judapies/Autoclave/Autoclave Horizontal/Sin Precamara/2016/Autoclave 34L UPTC #004587579/Documentos/Pruebas Autoclave Microlab/IMG_5692.JPG

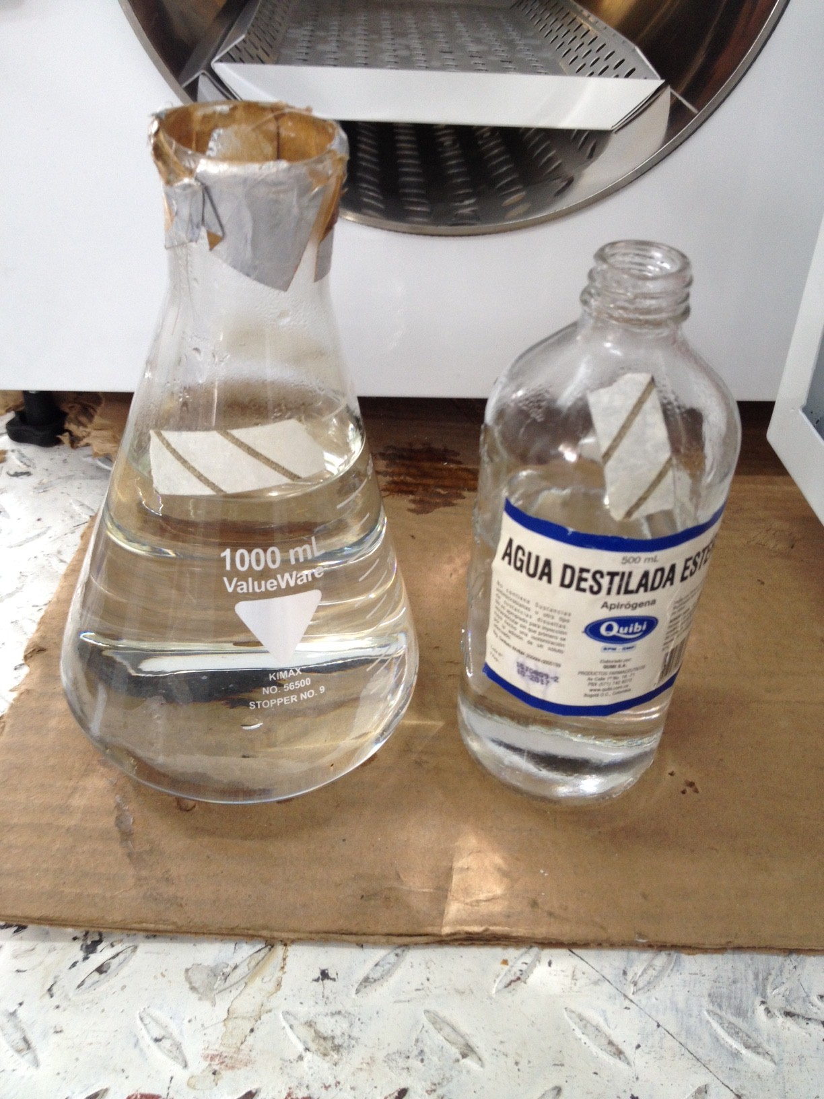
Autoclave Horizontal/Sin Precamara/2016/Autoclave 34L UPTC #004587579/Documentos/Pruebas Autoclave Microlab/IMG_5692.JPG
