judapies/Autoclave/Autoclave Horizontal/Sin Precamara/2020/Autoclave 23L Colsanitas #004588160 OP202001/Visita 23-04-2021/Notas.txt

Se cargaron 40 paquetes y aun quedaron espacios libre, la mariposa esta bastante desgastada
