judapies/Autoclave/Autoclave Horizontal/Sin Precamara/2021/Autoclave 23L Colsanitas #004588494 OP202152/Visita 14-05-2021/Notas.txt

Hicieron un ciclo con aproximadamente 60 paquetes,
Bandeja de arriba pegaba con el tanque se doblan hacia adentro primera fila para que no pegue. Se ajusta parada de emergencia suelta
