judapies/Autoclave/Autoclaves Vertical/Sin Precamara/2020/Autoclave 40L Artilab Impresora #004588218 OP2020135/Reporte de Mantenimiento #004588218_1.pdf

JP BIOINGENIERIA S.A.S

REPORTE DE MANTENIMIENTO

FJP – 68
Versión: 01

Pág. 1 de 5

PROCESO: MEDICIÓN DE SATISFACCIÓN DEL CLIENTE

Cliente: Laboratorios RYAN
Dirección: Celta Trade Park Kilómetro 7.5 Vía Medellín, Funza (Bodega 97A y 97B ) Ciudad: Funza, Cundinamarca
Nombre de Equipo: Autoclave 40 litros
Serial de Equipo: 004588218
Marca de Equipo: JP Inglobal
Modelo: 2020
Mantenimiento Preventivo: | ; Mantenimiento Correctivo: | X | (Si el mantenimiento es correctivo describa a
continuación la solicitud del mantenimiento)
Descripción: El equipo presento una fuga de presión por la parte de la puerta en las horas de la mañana del día 1/10/20 y se desajusto el empaque. Además se observa en el histórico de datos de los ciclos anteriores que el equipo presenta anormalidades en los valores de presión registrados durante los ciclos de esterilización.

### 1. Labores realizadas

Se realiza la inspección del equipo encontrando el empaque de la puerta desajustado, por lo cual se procede a ajustar realizando el sellado de este a la ranura de la puerta con silicona de alta temperatura, con el fin de no volver a presentar fuga alguna en el sello del empaque con el tanque del equipo.

Se realizaron varios ciclos al equipo encontrando una anormalidad en los datos de presión registrados, ya que el equipo al alcanzar el nivel óptimo de temperatura, su nivel de presión sigue aumentando durante el tiempo de esterilización, por tal razón se realizó un ajuste en los parámetros de control, además de hacer una observación sobre el sistema de desfogue del equipo ya que cuenta con un tanque en acero que no es el más indicado para el desfogue del equipo y que puede estar afectando su funcionamiento.

### 2. Pruebas Realizadas

- 5 Ciclos de líquidos B
- Verificación de niveles de agua.
- Verificación cierre de puerta
- Verificación de fugas

### 3. Datos Obtenidos

Posteriormente se retira el empaque y se aplica un cordón de silicona de alta temperatura en la ranura de la puerta, con el fin de que el empaque no salga de su posición y realice un sello hermético con el tanque del equipo. En las figuras 1 y 2 se puede ver como se pegó el empaque a la puerta.

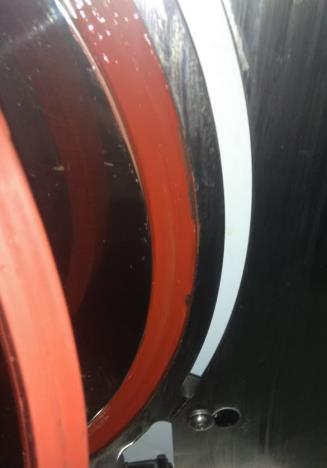
[picture p68: figure]
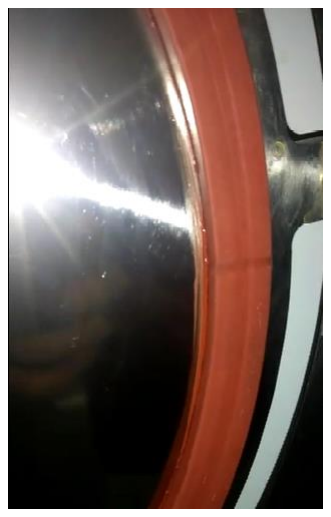
[picture p69: figure]

Figura 1. Cordón de silicona. | Figura 2. Empaque pegado.

JP BIOINGENIERIA S.A.S

REPORTE DE MANTENIMIENTO
Pág. 2 de 5

PROCESO: MEDICIÓN DE SATISFACCIÓN DEL CLIENTE

Posteriormente, se enciende el equipo, se carga con cajas de Petri envueltas en aluminio y a su vez recubiertas por una bolsa plástica corriente y una bolsa transparente utilizada para esterilización, se dispone a ejecutar el ciclo de líquidos
B. Se llena hasta el nivel de agua adecuado y se empieza el ciclo.

Se espera a que llegue a la temperatura de esterilización y se observa que antes de llegar a la temperatura deseada la presión del equipo sube sin mantener la relación con la temperatura por tal razón se decide activar la parada de emergencia para revisar la anormalidad presentada.

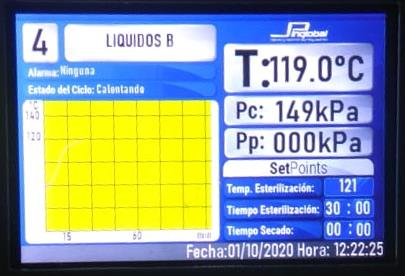
[picture p70: figure]

Figura 3. Ciclo líquidos B cancelado.

En la figura 3 se puede observar que el equipo ya está generando más presión al estar en 149 kPa o 21,6 PSI sin siquiera haber alcanzado su set point de temperatura.

Siguiente de esto se realiza un ajuste en los parámetros de control, buscando sacar la mayor cantidad de aire antes de empezar a generar presión dentro del tanque del equipo.

Se dispone a iniciar otro ciclo con la misma carga pero con los cambios anteriormente mencionados.

Después de su tiempo de calentamiento y al llegar al nivel adecuado de temperatura para empezar la esterilización se encuentra nuevamente que los valores de presión son anormales, a lo cual la persona de mantenimiento dice que sucede en la mayoría de los ciclos con carga de cajas de Petri, pero que en los ciclos donde el equipo se carga con otros materiales o en vacío el equipo funciona de manera correcta. En las figura 4,5 y 6 se puede observar la comparación de los ciclos realizados con una carga de cajas de Petri, sin carga y con una carga de 5 litros de líquidos.

JP BIOINGENIERIA S.A.S

REPORTE DE MANTENIMIENTO
Pág. 3 de 5

PROCESO: MEDICIÓN DE SATISFACCIÓN DEL CLIENTE

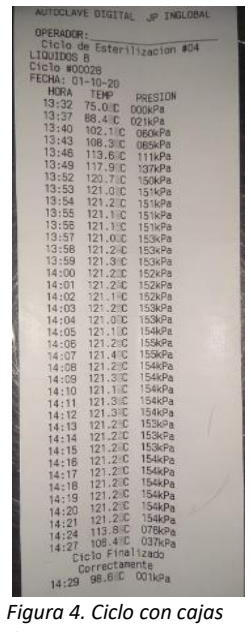
[picture p71: figure]
Figura 4. Ciclo con cajas
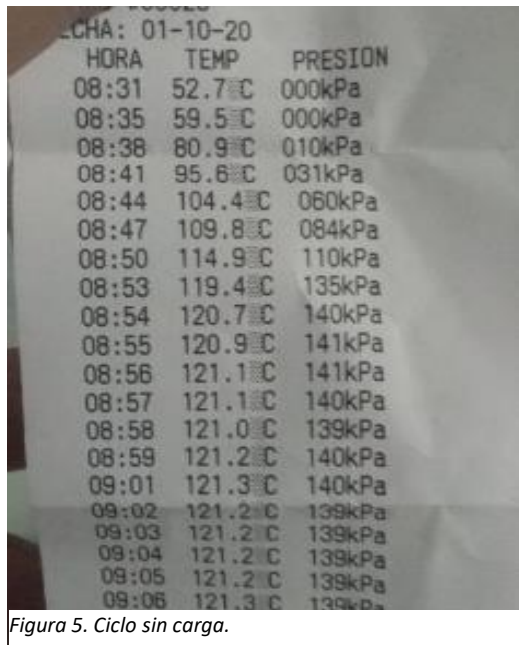
[picture p72: figure]
Figura 5. Ciclo sin carga.
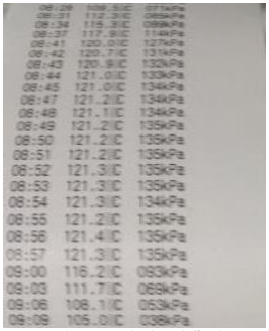
[picture p73: figure]

Figura 6. Ciclo con carga de 5 litros de líquidos.

Tabla 1. Comparativa de cargas en ciclos.

| Temperatura máxima (°C) | Presión máxima (kPa/PSI) | Fecha (DD/MM/AA) | ciclo
Ciclo con cajas de Petri (Figura 4 ) | 121.4 | 155/22.48 | 01/10/20 | Líquidos B
Ciclo con carga de 5 litros de líquidos (Figura 6 ) | 121.4 | 135/19.58 | 19/08/20 | Líquidos A
Ciclo sin carga (Figura 5) | 121.3 | 141/20.45 | 01/10/20 | Líquidos B

De la tabla se puede concluir que al introducir la cajas de Petri es cuando se presenta alteraciones en la presión, ya que también se revisaron los históricos de los datos arrojados por el equipo, en donde se encuentran valores de presión mayores y sin relación con la temperatura, en cambio con ciclos con una carga diferente o en vacío, el equipo funciona de manera correcta.

Seguido de realizar los ciclos con carga y sin carga, se observa que el desfogue del equipo es realizado en un tanque de acero ubicado a un lado de la autoclave, el tanque se encuentra con los líquidos desechados en los ciclos. Este tanque puede llegar a afectar el funcionamiento del equipo, ya que al no dejar que la válvula de desfogue realice una purga del aire que se encuentra dentro de la cámara al comienzo del ciclo, puede generar presiones superiores o presentar anomalías por el aire que queda dentro de la cámara.

de Petri.

JP BIOINGENIERIA S.A.S

REPORTE DE MANTENIMIENTO
Pág. 4 de 5

PROCESO: MEDICIÓN DE SATISFACCIÓN DEL CLIENTE

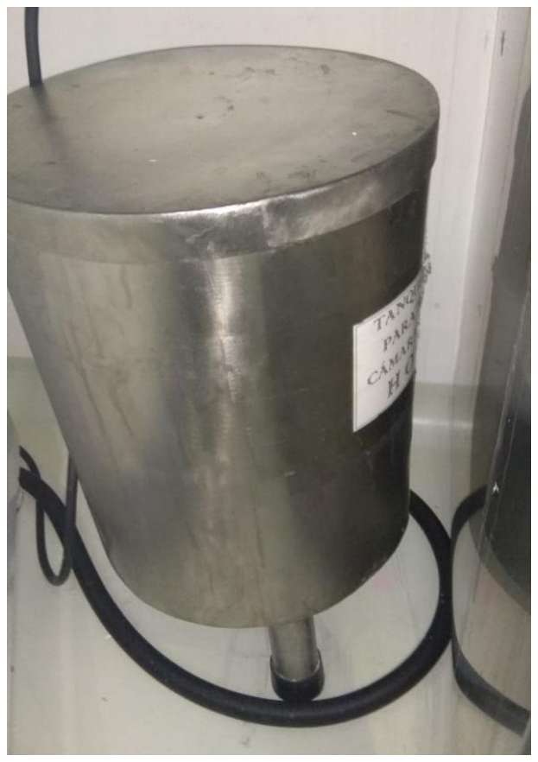
[picture p74: figure]
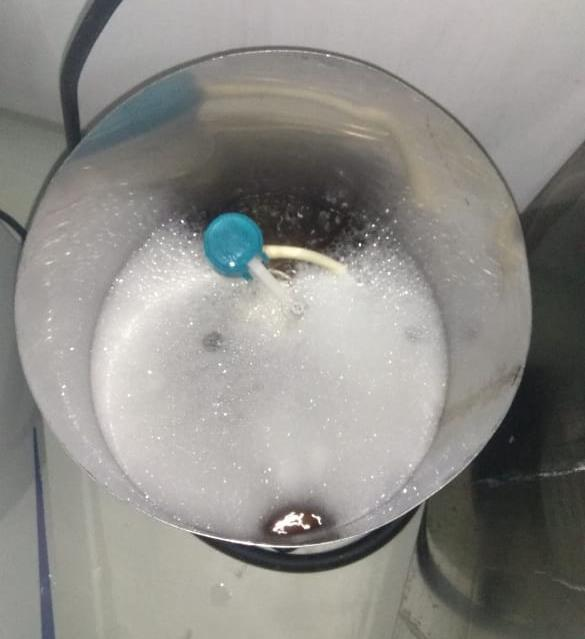
[picture p75: figure]

Al detectar esta falla se desconecta la manguera de desfogue del tanque de la figura 7 para revisar su comportamiento sin esta contrapresión generada por el agua que ocupaba el tanque.

### 4. Conclusiones

Las pruebas realizadas al equipo demuestran que presenta una anomalía en el momento de esterilizar las cajas de Petri, esto se puede generar porque los líquidos introducidos, a mayores temperaturas pueden generar algún tipo de sobrepresión que afecta la relación Presión-Temperatura del vapor de agua.

El equipo al realizar un ciclo en vacío o con una carga diferente funciona correctamente.

La fuga de presión se generó porque el empaque no estaba en uniformidad con el borde del tanque, y al soportar una alta presión este se descoloco, ocasionando una fuga por la parte de la puerta.

Los parámetros de control se encuentran con normalidad y dentro los rangos de funcionamiento sugeridos por fábrica.

Se ajustó el valor del termostato de 150°C a 200°C ya que estaba presentando una activación sin siquiera haber llegado a esa temperatura.

### 5. Observaciones

Se recomienda desconectar la manguera del tanque de desfogue y tener un tubo de desfogue con la capacidad de soportar temperaturas altas, y preferiblemente ubicado a un nivel más bajo que el equipo.

Se recomienda que antes de iniciar cualquier ciclo de esterilización se verifique lo siguiente:

Figura 7. Tanque de desfogue. | Figura 8. Líquidos residuales de desfogue.

JP BIOINGENIERIA S.A.S

REPORTE DE MANTENIMIENTO
Pág. 5 de 5

PROCESO: MEDICIÓN DE SATISFACCIÓN DEL CLIENTE

- Que el empaque de la puerta se encuentre ubicado correctamente en la ranura de la puerta antes de realizar el cierre de la misma.
- Que el empaque de la puerta se encuentre totalmente limpio y sin ningún tipo de obstrucción que pueda afectar el selle de la puerta.
- Nunca utilizar la autoclave para esterilizar productos corrosivos (ácidos, bases o fenoles), compuestos volátiles o soluciones (etanol, metanol o cloroformo) ni substancias radioactivas.
- Antes de iniciar un ciclo de esterilización, asegurarse de cerrar la puerta, ésta debe quedar debidamente bloqueada.
- Verifique que la autoclave tenga el nivel de agua adecuado antes de iniciar.
