judapies/Autoclave/Autoclave Horizontal/Sin Precamara/2017/Autoclave 23L Instruelectronic #004587635/Datos/Ciclo_Personalizado_134_01.bmp

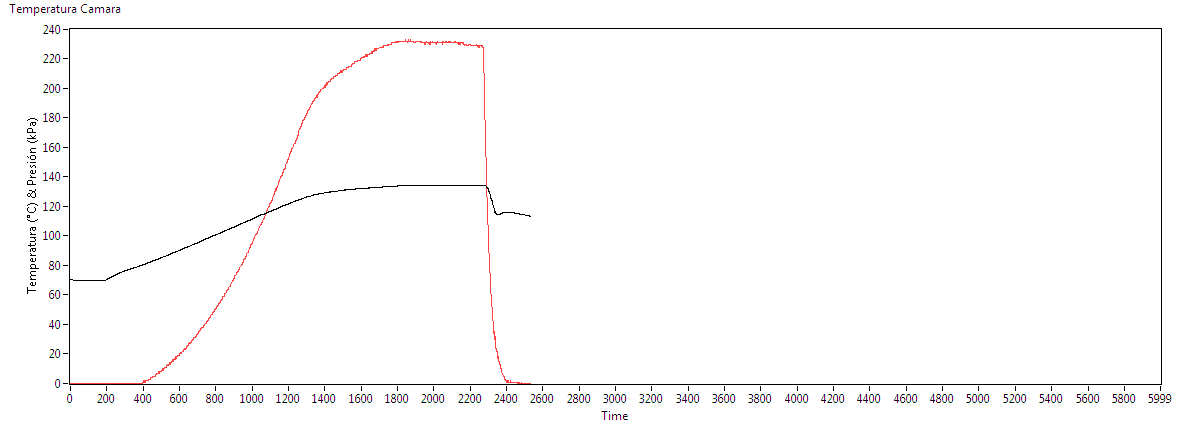
Autoclave Horizontal/Sin Precamara/2017/Autoclave 23L Instruelectronic #004587635/Datos/Ciclo_Personalizado_134_01.bmp
