judapies/Autoclave/Autoclaves Vertical/Sin Precamara/2018/Autoclave 55L Labservis #004587747/InformeRibon/ConexionadoBombas.png

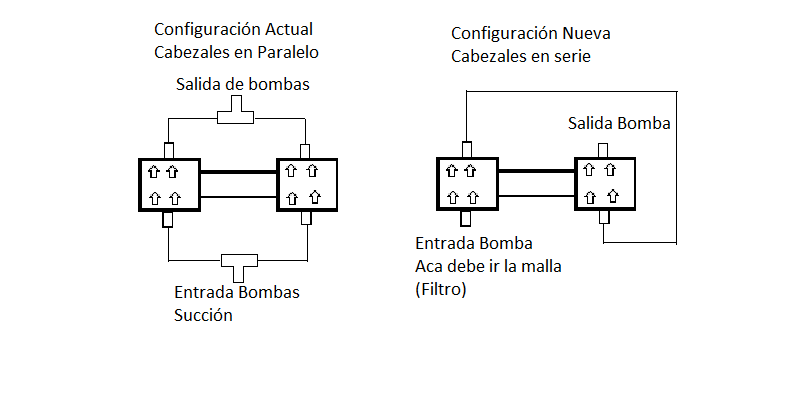
Autoclaves Vertical/Sin Precamara/2018/Autoclave 55L Labservis #004587747/InformeRibon/ConexionadoBombas.png
