judapies/Autoclave/Autoclaves Vertical/Sin Precamara/2018/Autoclave 55L Labservis #004587747/InformeRibon/WhatsApp Image 2018-07-28 at 10.06.49.jpeg

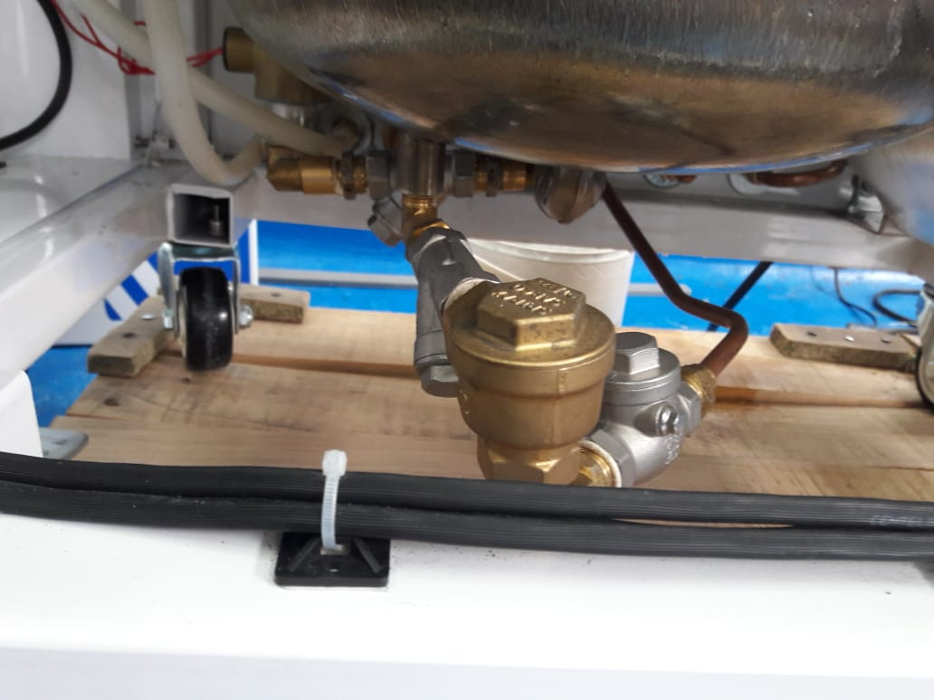
Autoclaves Vertical/Sin Precamara/2018/Autoclave 55L Labservis #004587747/InformeRibon/WhatsApp Image 2018-07-28 at 10.06.49.jpeg
