judapies/Autoclave/Listado de Componentes Octubre.xlsx

 | Autoclaves
 | Descripción | Referencia | Cantidad
 | Breaker CHINT dos polos. | 1A o 2A | 1
 |  | 16A. | 1
 | Rele 220VAC 11 pines con base. | Relpol | 1
 | Microswitch pequeño - Pivote largo roscado (para panel). | M3C | 1
 | Pulsador plastico emergencia saliente, cabeza Ø40mm. | S2ER-E3RB | 1
 | Interruptor de balancín 1 polo 27.9x13.5mm ON-OFF | 27135 / RL1-611 | 1
 | Rele de estado solido | HF 4-32VDC---25A-240VAC. | 1
 | Base para rele de estado solido | Para montaje en riel | 1
 | Clavija industrial de seguridad 1/4 de giro 20A NEMA | L14-20P | 1
 | Toma industrial de seguridad 1/4 de giro 20A NEMA | L14-20R | 1
 | Termostato | 50-300°C | 1
Ingenieros | Faiver H. Trujillo G | Juan David Piñeros E | 2014- Abr-15
