judapies/Autoclave/Autoclaves Vertical/Sin Precamara/2018/Autoclave 23L-V3.1  Handler #004587846/FJP- 35  REQUISICION DE MATERIALES AUTOCLAVE 23L.xlsx

JP BIOINGENIERIA S.A.S |  |  | REQUISICION DE MATERIALES |  |  |  |  |  |  |  | FJP - 35
 |  |  |  |  |  |  |  |  |  |  | Version 01
Efectivo a partir de: 20 Dic 2017 |  |  |  |  |  | Documento de origen: DJP- 24 |  |  |  |  | Pág. 1 de 1
FECHA
PRODUCTO: | Autoclave Vertical de 23L Sencilla |  |  |  |  |  |  | Orden de Pedido No. |  |  | 2018-220
 |  |  |  |  |  |  |  | Visita Técnica:
DESCRIPCION |  |  |  |  |  | Referencia |  |  | CANTIDAD REQUERIDA
Tarjeta de Control AutoclaveCard |  |  |  |  |  | DIELEC-AUT002 |  |  | 1
Tarjeta de Comunicación USB |  |  |  |  |  | USB-I2C |  |  | 1
Resistencias (1/4W) |  |  |  |  |  | 10K |  |  | 9
Resistencias (1/4W) |  |  |  |  |  | 1K | 1K | 1K | 8 | 10 | 10 | 10
Resistencias (1/4W) |  |  |  |  |  | 200K |  |  | 3
Resistencias (1/4W) |  |  |  |  |  | 100Ω |  |  | 2
Resistencias (1/4W) |  |  |  |  |  | 240Ω |  |  | 2
Resistencias (1/4W) |  |  |  |  |  | 330Ω |  |  | 4
Resistencia (1/4W) |  |  |  |  |  | 6,2K |  |  | 1
Resistencia de presicion (1/4W) |  |  |  |  |  | 40,2K |  |  | 1
Resistencia de presicion (1/4W) |  |  |  |  |  | 1K |  |  | 1
Reóstato | Reóstato | Reóstato | Reóstato | Reóstato | Reóstato | 10K (pequeño) | 10K (pequeño) | 10K (pequeño) | 2 | 2 | 2 | 2
Condensadores | Condensadores | Condensadores | Condensadores | Condensadores | Condensadores | 0.1 uF Monolitico | 0.1 uF Monolitico | 0.1 uF Monolitico | 2 | 28 | 28 | 28
Condensadores | Condensadores | Condensadores | Condensadores | Condensadores | Condensadores | 22 pF Ceramico | 22 pF Ceramico | 22 pF Ceramico | 4 | 4 | 4 | 4
Condensadores |  |  |  |  |  | 0.1 uF SMD | 0.1 uF Monolitico | 0.1 uF Monolitico | 7
Condensadores | Condensadores | Condensadores | Condensadores | Condensadores | Condensadores | 10 µF @ 16V | 10 µF @ 16V | 10 µF @ 16V | 2 | 2 | 2 | 2
Cristal | Cristal | Cristal | Cristal | Cristal | Cristal | 20MHz | 4MHz | 4MHz | 2 | 2 | 2 | 2
Pantalla GLCD | Pantalla LCD. Azul | Pantalla LCD. Azul | Pantalla LCD. Azul | Pantalla LCD. Azul | Pantalla LCD. Azul | 128x64 | 2X16 | 2X16 | 1 | 2 | 2 | 2
Conector GP (Con uñas) | Conector GP (Con uñas) | Conector GP (Con uñas) | Conector GP (Con uñas) | Conector GP (Con uñas) | Conector GP (Con uñas) | 4P | 2P | 2P | 2 | 4 | 4 | 4
Conector GP (Con uñas) | Conector GP (Con uñas) | Conector GP (Con uñas) | Conector GP (Con uñas) | Conector GP (Con uñas) | Conector GP (Con uñas) | 8P | 5P | 5P | 1 | 6 | 6 | 6
Conector GP (Con uñas) | Conector GP (Con uñas) | Conector GP (Con uñas) | Conector GP (Con uñas) | Conector GP (Con uñas) | Conector GP (Con uñas) | 16P | 16P | 16P | 2 | 4 | 4 | 4
Regleta profesional | Regleta profesional | Regleta profesional | Regleta profesional | Regleta profesional | Regleta profesional | 1X40 | 1X40 | 1X40 | 2 | 2 | 2 | 2
Disipador |  |  |  |  |  | Mediano |  |  | 1
Transistor | Transistor | Transistor | Transistor | Transistor | Transistor | 2N3904 | 2N3904 | 2N3904 | 1 | 2 | 2 | 2
Fuente | Puente Rectificador | Puente Rectificador | Puente Rectificador | Puente Rectificador | Puente Rectificador | IRM-20-12 | Redondo 1.5A | Redondo 1.5A | 1 | 2 | 2 | 2
Bornera | Bornera | Bornera | Bornera | Bornera | Bornera | 2 pines Verde | 2 pines Verde | 2 pines Verde | 7 | 2 | 2 | 2
Bornera | Bornera | Bornera | Bornera | Bornera | Bornera | 3 pines Verde | 2 pines Verde | 2 pines Verde | 4 | 2 | 2 | 2
Botones | Botones | Botones | Botones | Botones | Botones | Tipo huevo blanco | Tipo huevo blanco | Tipo huevo blanco | 4 | 6 | 6 | 6
Led | Led para piloto 5mm | Led para piloto 5mm | Led para piloto 5mm | Led para piloto 5mm | Led para piloto 5mm | Rojo | Chorro | Chorro | 1 | 2 | 2 | 2
Switch | Interruptor redondo | Interruptor redondo | Interruptor redondo | Interruptor redondo | Interruptor redondo | On/off | con piloto | con piloto | 1 | 2 | 2 | 2
Optocoplador | Conector cable de poder | Conector cable de poder | Conector cable de poder | Conector cable de poder | Conector cable de poder | Moc3041 | Para Chasis y terminales | Para Chasis y terminales | 2 | 2 | 2 | 2
Triac | Cable de poder grueso | Cable de poder grueso | Cable de poder grueso | Cable de poder grueso | Cable de poder grueso | BT137 | Con Polo a tierra | Con Polo a tierra | 2 | 2 | 2 | 2
Mosfet | Portafusible largo | Portafusible largo | Portafusible largo | Portafusible largo | Portafusible largo | IRRFZ44 | Para Chasis | Para Chasis | 2 | 2 | 2 | 2
Regulador | fusible | fusible | fusible | fusible | fusible | LM 317 | 250 mA | 250 mA | 1 | 2 | 2 | 2
Frenos | Conector DB25 para chasis | Conector DB25 para chasis | Conector DB25 para chasis | Conector DB25 para chasis | Conector DB25 para chasis | Con tornillo para riel omega | Hembra | Hembra | 2 | 2 | 2 | 2
Portafusible | Conector DB25 para impreso | Conector DB25 para impreso | Conector DB25 para impreso | Conector DB25 para impreso | Conector DB25 para impreso | Para riel omega | Macho | Macho | 1 | 2 | 2 | 2
Breaker bipolar | Extensión DB25 | Extensión DB25 | Extensión DB25 | Extensión DB25 | Extensión DB25 | 4A CHINT | Macho-Hembra | Macho-Hembra | 1 | 2 | 2 | 2
Breaker bipolar | Puntas de Multímetro | Puntas de Multímetro | Puntas de Multímetro | Puntas de Multímetro | Puntas de Multímetro | 16A CHINT | Negras | Negras | 1 | 2 | 2 | 2
Termostato | Bananas para puntas | Bananas para puntas | Bananas para puntas | Bananas para puntas | Bananas para puntas | 50-320° | Negras | Negras | 1 | 4 | 4 | 4
Interruptor | Banana Negra | Banana Negra | Banana Negra | Banana Negra | Banana Negra | M3C | Hembra | Hembra | 1 | 2 | 2 | 2
Boton | Conector USB TipoB | Conector USB TipoB | Conector USB TipoB | Conector USB TipoB | Conector USB TipoB | Tipo parada de emergencia | Pines atrás | Pines atrás | 1 | 2 | 2 | 2
Microcontrolador | Microcontrolador | Microcontrolador | Microcontrolador | Microcontrolador | Microcontrolador | PIC 18F4685 | PIC 18F4550 | PIC 18F4550 | 1 | 2 | 2 | 2
Terminal |  |  |  |  |  | Tipo ojo(Amarilla) |  |  | 3
Terminal |  |  |  |  |  | Tipo fastor (Azul) |  |  | 4
Terminal |  |  |  |  |  | Tipo bala(roja) |  |  | 8
Terminal |  |  |  |  |  | Tipo hembra (roja) |  |  | 8
Poste plastico | Poste plastico | Poste plastico | Poste plastico | Poste plastico | Poste plastico | Para sujecion de tarjeta | Para sujecion de tarjeta | Para sujecion de tarjeta | 4 | 8 | 8 | 8
Cable |  |  |  |  |  | 3x14 encauchetado |  |  | 3,5m
Cable |  |  |  |  |  | Con recubrimiento en fibra de vidrio #12 |  |  | 3m
Cable |  |  |  |  |  | Con recubrimiento en fibra de vidrio #18 |  |  | 1,5m
Cable |  |  |  |  |  | Blindado 20x20 |  |  | 0,6m
Cable |  |  |  |  |  | Blindado 8x22 |  |  | 0,7m
clavija industrial de seguridad |  |  |  |  |  | L6-20P |  |  | 1
Toma de Incrustar Industrial |  |  |  |  |  | L6-20R |  |  | 1
Cable de instrumentacion |  |  |  |  |  | 3x20AWG |  |  | 0,5m
Terminal |  |  |  |  |  | Tipo U azúl |  |  | 2
Codo Macho-Hembra |  |  |  |  |  | 3/8" NPT |  |  | 2
Union Macho-Macho |  |  |  |  |  | 1/2" NPT a 3/8" NPT |  |  | 2
Union Macho-Macho |  |  |  |  |  | 3/8" NPT a 1/4" NPT |  |  | 1
Racord macho abocardado |  |  |  |  |  | 3/8" NPT a 1/4" con tuercas |  |  | 3
Racord macho abocardado |  |  |  |  |  | 1/4" NPT a 1/4" con tuercas |  |  | 3
Racord macho abocardado |  |  |  |  |  | 1/8" NPT a 1/4" con tuercas |  |  | 1
Racord Hembra a abocardado |  |  |  |  |  | 1/4" NPT a 1/4" con tuercas |  |  | 2
Racord macho a compresion con anillo y tuerca |  |  |  |  |  | 3/8"NPT a 5/16" con anillo y tuerca |  |  | 1
T hembra |  |  |  |  |  | 1/4" NPT |  |  | 2
Buchin |  |  |  |  |  | 1/4"NPT Macho a 1/8" NPT Hembra |  |  | 2
Buchin |  |  |  |  |  | 3/8"NPT Macho a 1/8"NPT Hembra |  |  | 1
Buchin |  |  |  |  |  | 3/8" NPT Macho a 1/4" NPT Hembra |  |  | 2
Acople estriado para manguera |  |  |  |  |  | 1/8"NPT Macho a 1/8" para manguera |  |  | 1
Union Hembra |  |  |  |  |  | 3/8" NPT |  |  | 1
Codo Hembra |  |  |  |  |  | 3/8"NPT en Inox |  |  | 1
Filtro en Y |  |  |  |  |  | 1/2" NPT Inox |  |  | 1
Electrovalvula 220VAC NC para vapor |  |  |  |  |  | 3/8" NPT |  |  | 1
Manometro conexión trasera 1/4" |  |  |  |  |  | Sin glicerina |  |  | 1
Acople estriado para manguera INOX |  |  |  |  |  | 1/2" X 1/4" abocardado |  |  | 1
Mini Valvula de bola |  |  |  |  |  | 3/8"NPT |  |  | 1
Valvula de seguridad para vapor |  |  |  |  |  | Tipo llavero SET: 40 PSI |  |  | 1
Ventilador Axial |  |  |  |  |  | 33507 |  |  | 2
Pasacable | PortaLED | PortaLED | PortaLED | PortaLED | PortaLED | Pg 11 | Para LED de 5mm | Para LED de 5mm | 3 | 10 | 10 | 10
SOLICITADO POR: |  |  |  |  | ENTREGADO POR: |  |  |  | RECIBIDO POR:
