judapies/Autoclave/Autoclave Horizontal/Con Precamara/2018/Autoclave 85L con vacio  #004587822/Materiales/Materiales AUTH85L.xlsx

Sheet: Hoja1
Componentes Autoclave 85LH INVIMA | Columna1
Descripción Elemento | Cantidad | Sitio de Compra
Teflon Liquido LOCTITE 567 | 2
Tuberia de Cobre Flexible, Diametro: 1/2" | 1 Rollo (15m)
Union Macho-Macho de 1/2" NPT | 8
T Hembra de 1/4" NPT | 2
Union Macho-Macho de 1/4" NPT | 1
Racor de 1/4" NPT Macho a 1/4" Abocardado con tuercas | 4
Racor de 1/4" NPT Hembra a 1/4" Abocardado con tuercas | 4
Buchin de 1/4" NPT Macho a 1/8" NPT Hembra | 2
Acople estriado de 1/8" a macho 1/8" NPT | 2
Racor de 1/2" NPT Macho a Racor de compresion de 1/2" con anillos y tuercas | 12
T Hembra de 1/2" NPT | 1
T Hembra de 3/8" NPT | 1
Union Macho-Macho de 3/8"NPT | 2
Union Macho-Macho de 1/2"NPT a 3/8"NPT | 6
Union Macho-Macho de 1/2"NPT a 1/4"NPT | 2
Acople estriado de 1/4" a macho 3/8" NPT | 2
Acople estriado de 1/4" a macho 1/2" NPT | 2
Codo Macho-Hembra de 1/8" NPT | 8
T de Acople Estriado de 1/4 | 3
Acople estriado de 1/4" a macho 1/8" NPT | 8
Racor de 3/8"NPT Hembra a Racor de compresion de 1/2" con anillos y tuercas | 5
Dobla tubo de para tuberia de 1/2" | 1

Sheet: Hoja2
Pendientes Autoclave Vertical 55L
Descripción Elemento | Cantidad | Sitio de Compra
Filtros de 1/2" en Inox para vapor | 3
Valvula de Bola Inox de 3/8" | 1
Teflon Liquido LOCTITE 567 | 1
Tuberia de Cobre Flexible, Diametro: 1/4" | 1 Rollo (15m)
Tuberia de Cobre Flexible, Diametro: 3/8" | 1 Rollo (15m)
