judapies/Autoclave/Autoclave Horizontal/Con Precamara/2019/Autoclave 250L Doble Puerta UCC#004588085/Materiales/Materiales AUT250L.xlsx

Sheet: Hoja1
Componentes Hidraulicos y/o Neumaticos Autoclave 250L | Columna1
Descripción Elemento | Cantidad
Bushing de 1/2" Macho NPT a 3/8" Hembra NPT en Inox | 6
Bushing de 1/2" Macho NPT a 1/4" Hembra NPT en Inox | 10
Bushing de 1" Macho NPT a 1/2" Hembra NPT en Inox | 2
Bushing de 3/4" Macho NPT a 1/2" Hembra NPT en Inox | 3
Universal de 1/2" NPT en inox | 7
Codo Calle de 1/2" NPT en inox | 15
Codo Hembra de 1/2" NPT en inox | 2
T Hembra de 1/2" en inox | 6
T Hembra de 1/4" en inox | 1
Cruz Hembra de 1/2" NPT en inox | 3
Union macho de 1/2" NPT con hexagono en inox | 32
Union macho de 1/4" NPT con hexagono en inox | 1
Union hembra de 3/4" NPT en inox | 2
Union hembra de 1/2" NPT en inox | 2
Niple de 1/2" X 3" en inox | 1
Niple de 1/2" X 5" en inox | 1
Tapon Macho en inox de 1/4" NPT | 2
Tapon hembra de 1/2" en inox | 1
Acople estriado para manguera de 1/2" NPT Macho a 3/4" Espigo en inox | 1
Acople estriado para manguera de 1/4" NPT Macho a 3/16" Espigo en inox | 2
Racor de 1/2" NPT Macho a 1/2" Tuerca y anillo Swagelok | 15
Racor de 1/4" NPT Macho a 1/4" Tuerca y anillo Swagelok | 10
Racor de 1/4" NPT Hembra a 1/4" Tuerca y anillo Swagelok | 8
Valvula de globo de 1/2"NPT en inox para vapor | 1
Cheque Hidro para vapor de 1/2" NPT en inox | 4
Prestolok union macho de 6mm X 1/4" | 30
Prestolok union Hembra de 6mm X 1/4" | 4
Prestolok TEE union de 6mm | 2
Prestolok union macho de 6mm X 1/4" en Inox (En rosca y sujecion de manguera) | 2
Manovacuometro de -30inHG a 60PSI Caratula de 2"1/2, conexión trasera de 1/4" sin Glicerina | 3
Manometro de 0-160 PSI Caratula de 2"1/2, conexión trasera de 1/4" sin Glicerina | 2
Valvula de bola en inox de 1/2" | 4

Sheet: Hoja2
Pendientes Autoclave Vertical 55L
Descripción Elemento | Cantidad | Sitio de Compra
Filtros de 1/2" en Inox para vapor | 3
Valvula de Bola Inox de 3/8" | 1
Teflon Liquido LOCTITE 567 | 1
Tuberia de Cobre Flexible, Diametro: 1/4" | 1 Rollo (15m)
Tuberia de Cobre Flexible, Diametro: 3/8" | 1 Rollo (15m)
