judapies/Autoclave/Autoclave Horizontal/Con Precamara/2020/Autoclave 85L Neumatica Sinergia Pharma OP2020176 #004588343/Plano Hidraulico/MaterialesTuberia.xlsx

DESCRIPCION | CANTIDAD
Cheque Hidro para vapor de 1/2" en Inox | 3
Filtro en Y en Inox de malla fina 1/2" | 7
Flotador en acero inoxidable de 1/2" | 2
Valvula de bola de 1/2" en inox | 4
Presostato Danfoss KPI35 | 2
Valvula de seguridad en Inox de 1/2" SET:40PSI | 2
Valvula de seguridad en Inox de 1/2" SET:45PSI | 1
Bomba de agua 220VAC | 1
Enfriador de placas de 5Ton | 1
T en acero inoxidable de 1/2" | 6
Cruz en acero inoxidable de 1/2" | 1
Union macho con hexagono de 1/2" en inox | 25
Codo calle en inox de 1/2" | 20
Tuberia flexible en acero Inox 1/2" | 6m
Tuberia flexible en acero Inox 1/4" | 6m
Bushing de 1" a 1/2" en inox | 2
Bushing de 1/2" a 3/8" en inox | 10
Racor en inox de 1/2" NPT Macho a Tubing de 1/2" Swagelok | 10
Racor en inox de 1/4" NPT Macho a Tubing de 1/4" Swagelok | 8
Racor en inox de 1/4" NPT Hembra a Tubing de 1/4" Swagelok | 7
Acople estriado para manguera de 1/2" NPT a 3/4" Espigo en inox | 1
Acople estriado para manguera de 1/4" NPT Macho a 3/16" Espigo en inox | 2
Universal en acero inoxidable de 1/2" | 10
Valvula de globo de 1/2" | 1
Niple de 1/2" X 2" en inox | 5
Niple de 1/2" X 3" en inox | 10
Niple de 1/2" X 5" en inox | 5
