judapies/Autoclave/Autoclave Horizontal/Con Precamara/2021/Autoclave 250L Avantika  OP2020414 #004588570/SGC/FJP- 35  REQUISICION DE MATERIALES AUTOCLAVE HORIZONTAL NEXTION.xlsx

JP BIOINGENIERIA S.A.S |  |  | REQUISICION DE MATERIALES |  |  |  |  |  |  |  | FJP - 35
 |  |  |  |  |  |  |  |  |  |  | Version 01
Efectivo a partir de: 20 Dic 2017 |  |  |  |  |  | Documento de origen: DJP- 24 |  |  |  |  | Pág. 1 de 1
FECHA | 24 | 1 | 2020
PRODUCTO: | Autoclave Vertical 62L |  |  |  |  |  |  | Orden de Pedido No. |  |  | 202002
 |  |  |  |  |  |  |  | Visita Técnica:
DESCRIPCION |  |  |  |  |  | Referencia |  |  | CANTIDAD REQUERIDA
Tarjeta de Control AutoclaveCard |  |  |  |  |  | DIELEC-AUT005 |  |  | 1
Tarjeta de Comunicación USB |  |  |  |  |  | USB-I2C |  |  | 1
Resistencias Montaje Superficial 0805 |  |  |  |  |  | 10K |  |  | 4
Resistencias Montaje Superficial 0805 |  |  |  |  |  | 1K | 1K | 1K | 12 | 10 | 10 | 10
Resistencias Montaje Superficial 0805 |  |  |  |  |  | 200K |  |  | 3
Resistencias Montaje Superficial 0805 |  |  |  |  |  | 100Ω |  |  | 2
Resistencias (1/4W) |  |  |  |  |  | 240Ω |  |  | 1
Resistencias Montaje Superficial 0805 |  |  |  |  |  | 470Ω |  |  | 4
Resistencia de presicion (1/4W) |  |  |  |  |  | 6,8K |  |  | 2
Resistencia de presicion (1/4W) |  |  |  |  |  | 100Ω |  |  | 1
Resistencia de presicion (1/4W) |  |  |  |  |  | 470Ω |  |  | 1
Resistencias Montaje Superficial 1206 |  |  |  |  |  | 10K |  |  | 1
Condensador Ceramico SMD |  |  |  |  |  | 22pF |  |  | 2
Condensadores | Condensadores | Condensadores | Condensadores | Condensadores | Condensadores | 22 pF Ceramico | 22 pF Ceramico | 22 pF Ceramico | 2 | 4 | 4 | 4
Condensadores |  |  |  |  |  | 0.1 uF SMD | 0.1 uF Monolitico | 0.1 uF Monolitico | 9
Condensadores | Condensadores | Condensadores | Condensadores | Condensadores | Condensadores | 10 µF @ 16V | 10 µF @ 16V | 10 µF @ 16V | 2 | 2 | 2 | 2
Condensadores | Condensadores | Condensadores | Condensadores | Condensadores | Condensadores | 100 µF @ 16V | 10 µF @ 16V | 10 µF @ 16V | 2 | 2 | 2 | 2
Cristal | Cristal | Cristal | Cristal | Cristal | Cristal | 20MHz | 4MHz | 4MHz | 2 | 2 | 2 | 2
Pantalla TFT | Pantalla LCD. Azul | Pantalla LCD. Azul | Pantalla LCD. Azul | Pantalla LCD. Azul | Pantalla LCD. Azul | Nextion 3.5" | 2X16 | 2X16 | 1 | 2 | 2 | 2
Conector GP (Con uñas) | Conector GP (Con uñas) | Conector GP (Con uñas) | Conector GP (Con uñas) | Conector GP (Con uñas) | Conector GP (Con uñas) | 4P | 2P | 2P | 3 | 4 | 4 | 4
Conector GP (Con uñas) | Conector GP (Con uñas) | Conector GP (Con uñas) | Conector GP (Con uñas) | Conector GP (Con uñas) | Conector GP (Con uñas) | 8P | 5P | 5P | 1 | 6 | 6 | 6
Regleta profesional | Regleta profesional | Regleta profesional | Regleta profesional | Regleta profesional | Regleta profesional | 1X40 | 1X40 | 1X40 | 3 | 2 | 2 | 2
Conversor DC a Fuente Simetrica | Regulador 5V | Regulador 5V | Regulador 5V | Regulador 5V | Regulador 5V | XY--+-12V | LM 7805 | LM 7805 | 1 | 2 | 2 | 2
Transistor SOT-23 |  |  |  |  |  | MMBT2222A | 2N3904 | 2N3904 | 4 | 2 | 2 | 2
Fuente | Puente Rectificador | Puente Rectificador | Puente Rectificador | Puente Rectificador | Puente Rectificador | IRM-20-5 | Redondo 1.5A | Redondo 1.5A | 1 | 2 | 2 | 2
Bornera | Bornera | Bornera | Bornera | Bornera | Bornera | 2 pines Verde | 2 pines Verde | 2 pines Verde | 9 | 2 | 2 | 2
Bornera | Bornera | Bornera | Bornera | Bornera | Bornera | 3 pines Verde | 2 pines Verde | 2 pines Verde | 4 | 2 | 2 | 2
Botones | Botones | Botones | Botones | Botones | Botones | Tipo huevo blanco | Tipo huevo blanco | Tipo huevo blanco | 4 | 6 | 6 | 6
Led Montaje Superficial 0805 | Led para piloto 5mm | Led para piloto 5mm | Led para piloto 5mm | Led para piloto 5mm | Led para piloto 5mm | Rojo o Azul o Verde | Chorro | Chorro | 4 | 2 | 2 | 2
Switch | Interruptor redondo | Interruptor redondo | Interruptor redondo | Interruptor redondo | Interruptor redondo | ON-OFF | con piloto | con piloto | 1 | 2 | 2 | 2
Rele de estado solido para impreso | Conector cable de poder | Conector cable de poder | Conector cable de poder | Conector cable de poder | Conector cable de poder | G3MB-202P | Para Chasis y terminales | Para Chasis y terminales | 3 | 2 | 2 | 2
Mosfet | Portafusible largo | Portafusible largo | Portafusible largo | Portafusible largo | Portafusible largo | IRRFZ44 | Para Chasis | Para Chasis | 2 | 2 | 2 | 2
Memoria EEPROM montaje Superficial | Portafusible largo | Portafusible largo | Portafusible largo | Portafusible largo | Portafusible largo | 24LC512-I/SM | Para Chasis | Para Chasis | 1 | 2 | 2 | 2
Portapilas para impreso |  |  |  |  |  | Para bateria CR2032 |  |  | 1
Buzzer |  |  |  |  |  | 5v o 12v |  |  | 1
Diodo Montaje Superficial |  |  |  |  |  | FM4004 |  |  | 1
RTC Montaje Superficial |  |  |  |  |  | DS1302S |  |  | 1
Cristal de Quarzo |  |  |  |  |  | 32768khz (RTC) |  |  | 1
Regulador Montaje Superficial | fusible | fusible | fusible | fusible | fusible | LM 317M | 250 mA | 250 mA | 1 | 2 | 2 | 2
Sensor de Presion Diferencial | fusible | fusible | fusible | fusible | fusible | MPX5700DP | 250 mA | 250 mA | 1 | 2 | 2 | 2
Conector USB Tipo B |  |  |  |  |  | Para impreso |  |  | 1
Microcontrolador |  |  |  |  |  | PIC18F2550 |  |  | 1
Amplificador de Instrumentacion |  |  |  |  |  | AD620 |  |  | 1
Sensor PT100 |  |  |  |  |  | 3/8"NPT X 15mm |  |  | 1
Frenos | Conector DB25 para chasis | Conector DB25 para chasis | Conector DB25 para chasis | Conector DB25 para chasis | Conector DB25 para chasis | Con tornillo para riel omega | Hembra | Hembra | 2 | 2 | 2 | 2
Portafusible | Conector DB25 para impreso | Conector DB25 para impreso | Conector DB25 para impreso | Conector DB25 para impreso | Conector DB25 para impreso | 36900 | Macho | Macho | 2 | 2 | 2 | 2
Fusible de accionamiento rapido 20A | Conector DB25 para impreso | Conector DB25 para impreso | Conector DB25 para impreso | Conector DB25 para impreso | Conector DB25 para impreso | 36894 | Macho | Macho | 2 | 2 | 2 | 2
Breaker bipolar | Extensión DB25 | Extensión DB25 | Extensión DB25 | Extensión DB25 | Extensión DB25 | 4A CHINT | Macho-Hembra | Macho-Hembra | 1 | 2 | 2 | 2
Termostato | Bananas para puntas | Bananas para puntas | Bananas para puntas | Bananas para puntas | Bananas para puntas | 50-320°C | Negras | Negras | 1 | 4 | 4 | 4
Interruptor | Banana Negra | Banana Negra | Banana Negra | Banana Negra | Banana Negra | M3C | Hembra | Hembra | 1 | 2 | 2 | 2
Pulsador parada de emergencia | Conector USB TipoB | Conector USB TipoB | Conector USB TipoB | Conector USB TipoB | Conector USB TipoB | S2ER-E3RB | Pines atrás | Pines atrás | 1 | 2 | 2 | 2
Ventilador Axial |  |  |  |  |  | 33507 |  |  | 2
Rele de estado solido |  |  |  |  |  | 46906-1 |  |  | 1
Disipador para rele de estado solido |  |  |  |  |  | 46956 |  |  | 1
Microcontrolador | Microcontrolador | Microcontrolador | Microcontrolador | Microcontrolador | Microcontrolador | PIC 18F4685 | PIC 18F4550 | PIC 18F4550 | 1 | 2 | 2 | 2
Resistencias |  |  |  |  |  | 220VAC
Terminal |  |  |  |  |  | Tipo ojo(Amarilla) |  |  | 3
Terminal |  |  |  |  |  | Tipo fastor (Azul) |  |  | 4
Terminal |  |  |  |  |  | Tipo bala(roja) |  |  | 8
Terminal |  |  |  |  |  | Tipo hembra (roja) |  |  | 8
Poste plastico | Poste plastico | Poste plastico | Poste plastico | Poste plastico | Poste plastico | Para sujecion de tarjeta | Para sujecion de tarjeta | Para sujecion de tarjeta | 4 | 8 | 8 | 8
Cable |  |  |  |  |  | 3x12 encauchetado |  |  | 3,5m
Cable |  |  |  |  |  | Con recubrimiento en fibra de vidrio #12 |  |  | 1m
Cable |  |  |  |  |  | Con recubrimiento en fibra de vidrio #18 |  |  | 1,2m
Cable |  |  |  |  |  | Blindado 8x22 |  |  | 30cm
Pasacable | PortaLED | PortaLED | PortaLED | PortaLED | PortaLED | PG11 | Para LED de 5mm | Para LED de 5mm | 3 | 10 | 10 | 10
Clavija Industrial de seguridad | PortaLED | PortaLED | PortaLED | PortaLED | PortaLED | L6-20P | Para LED de 5mm | Para LED de 5mm | 1 | 10 | 10 | 10
Toma de Incrustar Industrial | PortaLED | PortaLED | PortaLED | PortaLED | PortaLED | L6-20R | Para LED de 5mm | Para LED de 5mm | 1 | 10 | 10 | 10
Cable de instrumentacion | PortaLED | PortaLED | PortaLED | PortaLED | PortaLED | 3X20AWG | Para LED de 5mm | Para LED de 5mm | 0,5m | 10 | 10 | 10
Terminales tipo U | PortaLED | PortaLED | PortaLED | PortaLED | PortaLED |  |  |  | 2 | 10 | 10 | 10
SOLICITADO POR: |  |  |  |  | ENTREGADO POR: |  |  |  | RECIBIDO POR:
