judapies/Autoclave/Autoclave Horizontal/Con Precamara/2021/Autoclave 62L Dempharma SAS OP2021108 #004588634/Plano Hidraulico/MaterialesTuberia.xlsx

DESCRIPCION | CANTIDAD
Cheque Hidro para vapor de 1/2" en Inox | 10
Filtro en Y en Inox de malla fina 1/2" | 10
Flotador en acero inoxidable de 1/2" | 4
Valvula de bola de 1/2" en inox | 4
Presostato Danfoss KPI35 | 4
Valvula de seguridad en Inox de 1/2" SET:40PSI | 2
Valvula de seguridad en Inox de 1/2" SET:45PSI | 4
Bomba de agua 220VAC | 2
Enfriador de placas de 5Ton | 0
T en acero inoxidable de 1/2" | 8
T en acero inoxidable de 1/4" | 6
Union macho con hexagono de 1/2" en inox | 35
Union macho con hexagono de 1/4" en inox | 4
Codo calle en inox de 1/4" | 4
Codo calle en inox de 1/2" | 15
Codo en inox de 1/2" | 15
Valvula de bola de 1/4" en inox | 4
Tuberia flexible en acero Inox 1/2"
Tuberia flexible en acero Inox 1/4"
Bushing de 1" a 1/2" en inox | 0
Bushing de 1/2" a 3/8" en inox | 0
Bushing de 1/2" a 1/4" en inox | 6
Racor en inox de 1/2" NPT Macho a Tubing de 1/2" Swagelok | 5
Racor en inox de 1/4" NPT Macho a Tubing de 1/4" Swagelok | 10
Racor en inox de 1/4" NPT Hembra a Tubing de 1/4" Swagelok | 15
Acople estriado para manguera de 1/2" NPT a 1/2" Espigo en inox | 20
Acople estriado para manguera de 1/4" NPT Macho a 3/16" Espigo en inox | 12
Universal en acero inoxidable de 1/2" | 10
Valvula de globo de 1/2" | 1
Niple de 1/2" X 2" en inox | 5
Niple de 1/2" X 3" en inox | 5
Niple de 1/2" X 5" en inox | 5
Niple de 1/2" X 10" en inox | 1
