judapies/Autoclave/Autoclave Horizontal/Con Precamara/2018/Autoclave 110L-V3.1 TIM #004587910/Materiales/Listado de Componentes Autoclave.xlsx

Sheet: Parte Electronica
 | Autoclave GLCD
 | Descripción | Referencia | Cantidad | Precio Unitario | Precio Total | Sitio de Compra | Dirección
 | Regleta Profesional | 40 pines | 3 | $1200 | $3600 | Sanyvi Electronics | Cra 9 # 19-30 LOC:212
 | Conector GP | 2 pines | 2 | $300 | $600 | Sanyvi Electronics | Cra 9 # 19-30 LOC:212
 |  | 3 pines | 5 | $300 | $1500 | Sanyvi Electronics | Cra 9 # 19-30 LOC:212
 |  | 4 pines | 3 | $400 | $1200 | Sanyvi Electronics | Cra 9 # 19-30 LOC:212
 |  | 6 pines | 3 | $500 | $1500 | Sanyvi Electronics | Cra 9 # 19-30 LOC:212
 |  | 8 pines | 1 | $600 | $600 | Sanyvi Electronics | Cra 9 # 19-30 LOC:212
 |  | 10 pines | 1 | $700 | $700 | Sanyvi Electronics | Cra 9 # 19-30 LOC:212
 |  | 16 pines | 2 | $800 | $1600 | Sanyvi Electronics | Cra 9 # 19-30 LOC:212
 | Borneras | 2 pines verde | 2 | $350 | $700 | Sanyvi Electronics | Cra 9 # 19-30 LOC:212
 |  | 3 pines verde | 10 | $400 | $4000 | Sanyvi Electronics | Cra 9 # 19-30 LOC:212
 | Amplificador Operacional | LM324 | 2 | $500 | $1000 | Sigma Electronica Ltda | Av. Cra 24 No 61D-65
 | Reostato | 10K | 4 | $300 | $1200 | Sanyvi Electronics | Cra 9 # 19-30 LOC:212
 | Regulador de Voltaje | LM 7805 | 1 | $550 | $550 | Sanyvi Electronics | Cra 9 # 19-30 LOC:212
 |  | LM317 | 1 | $1000 | $1000 | Sanyvi Electronics | Cra 9 # 19-30 LOC:212
 | Puente Rectificador | Redondo 1.5A | 1 | $400 | $400 | Sanyvi Electronics | Cra 9 # 19-30 LOC:212
 | Resistencias (1/4W) | 240 Ω | 2 | $10 | $20 | Sanyvi Electronics | Cra 9 # 19-30 LOC:212
 |  | 300 Ω | 8 | $10 | $80 | Sanyvi Electronics | Cra 9 # 19-30 LOC:212
 |  | 1K | 6 | $10 | $60 | Sanyvi Electronics | Cra 9 # 19-30 LOC:212
 |  | 10K | 20 | $10 | $200 | Sanyvi Electronics | Cra 9 # 19-30 LOC:212
 |  | 1M | 4 | $10 | $40 | Sanyvi Electronics | Cra 9 # 19-30 LOC:212
 | Resistencia de precision | 1K | 2 | $500 | $1000 | Electronica China | Calle 21 # 9-12
 |  | 6,2K | 2 | $50 | $100 | Electronica China | Calle 21 # 9-12
 |  | 40,2K | 2 | $1000 | $2000 | Electronica China | Calle 21 # 9-12
 | Condensador Electrolitico | 470uF---25V | 1 | $250 | $250 | Sanyvi Electronics | Cra 9 # 19-30 LOC:212
 |  | 10uF---25V | 1 | $150 | $150 | Sanyvi Electronics | Cra 9 # 19-30 LOC:212
 | Condensador | 0.1uF Monolitico | 5 | $600 | $3000 | Sanyvi Electronics | Cra 9 # 19-30 LOC:212
 |  | 22pF ceramico | 4 | $100 | $400 | Sanyvi Electronics | Cra 9 # 19-30 LOC:212
 |  | 0.1uF de superficie Tantalio | 10 | $290 | $2900 | Sigma Electronica Ltda | Av. Cra 24 No 61D-65
 | Cristal de quarzo | 4MHz | 2 | $450 | $900 | Sanyvi Electronics | Cra 9 # 19-30 LOC:212
 | Triac | BTA-16 | 6 | $2030 | $12180 | Sigma Electronica Ltda | Av. Cra 24 No 61D-65
 | Optoacoplador | MOC 3031 | 6 | $2088 | $12528 | Sigma Electronica Ltda | Av. Cra 24 No 61D-66
 | Display Grafico Azul | 128X64 | 1 | $55013 | $55013 | Sigma Electronica Ltda | Av. Cra 24 No 61D-67
 | Transformador | 220VAC a 0-9-12VAC | 1 | $20000 | $20000 | Bobinados Especiales | Calle 21 # 8-81 Ofc:303
 | Fusible Corto | 500 mA maximo | 1 | $100 | $100 | Sanyvi Electronics | Cra 9 # 19-30 LOC:212
 | Portafusible Aereo | Para fusible corto | 1 | $600 | $600 | Sanyvi Electronics | Cra 9 # 19-30 LOC:212
 | Poste plastico | Para sujecion de tarjeta | 8 | $150 | $1200 | Sanyvi Electronics | Cra 9 # 19-30 LOC:212
 | Microcontrolador | PIC 18F4550 | 2 | $15000 | $30000 | Sanyvi Electronics | Cra 9 # 19-30 LOC:212
 | Disipador Mediano | Para LM7805 | 2 | $2500 | $5000 | Sanyvi Electronics | Cra 9 # 19-30 LOC:212
 | Botones | Tipo huevo blanco | 4 | $1800 | $7200 | ATM Store SAS | Cra 9 # 19-30 LOC: 117
 | Conector USB Tipo B | Pines atrás | 1 | $900 | $900 | Sanyvi Electronics | Cra 9 # 19-30 LOC:212
 | Tarjetas Electronicas | Control | 1 | $20000 | $20000 | Yahiko Electronica Ltda | Calle 20 # 8-87
 | Sensor de Presión | MPX5700DP | 1 | $50000 | $50000 | Moviltronics | Cra 9 # 20-13 LOC:101
 | Mosfet | IRFZ44N | 2 | $2000 | $4000 | Sanyvi Electronics | Cra 9 # 19-30 LOC:212
 |  |  |  |  | $249971 | TOTAL
Ingenieros | Faiver H. Trujillo G | Juan David Piñeros E | 2014- Abr-15

Sheet: Parte Electrica
 | Autoclaves
 | Descripción | Referencia | Cantidad | Precio Unitario | Precio Total
 | Breaker CHINT dos polos. | 1A o 2A | 1 | $20000 | $20000
 |  | 20A. | 1 | $20000 | $20000
 | Microswitch pequeño - Pivote largo roscado (para panel). | M3C | 1 | $26000 | $26000
 | Pulsador plastico emergencia saliente, cabeza Ø40mm. | S2ER-E3RB | 1 | $15700 | $15700
 | Interruptor de balancín 1 polo 27.9x13.5mm ON-OFF | 27135 / RL1-611 | 1 | $3500 | $3500
 | Rele de estado solido | HF 4-32VDC---25A-240VAC. | 1 | $45000 | $45000
 | Disipador negro para rele de estado solido | Para montaje en riel | 1 | $14000 | $14000
 | Clavija industrial de seguridad 1/4 de giro 20A NEMA | L14-20P | 1 | $25000 | $25000
 | Toma industrial de seguridad 1/4 de giro 20A NEMA | L14-20R | 1 | $28000 | $28000
 | Termostato | 50-300°C | 1 | $30000 | $30000
 | Frenos para riel |  | 2 | $500 | $1000
 | Regleta de polietileno | 30A | 1 | $2500 | $2500
 |  |  |  | $230200 | $230700
Ingenieros | Faiver H. Trujillo G | Juan David Piñeros E | 2014- Abr-15
