judapies/Autoclave/Autoclave Horizontal/Con Precamara/2016/Autoclave 110L/Autoclave Santa Marta/Schematic/AutoclaveCard.DXF

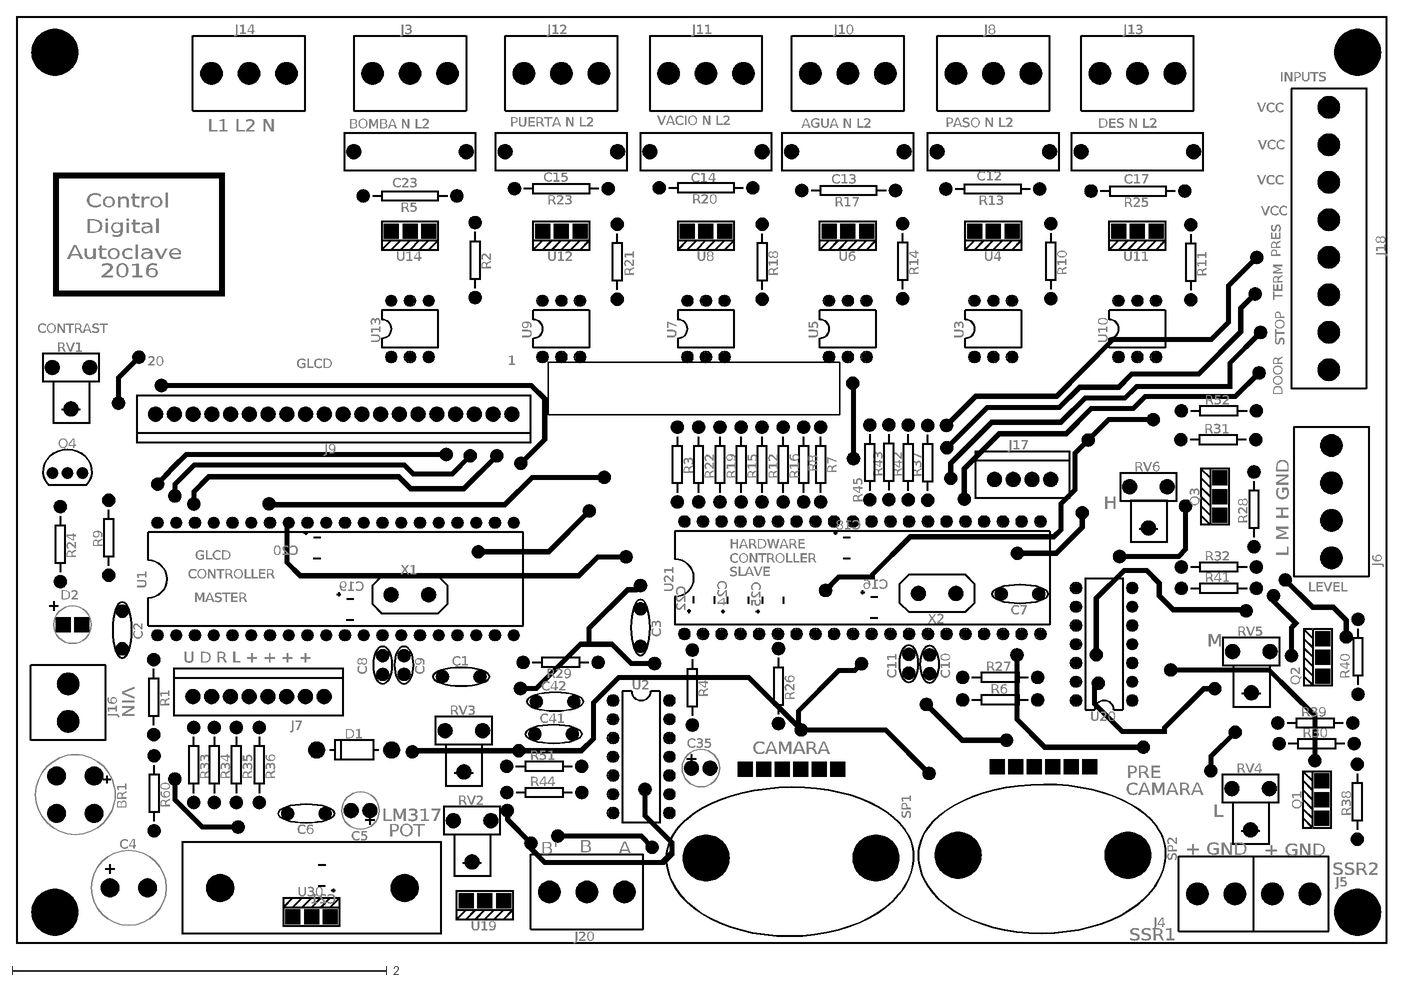
[picture p92: CAD file, 2021-07-14]
Autoclave Horizontal/Con Precamara/2016/Autoclave 110L/Autoclave Santa Marta/Schematic/AutoclaveCard.DXF
U1
U21
J16
BR1
C4
R60
U30
C5
C6
D1
C1
R1
X1
C8
C9
R9
Q4
J9
RV1
J7
R33
R34
R35
R36
J20
R51
U2
C41
C42
R29
RV3
SP1
SP2
R7
R8
Q1
R30
R38
R39
RV4
U20
Q2
R40
R41
R32
RV5
Q3
R28
R31
R52
RV6
J18
J4
J5
R6
R27
U19
RV2
R44
C35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
