judapies/Autoclave/Autoclave Horizontal/Con Precamara/2018/Autoclave 110L-V3.1 TIM #004587910/Schematic/USB Com/USB_I2C.DXF

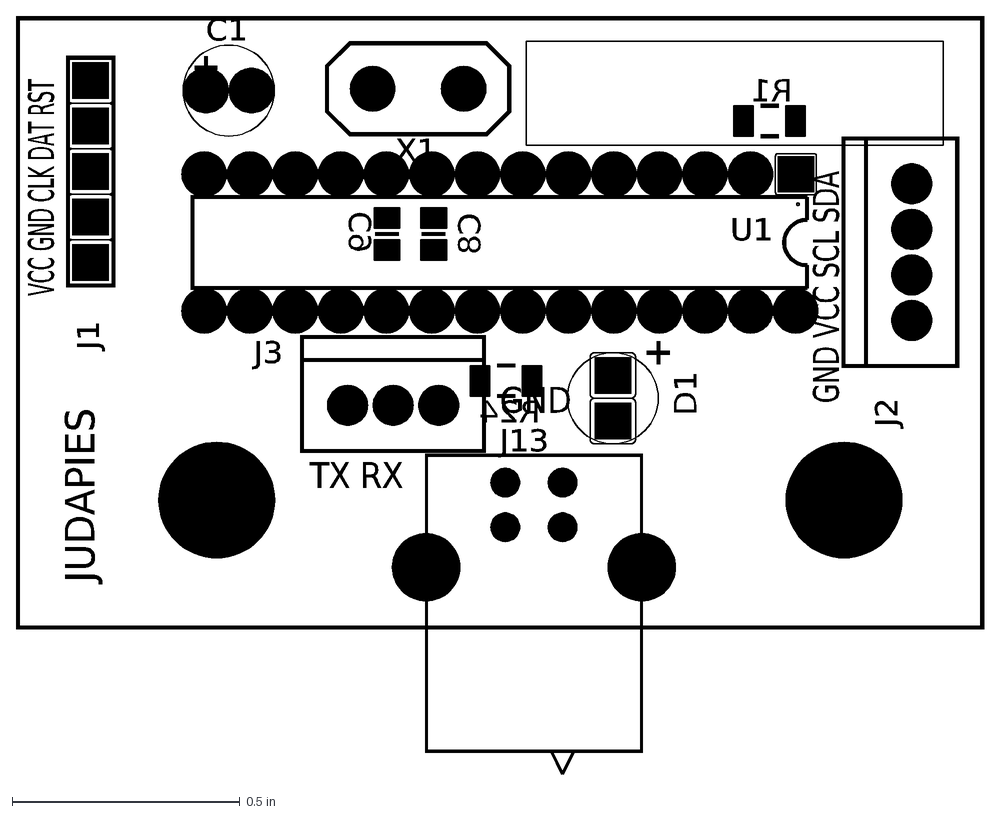
[picture p94: CAD file, 2021-07-14]
Autoclave Horizontal/Con Precamara/2018/Autoclave 110L-V3.1 TIM #004587910/Schematic/USB Com/USB_I2C.DXF
J13
U1
C1
X1
C8
C9
D1
R1
R24
GND VCC SCL SDA
JUDAPIES
J2
J1
J3
VCC GND CLK DAT RST
TX RX
GND
