judapies/Autoclave/Autoclave Horizontal/Con Precamara/2018/Autoclave 110L-V3.1 TIM #004587910/Schematic/User Library-BATTERY HOLDER CR2032.IGS

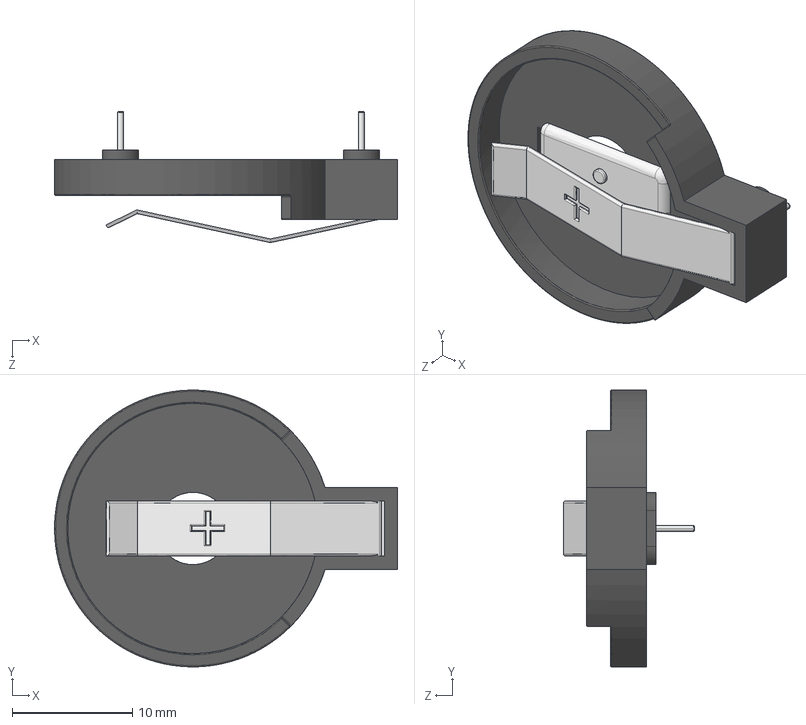
[picture p95: CAD file, 2021-07-14]
Autoclave Horizontal/Con Precamara/2018/Autoclave 110L-V3.1 TIM #004587910/Schematic/User Library-BATTERY HOLDER CR2032.IGS
28.5 x 23.0 x 10.9 mm
