judapies/Autoclave/Autoclave Horizontal/Con Precamara/2018/Autoclave 85L con vacio  #004587822/Schematic/Control GLCD/AutoclaveCard.DXF

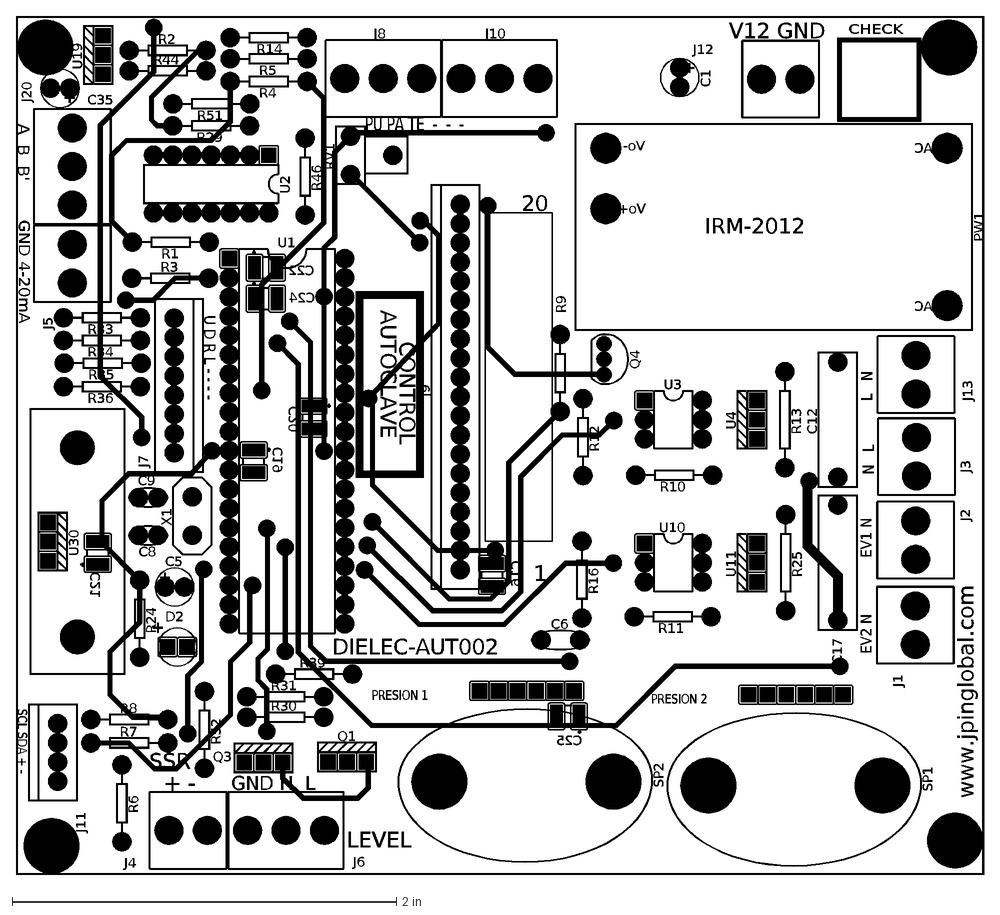
[picture p96: CAD file, 2021-07-14]
Autoclave Horizontal/Con Precamara/2018/Autoclave 85L con vacio #004587822/Schematic/Control GLCD/AutoclaveCard.DXF
U30
U1
AC
Vo+
Vo-
PW1
R1
SP1
SP2
U2
X1
C8
C9
U3
U4
U10
U11
R10
R11
R12
R16
J1
J2
J3
J7
R33
R34
R35
R36
D2
R24
R29
R51
R46
J20
J5
J8
J9
Q3
Q1
J10
J4
U19
R44
R2
RV1
R3
C19
C20
C21
C12
R4
R5
R14
R25
C17
R13
J11
R7
R8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
