judapies/Autoclave/Autoclave Horizontal/Con Precamara/2018/Autoclave 85L con vacio  #004587822/Schematic/Hardware Com/HardwareI2C.DXF

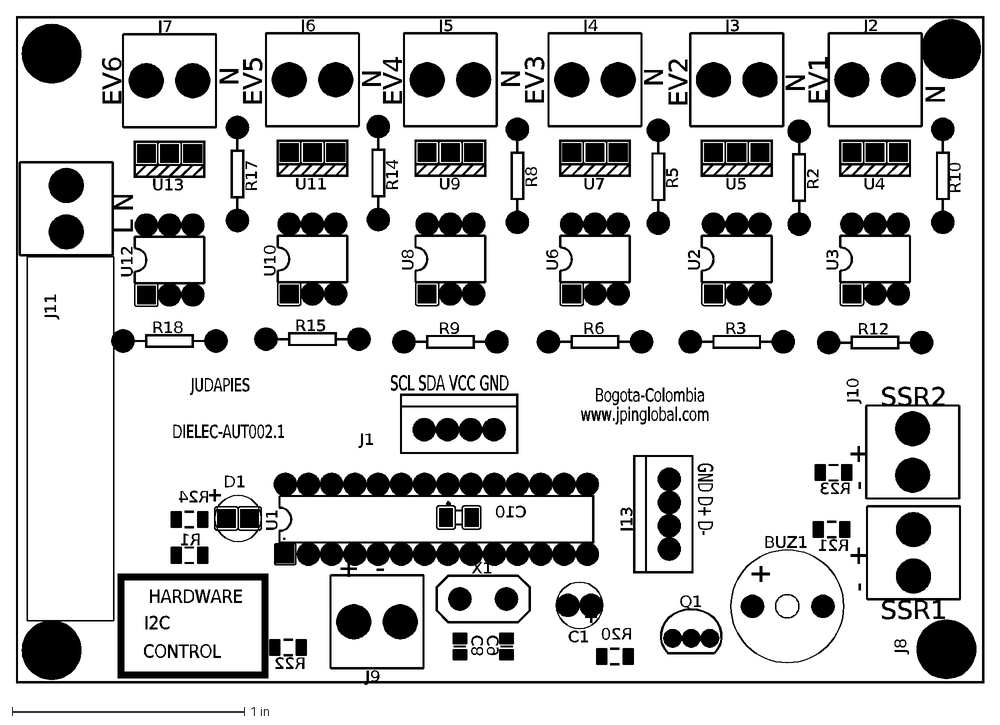
[picture p97: CAD file, 2021-07-14]
Autoclave Horizontal/Con Precamara/2018/Autoclave 85L con vacio #004587822/Schematic/Hardware Com/HardwareI2C.DXF
U1
R1
C1
X1
C8
C9
J1
J13
R12
U3
R10
U4
J2
U2
R3
R2
U5
J3
U6
U7
R6
R5
U8
R9
J4
R8
U9
J5
R15
R14
U10
U11
J6
U12
R18
R17
U13
J7
J11
R20
Q1
+
BUZ1
J8
J9
J10
R21
R22
R23
C10
R24
D1
EV1
EV2
EV3
EV4
EV5
EV6
N
L N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
