judapies/Autoclave/Autoclave Horizontal/Con Precamara/2019/Autoclave 120L Universidad Militar #004588099 OP201998/Schematic/CH376S/CH376S_I2C.DXF

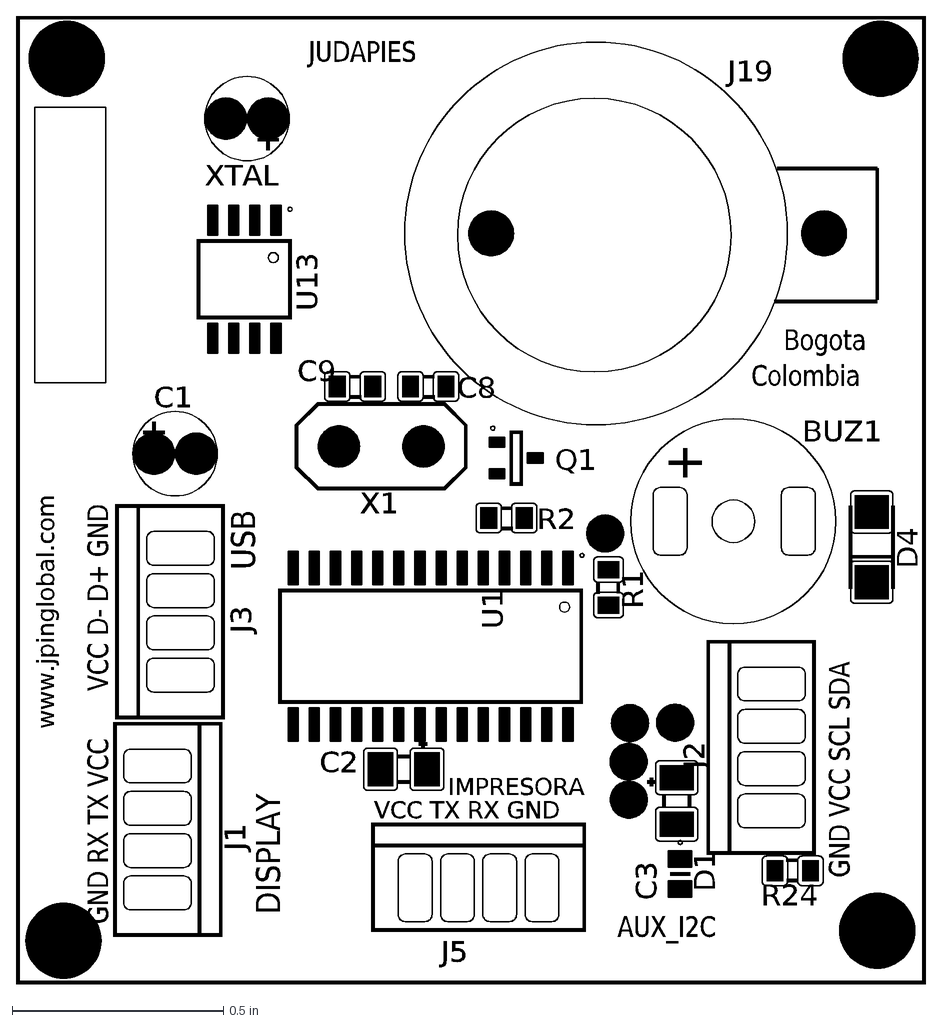
[picture p98: CAD file, 2021-07-14]
Autoclave Horizontal/Con Precamara/2019/Autoclave 120L Universidad Militar #004588099 OP201998/Schematic/CH376S/CH376S_I2C.DXF
U1
Q1
R1
R2
R24
D1
J2
C9
X1
C8
+
BUZ1
C3
C2
VCC TX RX GND
GND VCC SCL SDA
www.jpinglobal.com
Bogota
Colombia
JUDAPIES
AUX_I2C
C1
D4
J1
J3
J5
J19
U13
XTAL
DISPLAY
GND RX TX VCC
VCC D- D+ GND
USB
IMPRESORA
