judapies/Autoclave/Autoclave Horizontal/Con Precamara/2019/Autoclave 120L Universidad Militar #004588099 OP201998/Schematic/Nextion Control/NextionControlV3.DXF

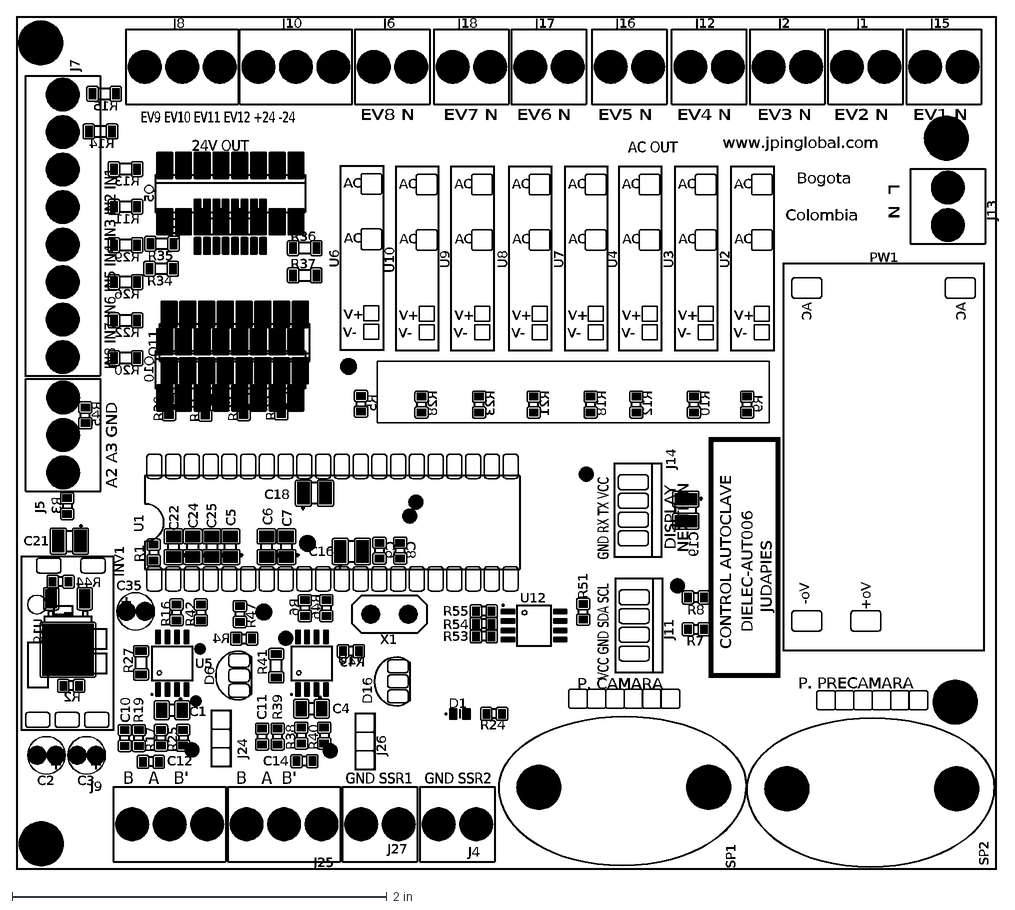
[picture p99: CAD file, 2021-07-14]
Autoclave Horizontal/Con Precamara/2019/Autoclave 120L Universidad Militar #004588099 OP201998/Schematic/Nextion Control/NextionControlV3.DXF
U1
U5
U17
R17
R25
R19
C10
C12
R27
C1
J9
J24
R16
R38
R39
R40
C4
C14
C11
J25
J26
R41
R42
J5
SP1
SP2
AC
Vo+
Vo-
PW1
D6
D16
R4
R43
INV1
R1
C22
C24
C25
C5
C6
C7
R6
R46
C16
C18
R9
V+
V-
U2
U3
U4
U6
U7
U8
U9
U10
R10
R12
R5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
