judapies/Autoclave/Autoclave Horizontal/Con Precamara/2019/Autoclave 120L Universidad Militar #004588099 OP201998/Schematic/User Library-MPX 5700GP.IGS

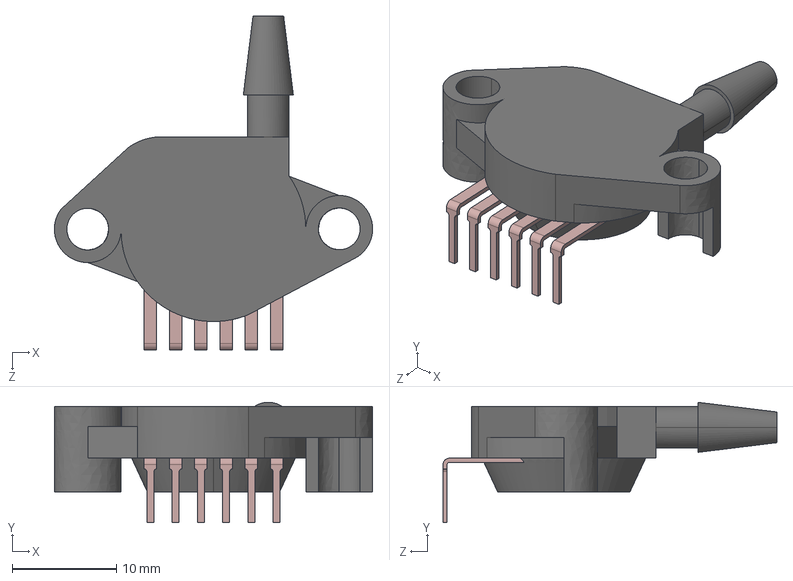
[picture p100: CAD file, 2021-07-14]
Autoclave Horizontal/Con Precamara/2019/Autoclave 120L Universidad Militar #004588099 OP201998/Schematic/User Library-MPX 5700GP.IGS
30.5 x 11.5 x 32.0 mm
