judapies/Autoclave/Autoclave Horizontal/Con Precamara/2019/Autoclave 120L Universidad Militar #004588099 OP201998/SchematicNivel/irfz44.DXF

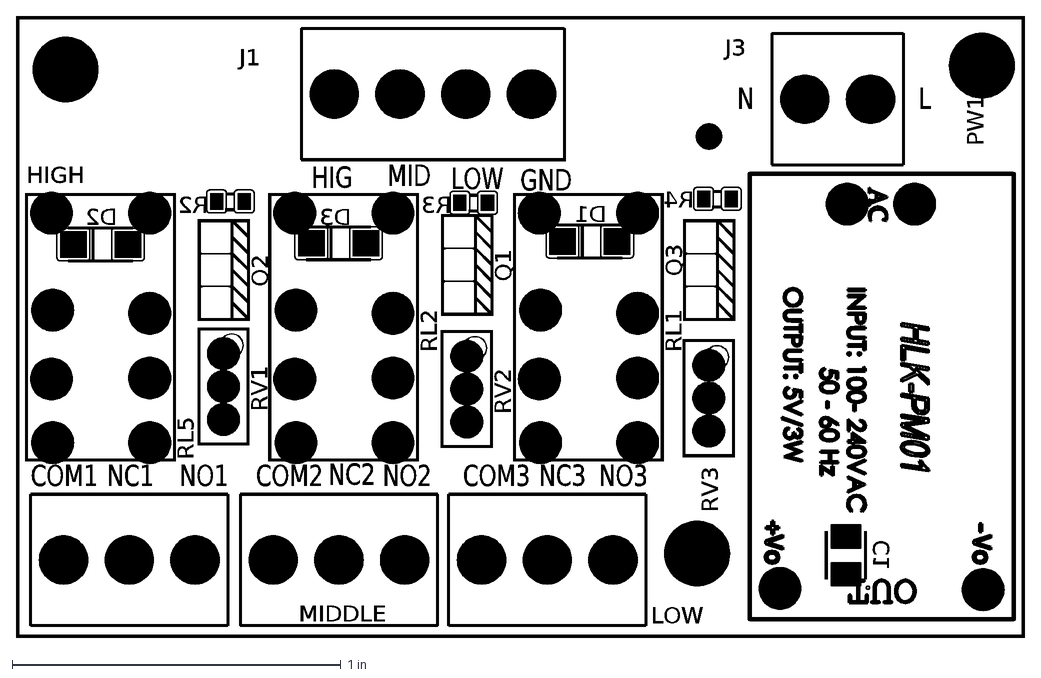
[picture p101: CAD file, 2021-07-14]
Autoclave Horizontal/Con Precamara/2019/Autoclave 120L Universidad Militar #004588099 OP201998/SchematicNivel/irfz44.DXF
J1
LOW
J3
HIGH
MIDDLE
Q2
RL1
R2
RV1
PW1
C1
RL2
Q1
D3
R3
RV2
RL5
RV3
D2
Q3
R4
L
N
GND
MID
HIG
NO3
NC3
COM3
NO2
NC2
COM2
NO1
NC1
COM1
D1
