judapies/Autoclave/Autoclave Horizontal/Con Precamara/2019/Autoclave 250L Doble Puerta UCC#004588085/Schematic/Nextion Control/NextionControlV4.DXF

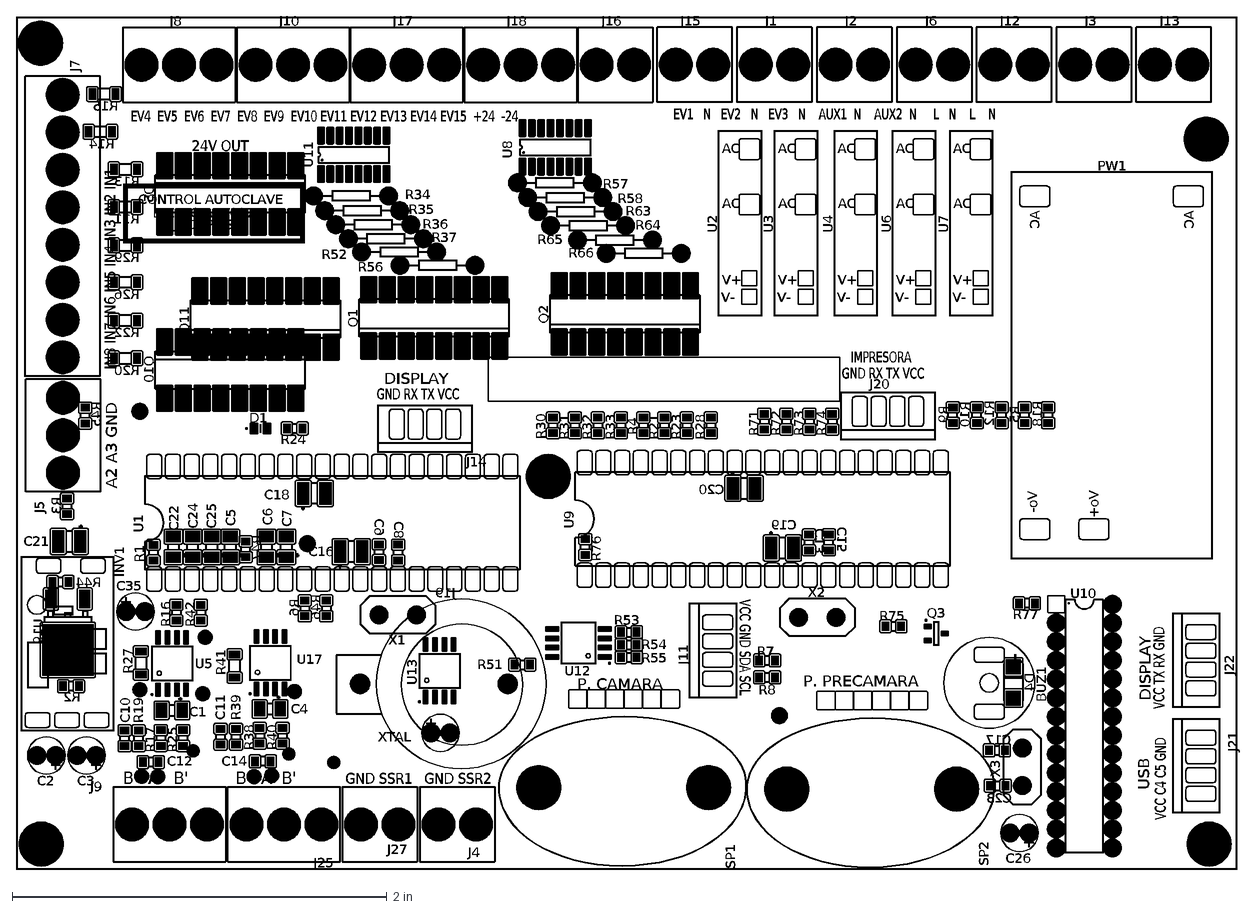
[picture p102: CAD file, 2021-07-14]
Autoclave Horizontal/Con Precamara/2019/Autoclave 250L Doble Puerta UCC#004588085/Schematic/Nextion Control/NextionControlV4.DXF
U1
U5
U17
R17
R25
R19
C10
C12
R27
C1
J9
R16
R38
R39
R40
C4
C14
C11
J25
R41
R42
J5
SP1
SP2
AC
Vo+
Vo-
PW1
INV1
R1
C22
C24
C25
C5
C6
C7
R6
R46
C16
C18
J14
J7
J4
J27
D1
J11
X1
C9
C8
U12
R53
R54
R55
C2
C3
R24
R7
R8
Q10
Q5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
