judapies/Autoclave/Autoclave Horizontal/Con Precamara/2019/Autoclave 680L-V3.1 VM #004587960/Schematic/CH376S/CH376S_I2C.DXF

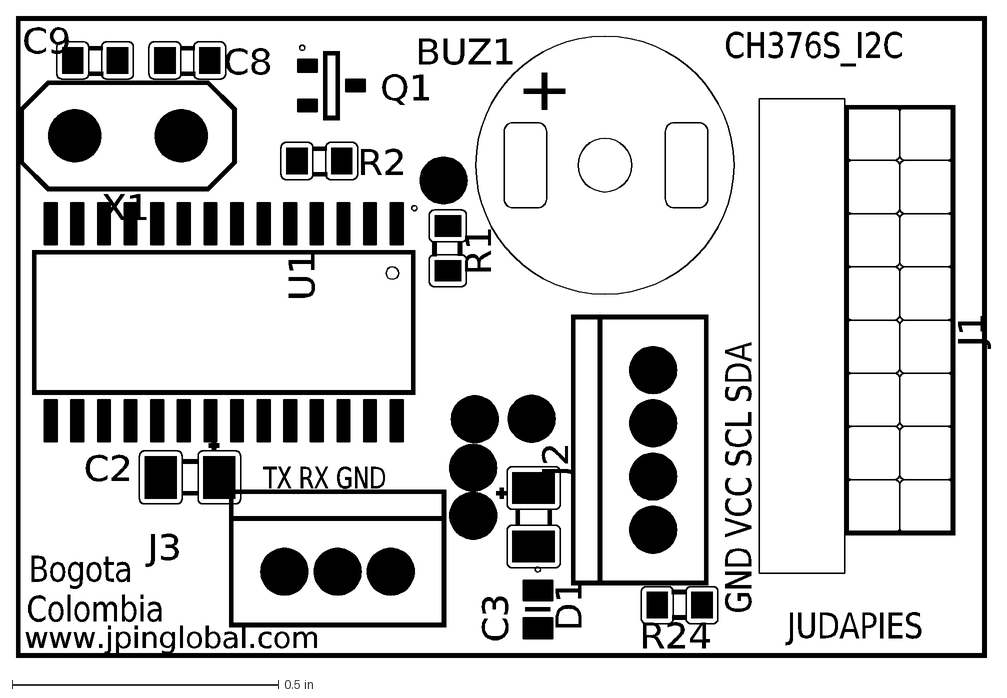
[picture p103: CAD file, 2021-07-14]
Autoclave Horizontal/Con Precamara/2019/Autoclave 680L-V3.1 VM #004587960/Schematic/CH376S/CH376S_I2C.DXF
U1
J3
Q1
R1
R2
R24
D1
J2
C9
X1
C8
+
BUZ1
C3
C2
J1
TX RX GND
GND VCC SCL SDA
www.jpinglobal.com
Bogota
Colombia
JUDAPIES
CH376S_I2C
