judapies/Autoclave/Autoclave Horizontal/Con Precamara/2019/Autoclave 680L-V3.1 VM #004587960/Schematic/NextionControl/AutoclaveV5.0.DXF

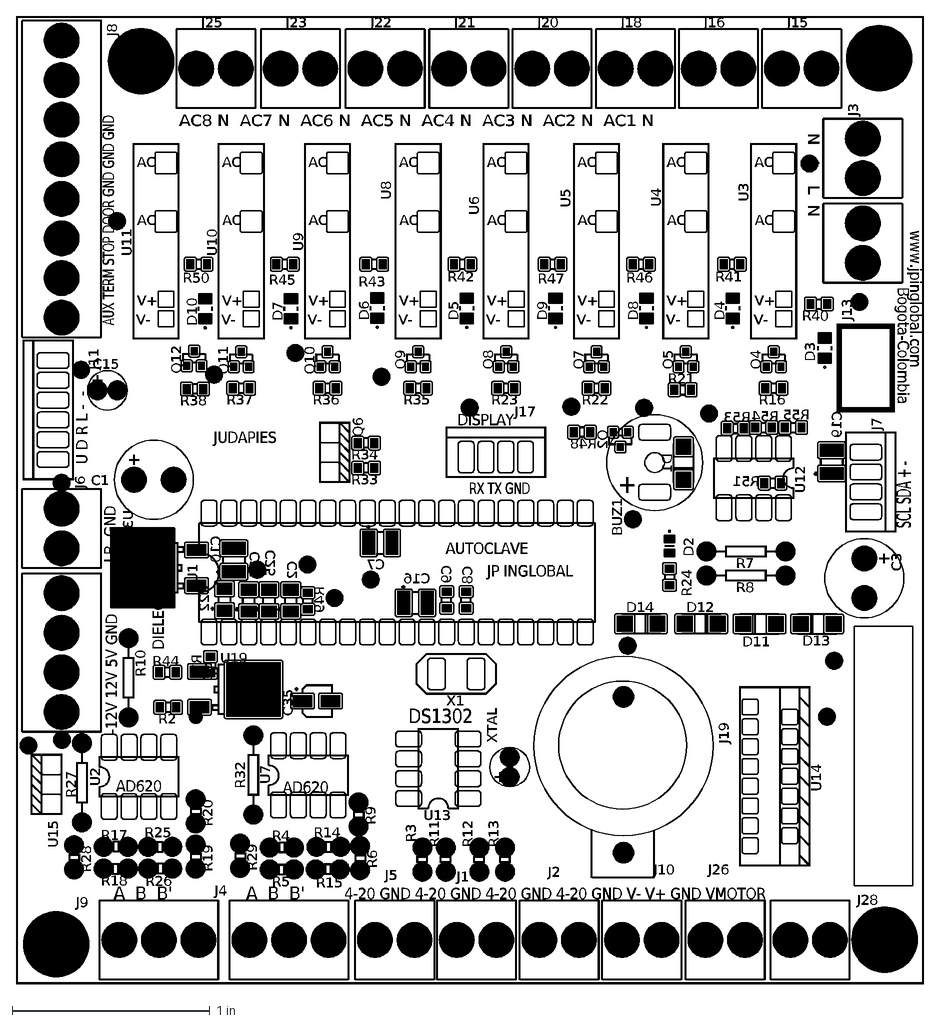
[picture p104: CAD file, 2021-07-14]
Autoclave Horizontal/Con Precamara/2019/Autoclave 680L-V3.1 VM #004587960/Schematic/NextionControl/AutoclaveV5.0.DXF
U13
XTAL
J19
J7
R7
R8
SCL SDA + -
DS1302
R16
Q4
AC
V+
V-
U3
R40
D3
J15
R21
Q5
U4
R41
D4
J16
R22
Q7
U5
R46
D8
J18
U1
R23
Q8
U6
R47
D9
J20
J21
J22
J23
J25
R35
Q9
U8
D5
R42
R36
R37
R38
Q10
Q11
Q12
U9
U10
U11
D6
D7
D10
R43
R45
R50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
