judapies/Autoclave/Autoclave Horizontal/Con Precamara/2020/Autoclave 110L Sucroal  OP2020325 #004588426/Schematic/Nextion Control/NextionControl2.DXF

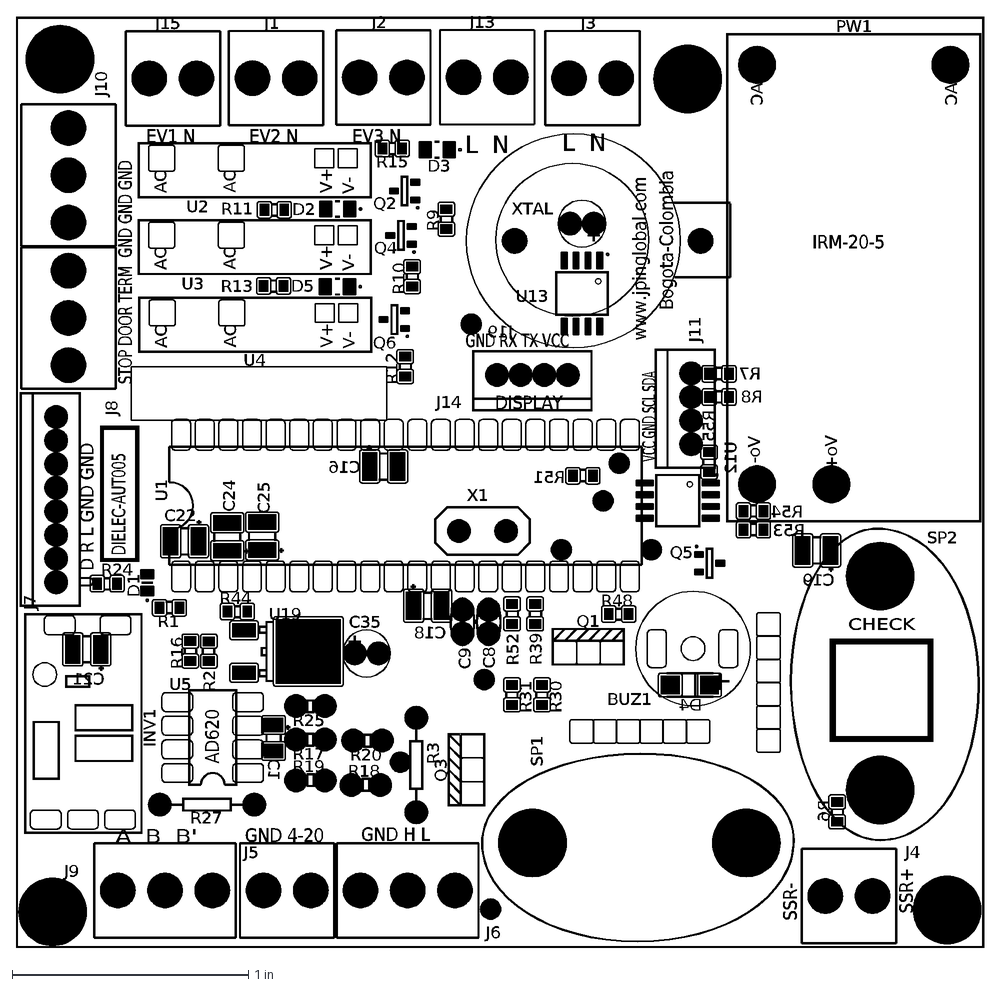
[picture p105: CAD file, 2021-07-14]
Autoclave Horizontal/Con Precamara/2020/Autoclave 110L Sucroal OP2020325 #004588426/Schematic/Nextion Control/NextionControl2.DXF
www.jpinglobal.com
CHECK
AC
Vo+
Vo-
PW1
U1
J9
R17
R25
R19
U5
R27
R16
R20
R18
INV1
J5
R3
SP1
SP2
U13
J19
XTAL
R48
Q5
+
BUZ1
D4
R9
Q2
D3
R15
V+
V-
U2
R10
D2
Q4
R11
U3
R12
Q6
U4
D1
R13
D5
J7
J8
X1
C8
C9
J1
J2
J15
R30
R52
R39
Q1
R31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
