judapies/Autoclave/Autoclave Horizontal/Con Precamara/2021/Autoclave 250L Avantika  OP2020414 #004588570/Schematic/MotorDriver/Puente_H.DXF

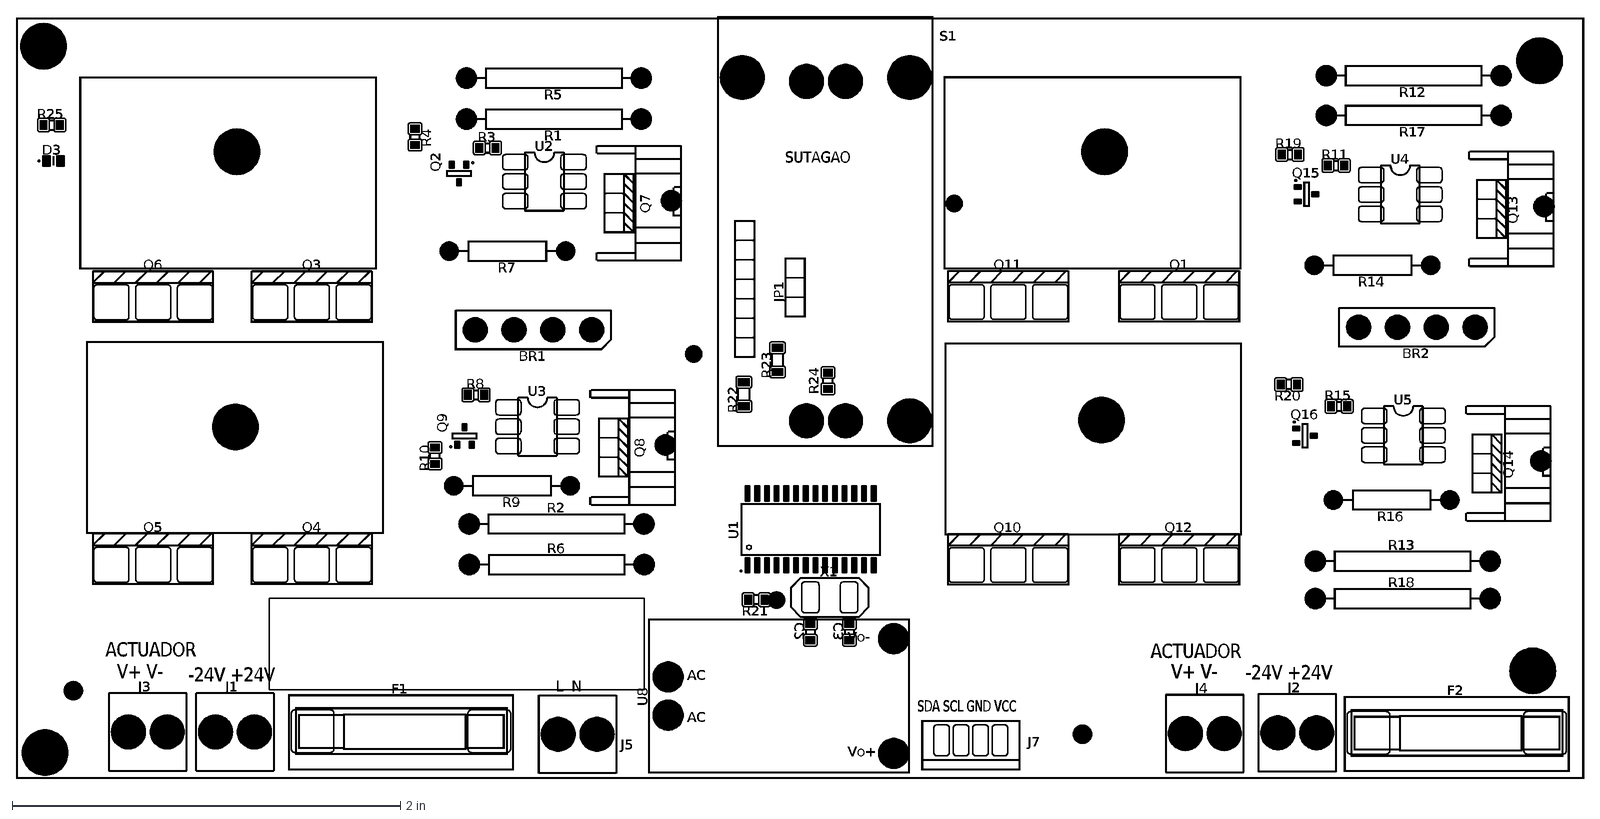
[picture p107: CAD file, 2021-07-14]
Autoclave Horizontal/Con Precamara/2021/Autoclave 250L Avantika OP2020414 #004588570/Schematic/MotorDriver/Puente_H.DXF
ACTUADOR
Q5
Q6
Q4
Q3
Q7
Q8
Q9
Q2
U2
U3
R1
R5
R2
R6
R7
R9
R10
U1
R4
BR1
J1
J2
F1
F2
J3
Q10
Q12
Q1
Q11
Q13
Q14
J4
U4
U5
R12
R13
R14
R16
R17
R18
BR2
Q15
Q16
R19
R20
S1
R21
AC
Vo+
Vo-
U8
X1
J7
R3
R8
R11
R15
C3
C2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
