judapies/Autoclave/Autoclave Horizontal/Con Precamara/2021/Autoclave 250L Avantika  OP2020414 #004588570/Schematic/Nextion Control SM/NextionControlV3.DXF

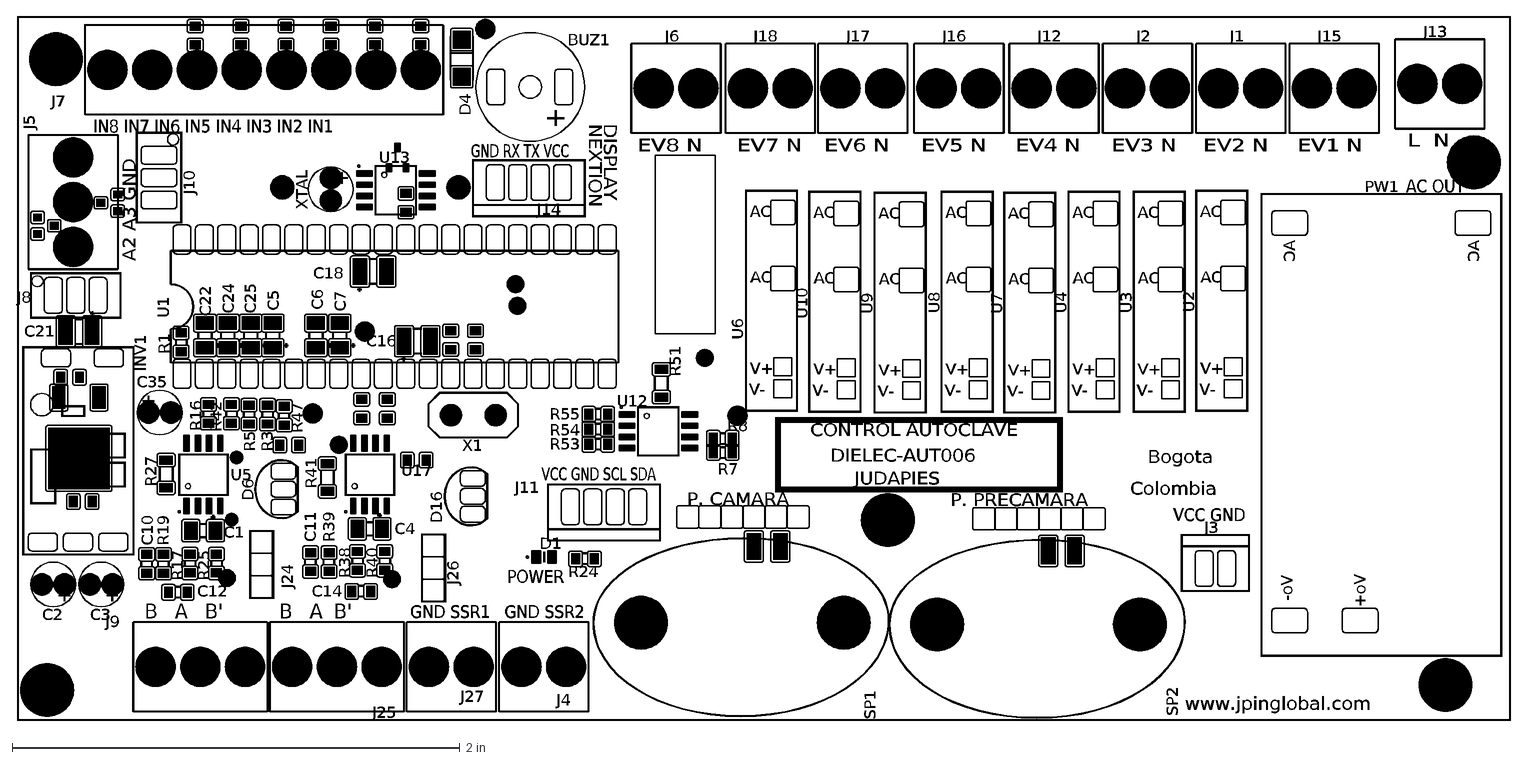
[picture p108: CAD file, 2021-07-14]
Autoclave Horizontal/Con Precamara/2021/Autoclave 250L Avantika OP2020414 #004588570/Schematic/Nextion Control SM/NextionControlV3.DXF
U1
U5
U17
R17
R25
R19
C10
C12
R27
C1
J9
J24
R16
R38
R39
R40
C4
C14
C11
J25
J26
R41
R42
J5
SP1
SP2
AC
Vo+
Vo-
PW1
D6
D16
INV1
R1
C22
C24
C25
C5
C6
C7
C16
C18
V+
V-
U2
U3
U4
U6
U7
U8
U9
U10
J14
J7
J15
J1
J2
J6
J12
J16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
