judapies/Autoclave/Autoclave Horizontal/Con Precamara/2021/Autoclave 62L Dempharma SAS OP2021108 #004588634/Modelo/PCB/NivelBoard.STEP

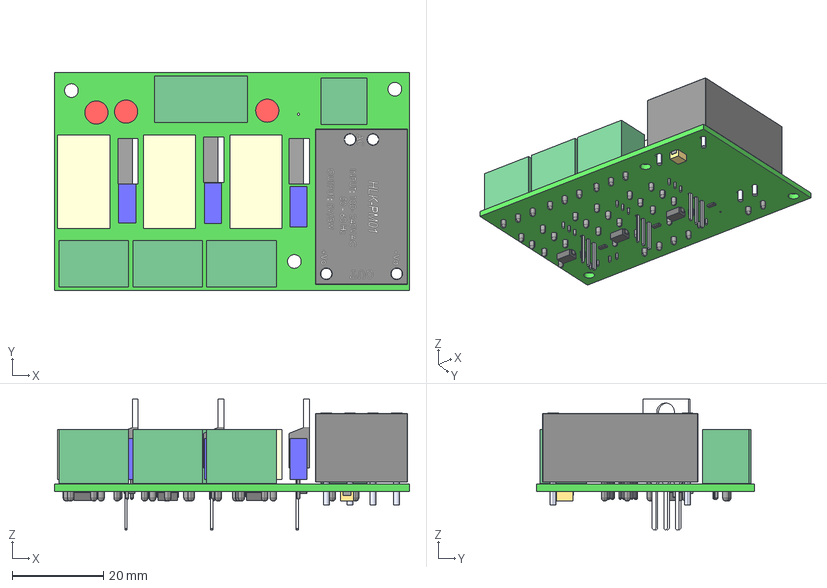
[picture p109: CAD file, 2021-07-14]
Autoclave Horizontal/Con Precamara/2021/Autoclave 62L Dempharma SAS OP2021108 #004588634/Modelo/PCB/NivelBoard.STEP
77.7 x 47.8 x 28.6 mm
Layer_1
Pin_1 x 21
Pin_2 x 21
Pin_3 x 10
Pin_4 x 4
Pin_5 x 3
Pin_6 x 3
Pin_7 x 3
Pin_8 x 3
