judapies/Autoclave/(list of files, cad)

Other CAD files:
Autoclave Horizontal/Con Precamara/2021/Autoclave 110L Biocacol OP2021110 #004588639/Modelo/Planos/EnsambleTuberiaPaso.dwg
Autoclave Horizontal/Con Precamara/2021/Autoclave 160L Electromedica Equipos Medicos SAS OP2021149 #0045886XX/Modelo/Planos/EnsambleConexionesSalidas.dwg
Autoclave Horizontal/Con Precamara/2021/Autoclave 62L Dempharma SAS OP2021108 #004588634/Modelo/Planos/ENSAMBLE GENERAL ACH-62L-2021-P JP2021-108.dwg
Autoclave Horizontal/Sin Precamara/2020/Autoclave 40L con Vacio Insulab #004588369 OP2020292/Ensamble Caja Control/ENSAMBLE GENERAL ACH-40L-2020-V.dwg
Autoclave Horizontal/Sin Precamara/2020/Autoclave 40L con Vacio Insulab #004588369 OP2020292/Ensamble General/ENSAMBLE GENERAL ACH-40L-2020-V.dwg
Autoclave Horizontal/Con Precamara/2021/Autoclave 110L Biocacol OP2021110 #004588639/Modelo/Planos/EnsambleAluminio-Estructura.dwg
Autoclave Horizontal/Con Precamara/2021/Autoclave 160L Electromedica Equipos Medicos SAS OP2021149 #0045886XX/Modelo/Planos/EnsambleTuberiaPaso.dwg
Autoclave Horizontal/Sin Precamara/2020/Autoclave 23L con Vacio Health Import #004588445-46-47-48 OP2020363-364-365-366/Ensamble Caja Control/EnsambleCajaControl2.dwg
Autoclave Horizontal/Con Precamara/2021/Autoclave 110L Biocacol OP2021110 #004588639/Modelo/Planos/EnsambleConexionesSalidas.dwg
Autoclave Horizontal/Con Precamara/2021/Autoclave 160L Electromedica Equipos Medicos SAS OP2021149 #0045886XX/Modelo/Planos/EnsambleTuberiaVacio-Desfogue-Condensados.dwg
Autoclave Horizontal/Sin Precamara/2021/Autoclave 55L Rodam #004588613 OP202183/Plano Hidraulico/ENSAMBLE RESERVORIO ACH-55L-2021-P-DP.dwg
Autoclave Horizontal/Con Precamara/2021/Autoclave 110L Biocacol OP2021110 #004588639/Modelo/Planos/EnsambleTuberiaCalderin.dwg
Autoclave Horizontal/Con Precamara/2021/Autoclave 160L Electromedica Equipos Medicos SAS OP2021149 #0045886XX/Modelo/Planos/EnsambleSuministroVapor.dwg
Autoclave Horizontal/Con Precamara/2021/Autoclave 110L Biocacol OP2021110 #004588639/Modelo/Planos/EnsambleTuberiaVacio-Desfogue-Condensados.dwg
Autoclave Horizontal/Con Precamara/2021/Autoclave 160L Electromedica Equipos Medicos SAS OP2021149 #0045886XX/Modelo/Planos/EnsambleTuberiaCalderin.dwg
Autoclave Horizontal/Con Precamara/2021/Autoclave 110L Biocacol OP2021110 #004588639/Modelo/Planos/EnsambleTuberiaEntradaAire.dwg
Autoclave Horizontal/Con Precamara/2021/Autoclave 160L Electromedica Equipos Medicos SAS OP2021149 #0045886XX/Modelo/Planos/EnsambleTuberiaEntradaAire.dwg
Autoclave Horizontal/Con Precamara/2021/Autoclave 110L Biocacol OP2021110 #004588639/Modelo/Planos/EnsambleSuministroVapor.dwg
Autoclave Horizontal/Con Precamara/2021/Autoclave 160L Electromedica Equipos Medicos SAS OP2021149 #0045886XX/Modelo/Planos/EnsambleAluminio-Estructura.dwg
Autoclave Horizontal/Con Precamara/2016/Autoclave 110L/Autoclave ArtiLab/Mto- 03-02-2021/Plano Electrico Autoclave Reservorio/ConexionesElectricasYElectronicas.dwg
Autoclave Horizontal/Con Precamara/2016/Autoclave 110L/Autoclave ArtiLab/Mto- 03-02-2021/Plano Hidraulico/Conexiones110L/Tuberia110L.dwg
Autoclave Horizontal/Con Precamara/2016/Autoclave 110L/Autoclave ArtiLab/Mto- 03-02-2021/Plano Hidraulico/Conexiones85L_Reservorio/Tuberia110L.dwg
Autoclave Horizontal/Con Precamara/2016/Autoclave 110L/Autoclave ArtiLab/Mto- 03-02-2021/Plano Hidraulico/Plano.dwg
Autoclave Horizontal/Con Precamara/2016/Autoclave 110L/Autoclave ArtiLab/Plano Electrico Autoclave Horizontal/ConexionesCajaElectrica.dwg
Autoclave Horizontal/Con Precamara/2016/Autoclave 110L/Autoclave ArtiLab/Plano Neumatico/ConexionesNeumaticas110L/Tuberia110L.dwg
Autoclave Horizontal/Con Precamara/2016/Autoclave 110L/Autoclave ArtiLab/Plano Neumatico/Plano.dwg
Autoclave Horizontal/Con Precamara/2016/Autoclave 110L/Autoclave ArtiLab/Schematic/Autoclave_27L.DXF.dwg
Autoclave Horizontal/Con Precamara/2016/Autoclave 110L/Autoclave Santa Marta/Plano Electrico Autoclave Horizontal/ConexionesElectricasYElectronicas.dwg
Autoclave Horizontal/Con Precamara/2016/Autoclave 110L/Autoclave Santa Marta/Plano Neumatico/ConexionesNeumaticas110L/Tuberia110L.dwg
Autoclave Horizontal/Con Precamara/2016/Autoclave 110L/Autoclave Santa Marta/Plano Neumatico/Plano.dwg
Autoclave Horizontal/Con Precamara/2016/Autoclave 120L/Autoclave TecniLab/Plano Electrico Autoclave Horizontal/ConexionesCajaElectrica.dwg
Autoclave Horizontal/Con Precamara/2016/Autoclave 120L/Autoclave TecniLab/Plano Neumatico/ConexionesNeumaticas120L/Tuberia110L.dwg
Autoclave Horizontal/Con Precamara/2016/Autoclave 120L/Autoclave TecniLab/Plano Neumatico/Plano.dwg
Autoclave Horizontal/Con Precamara/2017/Autoclave 110L/Autoclave Avantika #004587601/Plano Electrico Autoclave Horizontal/ConexionesElectricasYElectronicas.dwg
Autoclave Horizontal/Con Precamara/2017/Autoclave 110L/Autoclave Avantika #004587601/Plano Neumatico/ConexionesNeumaticas120L/Tuberia110L.dwg
Autoclave Horizontal/Con Precamara/2017/Autoclave 110L/Autoclave Avantika #004587601/Plano Neumatico/Plano.dwg
Autoclave Horizontal/Con Precamara/2018/Autoclave 110L-V3.1 TIM #004587910/Conexiones electricas Autoclave 110L/Conexiones electricas y electronicas A110L.dwg
Autoclave Horizontal/Con Precamara/2018/Autoclave 110L-V3.1 TIM #004587910/Plano Hidraulico/Conexiones85LH/Tuberia110L.dwg
Autoclave Horizontal/Con Precamara/2018/Autoclave 110L-V3.1 TIM #004587910/Plano Hidraulico/Plano.dwg
Autoclave Horizontal/Con Precamara/2018/Autoclave 110L-V3.1 TIM #004587911/Conexiones electricas Autoclave 110L/Conexiones electricas y electronicas A110L.dwg
Autoclave Horizontal/Con Precamara/2018/Autoclave 110L-V3.1 TIM #004587911/Plano Hidraulico/Conexiones85LH/Tuberia110L.dwg
Autoclave Horizontal/Con Precamara/2018/Autoclave 110L-V3.1 TIM #004587911/Plano Hidraulico/Plano.dwg
Autoclave Horizontal/Con Precamara/2018/Autoclave 120L-V3.1 Doble Puerta UIS #004587929/Plano Electrico Autoclave 120L Doble Puerta/Conexiones electricas y electronicas A110L.dwg
Autoclave Horizontal/Con Precamara/2018/Autoclave 120L-V3.1 Doble Puerta UIS #004587929/Plano Hidraulico/Conexiones85LH/Tuberia110L.dwg
Autoclave Horizontal/Con Precamara/2018/Autoclave 120L-V3.1 Doble Puerta UIS #004587929/Plano Hidraulico/Plano.dwg
Autoclave Horizontal/Con Precamara/2018/Autoclave 85L con vacio #004587822/Plano Electrico Autoclave Horizontal/ConexionesValvulas.dwg
Autoclave Horizontal/Con Precamara/2018/Autoclave 85L con vacio #004587822/Plano Hidraulico/Conexiones85LH/Tuberia110L.dwg
Autoclave Horizontal/Con Precamara/2018/Autoclave 85L con vacio #004587822/Plano Hidraulico/Plano.dwg
Autoclave Horizontal/Con Precamara/2019/Autoclave 120L Universidad Militar #004588099 OP201998/Plano Electrico Autoclave 120L/ConexionesBombaVacio.dwg
Autoclave Horizontal/Con Precamara/2019/Autoclave 120L Universidad Militar #004588099 OP201998/Plano Hidraulico/EsquemaHidraulico120L/Tuberia110L_recover.dwg
Autoclave Horizontal/Con Precamara/2019/Autoclave 160L-V3.1 Artilab #004587942/Conexiones electricas Autoclave 110L/Conexiones electricas y electronicas A110L.dwg
Autoclave Horizontal/Con Precamara/2019/Autoclave 160L-V3.1 Artilab #004587942/Plano Hidraulico/Conexiones85LH/Tuberia110L.dwg
Autoclave Horizontal/Con Precamara/2019/Autoclave 160L-V3.1 Artilab #004587942/Plano Hidraulico/Plano.dwg
Autoclave Horizontal/Con Precamara/2019/Autoclave 250L Doble Puerta UCC#004588085/Plano Electrico Autoclave 250L/ConexionesBombaVacio.dwg
Autoclave Horizontal/Con Precamara/2019/Autoclave 250L Doble Puerta UCC#004588085/Plano Hidraulico/EsquemaHidraulico250L/EsquemaNeumatico.dwg
Autoclave Horizontal/Con Precamara/2019/Autoclave 680L-V3.1 VM #004587960/Plano Electrico Autoclave 680L/ConexionesRelevo.dwg
Autoclave Horizontal/Con Precamara/2019/Autoclave 680L-V3.1 VM #004587960/Plano Hidraulico/Conexiones85LH/Tuberia110L.dwg
Autoclave Horizontal/Con Precamara/2019/Autoclave 680L-V3.1 VM #004587960/Plano Hidraulico/Plano.dwg
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
