judapies/Autoclave/Autoclave Horizontal/Sin Precamara/2020/Autoclave 40L Avantika #004588450 OP2020374/FJP – 44  CONTROL DE CALIDAD PRUEBAS E INSPECCION FINAL-62litros-004588422.docx

NOMBRE PRODUCTO REFERENCIA PROCESO | | Autoclave Horizontal 62L JPA62LH Control de Calidad | | | | MODELO ORDEN DE PEDIDO FECHA DE PEDIDO | 2020 2020353
No. | PROCESO | | INSPECCIÓN | REVISADO POR | FECHA | OBSERVACIONES | | PASA (S/N)
1 | Realizar el primer encendido del equipo | | Verificar y ajustar los parámetros (Ganancia, P, I, D, Tciclo, MediaMovil, R51, RPT100B, temperatura, tiempos de esterilización, nivel de desfogue) calibraciones desde Menu de Ajustes. | Ing. Diseño Eléctrico -Electrónico | 26/11/20 | Voltaje de trabajo:220 V Consumo corriente:14.58A temperatura de inicio:18.9 ºC Integral= 2 Derivativo=5 Proporcional=12 Ajuste+=0 Ajuste-=0 Atmosférica= 73 RPT100B= 0.5 Media = 80 Tciclo = 10 Ttrampa= 82
2 | Prueba de Hardware del equipo | | Verificar que cada uno de los componentes del equipo funcionen correctamente utilizando el “Test de componentes”. Ajustar termostato y válvula de seguridad | Ing. Diseño Eléctrico -Electrónico | 26/11/20 | Termostato:150ºC Válvula de seguridad= 37-38 psi aproximadamente Componentes ok
3 | Realizar el ciclo “Líquidos A” con equipo sin carga. | | Revisar que no existan fugas de vapor o agua en ninguna de las conexiones hidráulicas, neumáticas y por el sello de la puerta. Verificar que se realice el ciclo completo que los valores de temperatura y presión tenga correlación. | Ing. Diseño Eléctrico -Electrónico | 26/11/20 | Temperatura inicial = 72.5ºC Presión inicial = 0 Kpa Hora de inicio = 9:25 am Nivel de desfogue= 3 Set point Temperatura = 121º Tiempo de Esterilización = 15:00 min Tmax = 121.6 ºC Pmax = 136 kPa Hora desfogue = 9:58am Ciclo finalizado = 10:06am Temperatura final = 94.4ºC
4 | Realizar el ciclo de “Caucho” con equipo sin carga. | | Revisar que no existan fugas de vapor o agua en ninguna de las conexiones hidráulicas, neumáticas y por el sello de la puerta. Verificar que se realice el ciclo completo que los valores de temperatura y presión tenga correlación. | Ing. Diseño Eléctrico -Electrónico | 26/11/20 | Temperatura inicial = 82.4ºC Presión inicial = 0 Kpa Hora de inicio = 10:39 Set point Temperatura = 121º Tiempo de Esterilización = 15:00 min Tiempo secado = 3:00 min Tmax = 121.5 ºC Pmax = 144 kPa Hora desfogue = 11:05 am Ciclo finalizado = 11:14am Temperatura final = 92.2ºC
5 | Realizar el ciclo de “Instrumental” con equipo sin carga. | | Revisar que no existan fugas de vapor o agua en ninguna de las conexiones hidráulicas, neumáticas y por el sello de la puerta. Verificar que se realice el ciclo completo que los valores de temperatura y presión tenga correlación. Verificar Nivel de desfogue. | Ing. Diseño Eléctrico -Electrónico | | Temperatura inicial = 86.4ºC Presión inicial = 0 Kpa Hora de inicio = 11:26am Set point Temperatura = 121º Tiempo de Esterilización = 30:00 min Tiempo secado = 30:00 min Tmax = 121.7 ºC Pmax = 141 kPa Hora desfogue = 12:04 pm Ciclo finalizado = 12:40 Temperatura final = 74.4ºC
6 | Realizar el ciclo de “Líquidos B” con equipo sin carga. | | Revisar que no existan fugas de vapor o agua en ninguna de las conexiones hidráulicas, neumáticas y por el sello de la puerta. Verificar que se realice el ciclo completo que los valores de temperatura y presión tenga correlación. Verificar tiempos de esterilización y secado. | Ing. Diseño Eléctrico -Electrónico | | Temperatura inicial = 54.7ºC Presión inicial = 0 Kpa Hora de inicio = 13:33pm Set point Temperatura = 121º Tiempo de Esterilización = 30:00 min Tiempo secado = 00:00 min Tmax = 121.6 ºC Pmax = 133 kPa Hora desfogue = 14:21 pm Ciclo finalizado = 14:34 Temperatura final = 94.4ºC
7 | Realizar un ciclo “personalizado” con equipo sin carga y con temperatura 134°C, tiempo de esterilización 10 min, sin secado y con nivel de desfogue 3. | | Revisar que no existan fugas de vapor o agua en ninguna de las conexiones hidráulicas, neumáticas y por el sello de la puerta. Verificar que se realice el ciclo completo que los valores de temperatura y presión tenga correlación. | Ing. Diseño Eléctrico -Electrónico | | Temperatura inicial = 71.6ºC Presión inicial = 0 Kpa Hora de inicio = 15:59pm Set point Temperatura = 134º Tiempo de Esterilización = 5:00 min Tiempo secado = 00:00 min Tmax = 134.4 ºC Pmax = 234 kPa Hora desfogue = 16:21 pm Ciclo finalizado = 16:44 Temperatura final = 94.4ºC CON CARGA
8 | Realizar el ciclo “Líquidos A” con equipo con aprox. 4 litros de carga y ubicar control físico en el tanque de la autoclave. | | Revisar que el control físico ingresado en el autoclave indique que esterilizo. Revisar que no existan fugas de vapor o agua en ninguna de las conexiones hidráulicas, neumáticas y por el sello de la puerta. Verificar que se realice el ciclo completo que los valores de temperatura y presión tenga correlación. | Ing. Diseño Eléctrico -Electrónico | 27/11/20 | Temperatura inicial = 71.2ºC Presión inicial = 0Kpa Hora de inicio = 14:58pm Nivel de desfogue= 3 Set point Temperatura = 121º Tiempo de Esterilización = 30:00 min Tmax = 121.7 ºC Pmax = 137 kPa Hora desfogue =15:29pm Ciclo finalizado =15:46pm Temperatura final = 93.9ºC
9 | Realizar el ciclo “Líquidos B” con equipo sin carga y totalmente cerrado. | | Revisar que no existan fugas de vapor o agua en ninguna de las conexiones hidráulicas, neumáticas y por el sello de la puerta. Verificar que se realice el ciclo completo que los valores de temperatura y presión tenga correlación. | Ing. Diseño Eléctrico -Electrónico | 27/11/20 | Temperatura inicial =16.5 ºC Presión inicial = 0Kpa Hora de inicio = 7:32am Nivel de desfogue= 3 Set point Temperatura = 121º Tiempo de Esterilización = 30:00 min Tmax = 121.6ºC Pmax = 133 kPa Hora desfogue = 8:12am Ciclo finalizado = 8:23am Temperatura final = 89.9ºC
10 | Certificación del equipo de funcionamiento y desempeño por parte de Certificadora acreditada | | Certificar que el equipo cumple con la normatividad vigente. | Dirección Técnica | 27/11/20 | El equipo cumple

_________________________ _______________________

VoBo DIRECTOR TÉCNICO Fecha

NOTA: Se debe anexar a este formato, cada una de las gráficas obtenidas en las pruebas realizadas al equipo, junto con los datos en Excel de cada uno de los ciclos. Se recomienda un tiempo de muestreo de 10 segundos. SIN ESTA INFORMACIÓN ESTE FORMATO NO TENDRÁ VALIDEZ.

JP BIOINGENIERIA S.A.S CONTROL DE CALIDAD PRUEBAS E INSPECCIÓN FINAL FJP – 44 Versión 01 Efectivo a partir de: Febrero 18 de 2018 Documento origen: DJP-26
