judapies/Autoclave/Autoclave Horizontal/Sin Precamara/2021/Autoclave 85L Avantika #004588542 OP202109/FJP – 44  CONTROL DE CALIDAD PRUEBAS E INSPECCION FINAL-85litros-004588542.docx

NOMBRE PRODUCTO REFERENCIA PROCESO | | Autoclave Horizontal 55L JP55LV Control de Calidad | | | | MODELO ORDEN DE PEDIDO FECHA DE PEDIDO | 2020 2020318
No. | PROCESO | | INSPECCIÓN | REVISADO POR | FECHA | OBSERVACIONES | | PASA (S/N)
1 | Realizar el primer encendido del equipo | | Verificar y ajustar los parámetros (Ganancia, P, I, D, Tciclo, MediaMovil, R51, RPT100B, temperatura, tiempos de esterilización, nivel de desfogue) calibraciones desde Menu de Ajustes. | Ing. Diseño Eléctrico -Electrónico | 25/03/21 | Voltaje de trabajo:214 V Consumo corriente:23.04A temperatura de inicio:16.9 ºC Integral= 2 Derivativo=12 Proporcional=8 Ajuste+=0 Ajuste-=0 Atmosférica= 0 RPT100B= 0.5 Media = 80 Tciclo = 10 Ttrampa= 93 | | ok
2 | Prueba de Hardware del equipo | | Verificar que cada uno de los componentes del equipo funcionen correctamente utilizando el “Test de componentes”. Ajustar termostato y válvula de seguridad | Ing. Diseño Eléctrico -Electrónico | 25/03/21 | Termostato:160ºC Válvula de seguridad= 37-38 psi aproximadamente Componentes ok | | ok
3 | Realizar el ciclo “Líquidos A” con equipo sin carga. | | Revisar que no existan fugas de vapor o agua en ninguna de las conexiones hidráulicas, neumáticas y por el sello de la puerta. Verificar que se realice el ciclo completo que los valores de temperatura y presión tenga correlación. | Ing. Diseño Eléctrico -Electrónico | 25/03/21 | Temperatura inicial = 16.9 Hora de inicio =7:15 am Nivel de desfogue= 3 Set point Temperatura = 121º Tiempo de Esterilización = 15:00 min Tmax = 121.7 Tmin=121.5 Pmax = 137kpa Pmin=135kpa Ciclo finalizado = 8:00 Temperatura final = 89.9 | | ok
4 | Realizar el ciclo de “Caucho” con equipo sin carga. | | Revisar que no existan fugas de vapor o agua en ninguna de las conexiones hidráulicas, neumáticas y por el sello de la puerta. Verificar que se realice el ciclo completo que los valores de temperatura y presión tenga correlación. | Ing. Diseño Eléctrico -Electrónico | 25/03/21 | Ajuste+=3 Temperatura inicial = 79.7 Presión inicial = 0 Kpa Hora de inicio = 8:15 Set point Temperatura = 121º Tiempo de Esterilización = 15:00 min Tiempo secado = 3:00 min Tmax = 121.7 Tmin=121.5 Pmax = 144kpa Pmin=140kpa Ciclo finalizado = 8:52 Temperatura final = 89.9 | | ok
5 | Realizar el ciclo de “Instrumental” con equipo sin carga. | | Revisar que no existan fugas de vapor o agua en ninguna de las conexiones hidráulicas, neumáticas y por el sello de la puerta. Verificar que se realice el ciclo completo que los valores de temperatura y presión tenga correlación. Verificar Nivel de desfogue. | Ing. Diseño Eléctrico -Electrónico | 25/03/21 | Temperatura inicial = 81.4 Presión inicial = 0 Kpa Hora de inicio = 9:05 Set point Temperatura = 121º Tiempo de Esterilización = 30:00 min Tiempo secado = 30:00 min Tmax = 121.7 Tmin=121.5 Pmax = 138kpa Pmin=135 Ciclo finalizado = 10:18 Temperatura final = 84.7 | | ok
6 | Realizar el ciclo de “Líquidos B” con equipo sin carga. | | Revisar que no existan fugas de vapor o agua en ninguna de las conexiones hidráulicas, neumáticas y por el sello de la puerta. Verificar que se realice el ciclo completo que los valores de temperatura y presión tenga correlación. Verificar tiempos de esterilización y secado. | Ing. Diseño Eléctrico -Electrónico | 25/03/21 | Temperatura inicial = 77.5 Presión inicial = 0 Kpa Hora de inicio = 10:31 Set point Temperatura = 121º Tiempo de Esterilización = 30:00 min Tiempo secado = 00:00 min Tmax = 121.7 Tmin=121.5 Pmax = 138kpa Pmin=135kpa Ciclo finalizado = 11:23 Temperatura final = 89.9 | | ok
7 | Realizar un ciclo “personalizado” con equipo sin carga y con temperatura 128°C, tiempo de esterilización 5 min, sin secado y con nivel de desfogue 3. | | Revisar que no existan fugas de vapor o agua en ninguna de las conexiones hidráulicas, neumáticas y por el sello de la puerta. Verificar que se realice el ciclo completo que los valores de temperatura y presión tenga correlación. | Ing. Diseño Eléctrico -Electrónico | 25/03/21 | Temperatura inicial = 38.9 Hora de inicio = 1:46 Set point Temperatura = 128 Tiempo de Esterilización = 5:00 min Tiempo secado = 00:00 min Tmax = 128.5 Tmin=128.2 Pmax = 184 Pmin=180 Ciclo finalizado = 2:48 Temperatura final = 88.5 | | ok
8 | Realizar el ciclo “Líquidos A” con equipo con aprox. 4 litros de carga y ubicar control físico en el tanque de la autoclave. | | Revisar que el control físico ingresado en el autoclave indique que esterilizo. Revisar que no existan fugas de vapor o agua en ninguna de las conexiones hidráulicas, neumáticas y por el sello de la puerta. Verificar que se realice el ciclo completo que los valores de temperatura y presión tenga correlación. | Ing. Diseño Eléctrico -Electrónico | 25/03/21 | Temperatura inicial = 77.7 Hora de inicio = 3:02 Nivel de desfogue= 3 Set point Temperatura = 121º Tiempo de Esterilización = 30:00 min Tmax = 121.8 Tmin=121.5 Pmax = 137 Pmin=135 Ciclo finalizado =4:00 Temperatura final = 89.9 | | ok
9 | Realizar el ciclo “Líquidos B” con equipo sin carga y totalmente cerrado. | | Revisar que no existan fugas de vapor o agua en ninguna de las conexiones hidráulicas, neumáticas y por el sello de la puerta. Verificar que se realice el ciclo completo que los valores de temperatura y presión tenga correlación. | Ing. Diseño Eléctrico -Electrónico | 26/03/21 | Temperatura inicial =19.1 Hora de inicio = 7:50 Nivel de desfogue= 3 Set point Temperatura = 121º Tiempo de Esterilización = 30:00 min Tmax = 121.7 Tmin=121.5 Pmax = 134 Pmin=132 Ciclo finalizado = 8:23am Temperatura final = 89.9ºC | | ok
10 | Certificación del equipo de funcionamiento y desempeño por parte de Certificadora acreditada | | Certificar que el equipo cumple con la normatividad vigente. | Dirección Técnica | 26/03/21 | El equipo cumple | | ok

_________________________ _______________________

VoBo DIRECTOR TÉCNICO Fecha

NOTA: Se debe anexar a este formato, cada una de las gráficas obtenidas en las pruebas realizadas al equipo, junto con los datos en Excel de cada uno de los ciclos. Se recomienda un tiempo de muestreo de 10 segundos. SIN ESTA INFORMACIÓN ESTE FORMATO NO TENDRÁ VALIDEZ.

JP BIOINGENIERIA S.A.S CONTROL DE CALIDAD PRUEBAS E INSPECCIÓN FINAL FJP – 44 Versión 01 Efectivo a partir de: Febrero 18 de 2018 Documento origen: DJP-26
