judapies/Autoclave/Autoclave Horizontal/Sin Precamara/2021/Autoclave 85L Avantika #004588543 OP202110/FJP – 44  CONTROL DE CALIDAD PRUEBAS E INSPECCION FINAL-85litros-004588543.docx

NOMBRE PRODUCTO REFERENCIA PROCESO | | Autoclave Horizontal 55L JP55LV Control de Calidad | | | | MODELO ORDEN DE PEDIDO FECHA DE PEDIDO | 2020 2020318
No. | PROCESO | | INSPECCIÓN | REVISADO POR | FECHA | OBSERVACIONES | | PASA (S/N)
1 | Realizar el primer encendido del equipo | | Verificar y ajustar los parámetros (Ganancia, P, I, D, Tciclo, MediaMovil, R51, RPT100B, temperatura, tiempos de esterilización, nivel de desfogue) calibraciones desde Menu de Ajustes. | Ing. Diseño Eléctrico -Electrónico | 24/03/21 | Voltaje de trabajo:210 V Consumo corriente:24A temperatura de inicio:18.3 ºC Integral= 2 Derivativo=12 Proporcional=8 Ajuste+=0 Ajuste-=0 Atmosférica= 00 RPT100B= 0.5 Media = 80 Tciclo = 10 Ttrampa= 90 | | ok
2 | Prueba de Hardware del equipo | | Verificar que cada uno de los componentes del equipo funcionen correctamente utilizando el “Test de componentes”. Ajustar termostato y válvula de seguridad | Ing. Diseño Eléctrico -Electrónico | 24/03/21 | Termostato:160ºC Válvula de seguridad= 37-38 psi aproximadamente Componentes ok | | ok
3 | Realizar el ciclo “Líquidos A” con equipo sin carga. | | Revisar que no existan fugas de vapor o agua en ninguna de las conexiones hidráulicas, neumáticas y por el sello de la puerta. Verificar que se realice el ciclo completo que los valores de temperatura y presión tenga correlación. | Ing. Diseño Eléctrico -Electrónico | 24/03/21 | Temperatura inicial = 18.3ºC Presión inicial = 0 Kpa Hora de inicio = 1:33pm Nivel de desfogue= 2 Set point Temperatura = 121º Tiempo de Esterilización = 15:00 min Tmax = 121.7 Tmin=121.4 Pmax = 138kps Pmin=136kpa Ciclo finalizado = 2:22 Temperatura final = 89.8 | | ok
4 | Realizar el ciclo de “Caucho” con equipo sin carga. | | Revisar que no existan fugas de vapor o agua en ninguna de las conexiones hidráulicas, neumáticas y por el sello de la puerta. Verificar que se realice el ciclo completo que los valores de temperatura y presión tenga correlación. | Ing. Diseño Eléctrico -Electrónico | 24/03/21 | Ajuste+=3 Temperatura inicial = 73.9 Hora de inicio = 2:33 Set point Temperatura = 121º Tiempo de Esterilización = 15:00 min Tiempo secado = 3:00 min Tmax = 121.7 Tmin=121.5 Pmax = 144kpa Pmin=142kpa Ciclo finalizado = 3:00 Temperatura final = 74.5 | | ok
5 | Realizar el ciclo de “Instrumental” con equipo sin carga. | | Revisar que no existan fugas de vapor o agua en ninguna de las conexiones hidráulicas, neumáticas y por el sello de la puerta. Verificar que se realice el ciclo completo que los valores de temperatura y presión tenga correlación. Verificar Nivel de desfogue. | Ing. Diseño Eléctrico -Electrónico | 24/03/21 | TTrampa=93 Temperatura inicial = 78.9 Presión inicial = 0 Kpa Hora de inicio = 3:07 pm Set point Temperatura = 121º Tiempo de Esterilización = 30:00 min Tiempo secado = 30:00 min Tmax = 121.7 Tmin=121.5 Pmax = 136kpa Pmin=134kpa Ciclo finalizado = 4:20 Temperatura final = 74.4ºC | | ok
6 | Realizar el ciclo de “Líquidos B” con equipo sin carga. | | Revisar que no existan fugas de vapor o agua en ninguna de las conexiones hidráulicas, neumáticas y por el sello de la puerta. Verificar que se realice el ciclo completo que los valores de temperatura y presión tenga correlación. Verificar tiempos de esterilización y secado. | Ing. Diseño Eléctrico -Electrónico | 24/0321 | Temperatura inicial = 74.4 Hora de inicio = 4:26 Set point Temperatura = 121º Tiempo de Esterilización = 30:00 min Tiempo secado = 00:00 min Tmax = 121.7 Tmin=121.6 Pmax = 134kpa Pmin=133kpa Ciclo finalizado = 5:07 Temperatura final = 89.6 | | ok
7 | Realizar un ciclo “personalizado” con equipo sin carga y con temperatura 134°C, tiempo de esterilización 5 min, sin secado y con nivel de desfogue 3. | | Revisar que no existan fugas de vapor o agua en ninguna de las conexiones hidráulicas, neumáticas y por el sello de la puerta. Verificar que se realice el ciclo completo que los valores de temperatura y presión tenga correlación. | Ing. Diseño Eléctrico -Electrónico | 25/03/21 | Temperatura inicial = 15.9ºC Presión inicial = 0 Kpa Hora de inicio = 15:59pm Set point Temperatura = 128º Tiempo de Esterilización = 5:00 min Tiempo secado = 00:00 min Tmax = 128.4 Tmin=128.2 Pmax = 180 kpa Pmin=179 kpa Ciclo finalizado = 8:05 Temperatura final = 89.9 | | ok

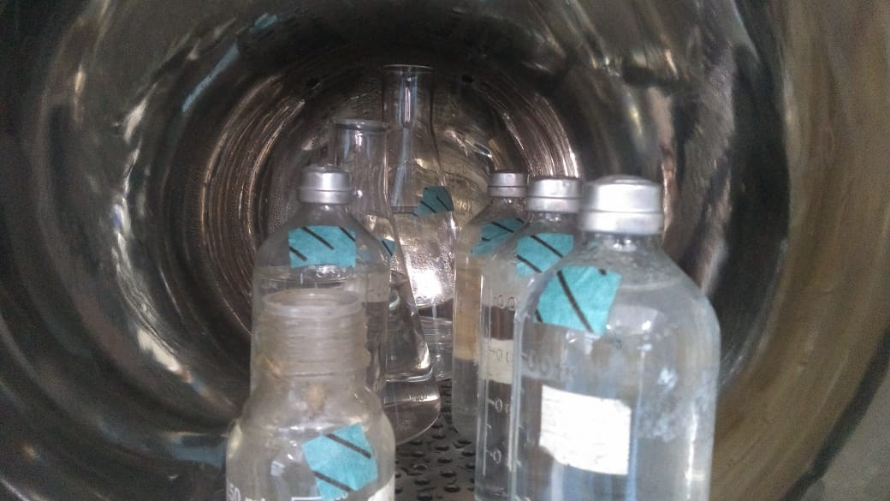
[picture p112: figure]

8 | Realizar el ciclo “Líquidos A” con equipo con aprox. 4 litros de carga y ubicar control físico en el tanque de la autoclave. | | Revisar que el control físico ingresado en el autoclave indique que esterilizo. Revisar que no existan fugas de vapor o agua en ninguna de las conexiones hidráulicas, neumáticas y por el sello de la puerta. Verificar que se realice el ciclo completo que los valores de temperatura y presión tenga correlación. | Ing. Diseño Eléctrico -Electrónico | 25/03/21 | Temperatura inicial = 75.6ºC Hora de inicio = 8:10 Nivel de desfogue= 3 Set point Temperatura = 121º Tiempo de Esterilización = 30:00 min Tiempo de Secado=00:00 Tmax = 121.7 Tmin=121.5 Pmax = 134kpa Pmin=132kpa Ciclo finalizado =9:14 Temperatura final = 89.9 | | ok
9 | Realizar el ciclo “Líquidos B” con equipo sin carga y totalmente cerrado. ---Ciclo 128 ---10 min | | Revisar que no existan fugas de vapor o agua en ninguna de las conexiones hidráulicas, neumáticas y por el sello de la puerta. Verificar que se realice el ciclo completo que los valores de temperatura y presión tenga correlación. | Ing. Diseño Eléctrico -Electrónico | 25/03/21 | Temperatura inicial =44ºC Hora de inicio = 11:00 Nivel de desfogue= 3 Set point Temperatura = 128º Tiempo de Esterilización = 10:00 min Tmax = 128.5 Tmin=128.3 Pmax = 181kpa Pmin=179kpa Ciclo finalizado = 11:40 Temperatura final = 89.9 | | ok
10 | Certificación del equipo de funcionamiento y desempeño por parte de Certificadora acreditada | | Certificar que el equipo cumple con la normatividad vigente. | Dirección Técnica | 25/03/21 | El equipo cumple

_________________________ _______________________

VoBo DIRECTOR TÉCNICO Fecha

NOTA: Se debe anexar a este formato, cada una de las gráficas obtenidas en las pruebas realizadas al equipo, junto con los datos en Excel de cada uno de los ciclos. Se recomienda un tiempo de muestreo de 10 segundos. SIN ESTA INFORMACIÓN ESTE FORMATO NO TENDRÁ VALIDEZ.

JP BIOINGENIERIA S.A.S CONTROL DE CALIDAD PRUEBAS E INSPECCIÓN FINAL FJP – 44 Versión 01 Efectivo a partir de: Febrero 18 de 2018 Documento origen: DJP-26
