judapies/Autoclave/Autoclaves Vertical/Sin Precamara/2020/Autoclave 40L Avantika #004588420 OP2020333/FJP – 44  CONTROL DE CALIDAD PRUEBAS E INSPECCION FINAL-40litros-004588420.docx

NOMBRE PRODUCTO REFERENCIA PROCESO | | Autoclave Vertical 40L JPA50LV Control de Calidad | | | | MODELO ORDEN DE PEDIDO FECHA DE PEDIDO | 2020 2020333
No. | PROCESO | | INSPECCIÓN | REVISADO POR | FECHA | OBSERVACIONES | | PASA (S/N)
1 | Realizar el primer encendido del equipo | | Verificar y ajustar los parámetros (Ganancia, P, I, D, Tciclo, MediaMovil, R51, RPT100B, temperatura, tiempos de esterilización, nivel de desfogue) calibraciones desde Menu de Ajustes. | Ing. Diseño Eléctrico -Electrónico | 26/11/20 | Voltaje de trabajo:220 V Consumo corriente:14.58A temperatura de inicio:18.9 ºC Integral= 2 Derivativo=5 Proporcional=12 Ajuste+=0 Ajuste-=0 Atmosférica= 73 RPT100B= 0.5 Media = 80 Tciclo = 10 Ttrampa= 82
2 | Prueba de Hardware del equipo | | Verificar que cada uno de los componentes del equipo funcionen correctamente utilizando el “Test de componentes”. Ajustar termostato y válvula de seguridad | Ing. Diseño Eléctrico -Electrónico | 26/11/20 | Termostato:150ºC Válvula de seguridad= 37-38 psi aproximadamente Componentes ok
3 | Realizar el ciclo “Líquidos A” con equipo sin carga. | | Revisar que no existan fugas de vapor o agua en ninguna de las conexiones hidráulicas, neumáticas y por el sello de la puerta. Verificar que se realice el ciclo completo que los valores de temperatura y presión tenga correlación. | Ing. Diseño Eléctrico -Electrónico | 26/11/20 | Temperatura inicial = 76.6ºC Presión inicial = 0 Kpa Hora de inicio = 15:00pm Nivel de desfogue= 3 Set point Temperatura = 121º Tiempo de Esterilización = 15:00 min Tmax = 121.1 ºC Pmax = 157 kPa
4 | Realizar el ciclo de “Caucho” con equipo sin carga. | | Revisar que no existan fugas de vapor o agua en ninguna de las conexiones hidráulicas, neumáticas y por el sello de la puerta. Verificar que se realice el ciclo completo que los valores de temperatura y presión tenga correlación. | Ing. Diseño Eléctrico -Electrónico | 26/11/20 | TTrampa=92 Temperatura inicial = 71.1ºC Presión inicial = 0 Kpa Hora de inicio = 15:48 pm Set point Temperatura = 121º Tiempo de Esterilización = 15:00 min Tiempo secado = 3:00 min Tmax = 121.1 ºC Pmax = 142 kPa Hora desfogue = 3:17pm Ciclo finalizado = 3:30pm Temperatura final = 88.9ºC
5 | Realizar el ciclo de “Instrumental” con equipo sin carga. | | Revisar que no existan fugas de vapor o agua en ninguna de las conexiones hidráulicas, neumáticas y por el sello de la puerta. Verificar que se realice el ciclo completo que los valores de temperatura y presión tenga correlación. Verificar Nivel de desfogue. | Ing. Diseño Eléctrico -Electrónico | | No realizado
6 | Realizar el ciclo de “Líquidos B” con equipo sin carga. | | Revisar que no existan fugas de vapor o agua en ninguna de las conexiones hidráulicas, neumáticas y por el sello de la puerta. Verificar que se realice el ciclo completo que los valores de temperatura y presión tenga correlación. Verificar tiempos de esterilización y secado. | Ing. Diseño Eléctrico -Electrónico | | No realizado
7 | Realizar un ciclo “personalizado” con equipo sin carga y con temperatura 134°C, tiempo de esterilización 10 min, sin secado y con nivel de desfogue 3. | | Revisar que no existan fugas de vapor o agua en ninguna de las conexiones hidráulicas, neumáticas y por el sello de la puerta. Verificar que se realice el ciclo completo que los valores de temperatura y presión tenga correlación. | Ing. Diseño Eléctrico -Electrónico | | No Realizado
8 | Realizar el ciclo “Líquidos A” con equipo con aprox. 4 litros de carga y ubicar control físico en el tanque de la autoclave. | | Revisar que el control físico ingresado en el autoclave indique que esterilizo. Revisar que no existan fugas de vapor o agua en ninguna de las conexiones hidráulicas, neumáticas y por el sello de la puerta. Verificar que se realice el ciclo completo que los valores de temperatura y presión tenga correlación. | Ing. Diseño Eléctrico -Electrónico | 27/11/20 | Ajuste+=8 Temperatura inicial = 18.8ºC Presión inicial = 0Kpa Hora de inicio = 7:45 Nivel de desfogue= 3 Set point Temperatura = 121º Tiempo de Esterilización = 15:00 min Tmax = 121.5 ºC Pmax = 132 kPa Hora desfogue = 8:25 am Ciclo finalizado = 8:36 am Temperatura final = 94.4ºC
9 | Realizar el ciclo “Líquidos B” con equipo sin carga y totalmente cerrado. | | Revisar que no existan fugas de vapor o agua en ninguna de las conexiones hidráulicas, neumáticas y por el sello de la puerta. Verificar que se realice el ciclo completo que los valores de temperatura y presión tenga correlación. | Ing. Diseño Eléctrico -Electrónico | 27/11/20 | Ajuste+=5 Temperatura inicial = ºC Presión inicial = 0Kpa Hora de inicio = Nivel de desfogue= 3 Set point Temperatura = 121º Tiempo de Esterilización = 30:00 min Tmax = 121.7 ºC Pmax = 135 kPa Hora desfogue = 11:06 am62626526666556n iclo finalizado = Temperatura final = CON CARGA
10 | Certificación del equipo de funcionamiento y desempeño por parte de Certificadora acreditada | | Certificar que el equipo cumple con la normatividad vigente. | Dirección Técnica | 27/11/20 | El equipo cumple

_________________________ _______________________

VoBo DIRECTOR TÉCNICO Fecha

NOTA: Se debe anexar a este formato, cada una de las gráficas obtenidas en las pruebas realizadas al equipo, junto con los datos en Excel de cada uno de los ciclos. Se recomienda un tiempo de muestreo de 10 segundos. SIN ESTA INFORMACIÓN ESTE FORMATO NO TENDRÁ VALIDEZ.

JP BIOINGENIERIA S.A.S CONTROL DE CALIDAD PRUEBAS E INSPECCIÓN FINAL FJP – 44 Versión 01 Efectivo a partir de: Febrero 18 de 2018 Documento origen: DJP-26
