judapies/Autoclave/Autoclaves Vertical/Sin Precamara/2021/Autoclave 62L Federacion Nacional de Cafeteros #004588629 OP202104/FJP – 44  CONTROL DE CALIDAD PRUEBAS E INSPECCION FINAL-85litros-004588568.docx

NOMBRE PRODUCTO REFERENCIA PROCESO | | Autoclave Horizontal 55L JP55LV Control de Calidad | | | | MODELO ORDEN DE PEDIDO FECHA DE PEDIDO | 2020 2020318
No. | PROCESO | | INSPECCIÓN | REVISADO POR | FECHA | OBSERVACIONES | | PASA (S/N)
1 | Realizar el primer encendido del equipo | | Verificar y ajustar los parámetros (Ganancia, P, I, D, Tciclo, MediaMovil, R51, RPT100B, temperatura, tiempos de esterilización, nivel de desfogue) calibraciones desde Menu de Ajustes. | Ing. Diseño Eléctrico -Electrónico | 16/04/21 | Voltaje de trabajo:210 V Consumo corriente:17A temperatura de inicio:16.8 ºC Integral= 2 Derivativo=12 Proporcional=8 Ajuste+=0 Ajuste-=0 Atmosférica= 72 Pulsos trampa=12 Media = 80 Tciclo = 10 Ttrampa= 50 Ttrampapresion:103kpa | | ok
2 | Prueba de Hardware del equipo | | Verificar que cada uno de los componentes del equipo funcionen correctamente utilizando el “Test de componentes”. Ajustar termostato y válvula de seguridad | Ing. Diseño Eléctrico -Electrónico | 16/04/21 | Termostato:140ºC Válvula de seguridad= 26-30psi aproximadamente Componentes ok | | ok
3 | Realizar el ciclo “Líquidos A” con equipo sin carga. | | Revisar que no existan fugas de vapor o agua en ninguna de las conexiones hidráulicas, neumáticas y por el sello de la puerta. Verificar que se realice el ciclo completo que los valores de temperatura y presión tenga correlación. | Ing. Diseño Eléctrico -Electrónico | 20/04/21 | Temperatura inicial = 93.5 Hora de inicio = 9:56 Nivel de desfogue= 3 Set point Temperatura = 121º Tiempo de Esterilización = 15:00 min Tmax = 122.4 Tmin=121.9 Pmax = 214 Pmin=208 Ciclo finalizado = 11:01 Temperatura final = 89.9 | | ok
4 | Realizar el ciclo de “Caucho” con equipo sin carga. | | Revisar que no existan fugas de vapor o agua en ninguna de las conexiones hidráulicas, neumáticas y por el sello de la puerta. Verificar que se realice el ciclo completo que los valores de temperatura y presión tenga correlación. | Ing. Diseño Eléctrico -Electrónico | 16/04/21 | Trampa:93 Temperatura inicial = 68.0 Hora de inicio = 10:02 Set point Temperatura = 121º Tiempo de Esterilización = 15:00 min Tiempo secado = 3:00 min Tmax = 121.4 Tmin=121.0 Pmax = 214 Pmin=208 Ciclo finalizado = 10:42 Temperatura final = 89.9 | | ok
5 | Realizar el ciclo de “Instrumental” con equipo sin carga. | | Revisar que no existan fugas de vapor o agua en ninguna de las conexiones hidráulicas, neumáticas y por el sello de la puerta. Verificar que se realice el ciclo completo que los valores de temperatura y presión tenga correlación. Verificar Nivel de desfogue. | Ing. Diseño Eléctrico -Electrónico | 16/04/21 | Ttrampa=93 Temperatura inicial = 81 Hora de inicio = 15:25 Set point Temperatura = 121º Tiempo de Esterilización = 30:00 min Tiempo secado = 30:00 min Tmax = 121.4 Tmin=121.0 Pmax = 214 Pmin=208 Ciclo finalizado = 16:40 Temperatura final = 86.1 | | ok
6 | Realizar el ciclo de “Líquidos B” con equipo sin carga. | | Revisar que no existan fugas de vapor o agua en ninguna de las conexiones hidráulicas, neumáticas y por el sello de la puerta. Verificar que se realice el ciclo completo que los valores de temperatura y presión tenga correlación. Verificar tiempos de esterilización y secado. | Ing. Diseño Eléctrico -Electrónico | 20/04/21 | Temperatura inicial = 77.8 Hora de inicio = 14:50 Set point Temperatura = 121º Tiempo de Esterilización = 30:00 min Tiempo secado = 00:00 min Tmax = 122.4 Tmin=122.1 Pmax = 215 Pmin=208 Ciclo finalizado = 15:50 Temperatura final = 89.9 | | ok
7 | Realizar un ciclo “personalizado” con equipo sin carga y con temperatura 123°C, tiempo de esterilización 5 min, sin secado y con nivel de desfogue 3. | | Revisar que no existan fugas de vapor o agua en ninguna de las conexiones hidráulicas, neumáticas y por el sello de la puerta. Verificar que se realice el ciclo completo que los valores de temperatura y presión tenga correlación. | Ing. Diseño Eléctrico -Electrónico | 21/04/21 | Temperatura inicial = 18.8 Hora de inicio = 7:30 Set point Temperatura = 123º Tiempo de Esterilización = 5:00 min Tiempo secado = 00:00 min Tmax = 124.4 Tmin=123.9 Pmax = 215 Pmin=208 Ciclo finalizado = 8:15 Temperatura final =89.9 | | ok
8 | Realizar el ciclo “Líquidos A” con equipo con aprox. 4 litros de carga y ubicar control físico en el tanque de la autoclave. | | Revisar que el control físico ingresado en el autoclave indique que esterilizo. Revisar que no existan fugas de vapor o agua en ninguna de las conexiones hidráulicas, neumáticas y por el sello de la puerta. Verificar que se realice el ciclo completo que los valores de temperatura y presión tenga correlación. | Ing. Diseño Eléctrico -Electrónico | 20/04/21 | Temperatura inicial = Hora de inicio = 10:10 Nivel de desfogue= 3 Set point Temperatura = 121º Tiempo de Esterilización = 15:00 min Tiempo Secado = 00:00 Tmax = 123.2 Tmin=123.0 Pmax = 215kpa Pmin=207kpa Ciclo finalizado = 11:30 Temperatura final =89.9 | | ok
9 | Realizar el ciclo “Líquidos B” con equipo sin carga y totalmente cerrado. Con Carga | | Revisar que no existan fugas de vapor o agua en ninguna de las conexiones hidráulicas, neumáticas y por el sello de la puerta. Verificar que se realice el ciclo completo que los valores de temperatura y presión tenga correlación. | Ing. Diseño Eléctrico -Electrónico | 20/04/21 | Temperatura inicial = Hora de inicio = Nivel de desfogue= 3 Set point Temperatura = 121º Tiempo de Esterilización = 30:00 min Tiempo Secado = 00:00 Tmax = 122.4 Tmin=122.3 Pmax = 215kpa Pmin=207 kpa Cicli Finalizado=4:40 Temperatura final =89.9 | | ok
10 | Certificación del equipo de funcionamiento y desempeño por parte de Certificadora acreditada | | Certificar que el equipo cumple con la normatividad vigente. | Dirección Técnica | 20/04/21 | El equipo cumple | | ok

_________________________ _______________________

VoBo DIRECTOR TÉCNICO Fecha

NOTA: Se debe anexar a este formato, cada una de las gráficas obtenidas en las pruebas realizadas al equipo, junto con los datos en Excel de cada uno de los ciclos. Se recomienda un tiempo de muestreo de 10 segundos. SIN ESTA INFORMACIÓN ESTE FORMATO NO TENDRÁ VALIDEZ.

JP BIOINGENIERIA S.A.S CONTROL DE CALIDAD PRUEBAS E INSPECCIÓN FINAL FJP – 44 Versión 01 Efectivo a partir de: Febrero 18 de 2018 Documento origen: DJP-26
