judapies/Autoclave/Autoclave Horizontal/Sin Precamara/2020/Autoclave 40L Avantika con Reservorio #004588409 OP2020319/Documentos/FJP – 44  CONTROL DE CALIDAD PRUEBAS E INSPECCION FINAL-004588409.docx

NOMBRE PRODUCTO REFERENCIA PROCESO | | Autoclave Horizontal 40L JPA40LH Control de Calidad | | | | MODELO ORDEN DE PEDIDO FECHA DE PEDIDO | 2020 2020318
No. | PROCESO | | INSPECCIÓN | REVISADO POR | FECHA | OBSERVACIONES | | PASA (S/N)
1 | Realizar el primer encendido del equipo | | Verificar y ajustar los parámetros (Ganancia, P, I, D, Tciclo, MediaMovil, R51, RPT100B, temperatura, tiempos de esterilización, nivel de desfogue) calibraciones desde Menu de Ajustes. | Ing. Diseño Eléctrico -Electrónico | 09/11/20 | Voltaje de trabajo:217 V Consumo corriente:9.42ª temperatura de inicio:17.7 ºC Integral= 2 Derivativo=5 Proporcional=12 Ajuste+=0 Ajuste-=0 Atmosférica= 73 RPT100B= 0.5 Media = 80 Tciclo = 10 Ttrampa= 93
2 | Prueba de Hardware del equipo | | Verificar que cada uno de los componentes del equipo funcionen correctamente utilizando el “Test de componentes”. Ajustar termostato y válvula de seguridad | Ing. Diseño Eléctrico -Electrónico | 09/11/20 | Termostato:160ºC Válvula de seguridad= 38-39 psi aproximadamente Componentes ok
3 | Realizar el ciclo “Líquidos A” con equipo sin carga. | | Revisar que no existan fugas de vapor o agua en ninguna de las conexiones hidráulicas, neumáticas y por el sello de la puerta. Verificar que se realice el ciclo completo que los valores de temperatura y presión tenga correlación. | Ing. Diseño Eléctrico -Electrónico | 09/11/20 | Temperatura inicial = 39.5ºC Presión inicial = 72Kpa Hora de inicio = 02:05 pm Nivel de desfogue= 3 Set point Temperatura = 121º Tiempo de Esterilización = 15:00 min Tmax = 122.4 ºC Pmax = 208 kPa Hora desfogue = 2:48pm Ciclo finalizado = 03:02pm Temperatura final = 89.9ºC
4 | Realizar el ciclo de “Caucho” con equipo sin carga. | | Revisar que no existan fugas de vapor o agua en ninguna de las conexiones hidráulicas, neumáticas y por el sello de la puerta. Verificar que se realice el ciclo completo que los valores de temperatura y presión tenga correlación. | Ing. Diseño Eléctrico -Electrónico | 09/11/20 | Ajuste-= 8 Temperatura inicial = 58.9ºC Presión inicial = 72Kpa Hora de inicio = 3:25 pm Set point Temperatura = 121º Tiempo de Esterilización = 15:00 min Tiempo secado = 3:00 min Tmax = 121.6 ºC Pmax = 208 kPa Hora desfogue = 4:07pm Ciclo finalizado = 4:15pm
5 | Realizar el ciclo de “Instrumental” con equipo sin carga. | | Revisar que no existan fugas de vapor o agua en ninguna de las conexiones hidráulicas, neumáticas y por el sello de la puerta. Verificar que se realice el ciclo completo que los valores de temperatura y presión tenga correlación. Verificar Nivel de desfogue. | Ing. Diseño Eléctrico -Electrónico | | No se realizo
6 | Realizar el ciclo de “Líquidos B” con equipo sin carga. | | Revisar que no existan fugas de vapor o agua en ninguna de las conexiones hidráulicas, neumáticas y por el sello de la puerta. Verificar que se realice el ciclo completo que los valores de temperatura y presión tenga correlación. Verificar tiempos de esterilización y secado. | Ing. Diseño Eléctrico -Electrónico | 10/11/20 | Temperatura inicial = 16.7°C Presión inicial = 72Kpa Hora de inicio = 7:18 am Nivel de desfogue= 3 Set point Temperatura = 121º Tiempo de Esterilización = 30:00 min 120.6°C-205kpa iniciando esterilización Tmax = 121.8 ºC Pmax = 208 kPa Hora desfogue = 08:19am Ciclo finalizado = 08:43pm La presión bajo a 66kPa Temperatura final = 89.9ºC
7 | Realizar un ciclo “personalizado” con equipo sin carga y con temperatura 134°C, tiempo de esterilización 10 min, sin secado y con nivel de desfogue 3. | | Revisar que no existan fugas de vapor o agua en ninguna de las conexiones hidráulicas, neumáticas y por el sello de la puerta. Verificar que se realice el ciclo completo que los valores de temperatura y presión tenga correlación. | Ing. Diseño Eléctrico -Electrónico | 10/11/20 | Temperatura inicial = 57.8ºC Presión inicial = 72Kpa Hora de inicio = 9:11 am Nivel de desfogue= 3 Set point Temperatura = 134º Tiempo de Esterilización = 10:00 min Tmax = 134.7 ºC Pmax = 307 kPa Hora desfogue = 08:23am Ciclo finalizado = 08:35pm Temperatura final = 89.9ºC
8 | Realizar el ciclo “Líquidos A” con equipo con aprox. 4 litros de carga y ubicar control físico en el tanque de la autoclave. Sumergir el Pt100 en uno de los frascos con liquido | | Revisar que el control físico ingresado en el autoclave indique que esterilizo. Revisar que no existan fugas de vapor o agua en ninguna de las conexiones hidráulicas, neumáticas y por el sello de la puerta. Verificar que se realice el ciclo completo que los valores de temperatura y presión tenga correlación. | Ing. Diseño Eléctrico -Electrónico | 10/11/20 | Temperatura inicial = 41.4ºC Presión inicial = 73Kpa Hora de inicio = 10:38 am Nivel de desfogue= 3 Set point Temperatura = 121º Tiempo de Esterilización = 15:00 min Tmax = 121.7 ºC Pmax = 216 kPa Hora desfogue = 11:39 Ciclo finalizado = 12:13pm
9 | Realizar el ciclo “Líquidos B” con equipo sin carga y totalmente cerrado. | | Revisar que no existan fugas de vapor o agua en ninguna de las conexiones hidráulicas, neumáticas y por el sello de la puerta. Verificar que se realice el ciclo completo que los valores de temperatura y presión tenga correlación. | Ing. Diseño Eléctrico -Electrónico | 09/11/20 | No se realizo
10 | Certificación del equipo de funcionamiento y desempeño por parte de Certificadora acreditada | | Certificar que el equipo cumple con la normatividad vigente. | Dirección Técnica | 09/11/20 | El equipo cumple

_________________________ _______________________

VoBo DIRECTOR TÉCNICO Fecha

NOTA: Se debe anexar a este formato, cada una de las gráficas obtenidas en las pruebas realizadas al equipo, junto con los datos en Excel de cada uno de los ciclos. Se recomienda un tiempo de muestreo de 10 segundos. SIN ESTA INFORMACIÓN ESTE FORMATO NO TENDRÁ VALIDEZ.

JP BIOINGENIERIA S.A.S CONTROL DE CALIDAD PRUEBAS E INSPECCIÓN FINAL FJP – 44 Versión 01 Efectivo a partir de: Febrero 18 de 2018 Documento origen: DJP-26
