judapies/Autoclave/Autoclaves Vertical/Sin Precamara/2014/Autoclave 40L/NULAB/Autoclave Nulab/Prueba_NULAB2.txt

Time - Plot 0	Temperatura - Plot 0
0	93,2
1	93,7
2	94
3	94,4
4	94,7
5	94,9
6	95,1
7	95,3
8	95,7
9	95,8
10	95,9
11	95,9
12	95,8
13	95,9
14	96
15	96,2
16	96,3
17	96,2
18	96,3
19	96,3
20	96,3
21	96,3
22	96,2
23	96,2
24	96,2
25	96,3
26	96,2
27	96,1
28	96,1
29	96,1
30	96
31	96
32	96
33	96
34	95,9
35	95,8
36	95,9
37	95,8
38	95,8
39	95,9
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
