judapies/Autoclave/Autoclaves Vertical/Con Precamara/2016/Autoclave 85L/Autoclave Nutrizeta/Datos/Pruebas Autoclave 85L/pruebafull.txt

Time - Temeperatura (°C)	Temperatura (°C) & Presión (kPa) - Temeperatura (°C)	Time - Presión (kPa)	Temperatura (°C) & Presión (kPa) - Presión (kPa)
831	19,7	831	0
832	19,7	832	0
833	19,7	833	0
834	19,7	834	0
835	19,7	835	0
836	19,7	836	0
837	19,7	837	0
838	19,7	838	0
839	19,7	839	0
840	19,7	840	0
841	19,7	841	0
842	19,7	842	0
843	19,7	843	0
844	19,7	844	0
845	19,7	845	0
846	19,7	846	0
847	19,7	847	0
848	19,7	848	0
849	19,7	849	0
850	19,7	850	0
851	19,7	851	0
852	19,7	852	0
853	19,7	853	0
854	19,7	854	0
855	19,7	855	0
856	19,7	856	0
857	19,7	857	0
858	19,7	858	0
859	19,7	859	0
860	19,7	860	0
861	19,7	861	0
862	19,7	862	0
863	19,7	863	0
864	19,7	864	0
865	19,7	865	0
866	19,7	866	0
867	19,7	867	0
868	19,7	868	0
869	19,6	869	0
870	19,6	870	0
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
