judapies/Autoclave/Autoclave Horizontal/Sin Precamara/2015/Autoclaves Mayaguez/JPA23LH/Mto 21-05-2021/Pruebas/Pruebas autoclave/prueba1(fail).txt

Time - Temeperatura (°C)	Temperatura (°C) & Presión (kPa) - Temeperatura (°C)	Time - Presión (kPa)	Temperatura (°C) & Presión (kPa) - Presión (kPa)
243	64,5	243	0
244	64,5	244	0
245	64,5	245	0
246	64,6	246	0
247	64,6	247	0
248	64,8	248	0
249	64,8	249	0
250	64,9	250	0
251	64,9	251	0
252	64,9	252	0
253	65	253	0
254	65	254	0
255	65	255	0
256	65	256	0
257	65,1	257	0
258	65,1	258	0
259	65,3	259	0
260	65,3	260	0
261	65,4	261	0
262	65,4	262	0
263	65,5	263	0
264	65,5	264	0
265	65,5	265	0
266	65,5	266	0
267	65,6	267	0
268	65,6	268	0
269	65,8	269	0
270	65,8	270	0
271	65,9	271	0
272	65,9	272	0
273	66	273	0
274	66	274	0
275	66	275	0
276	66	276	0
277	66,1	277	0
278	66,1	278	0
279	66,3	279	0
280	66,3	280	0
281	66,3	281	0
282	66,4	282	0
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
