judapies/Autoclave/Autoclave Horizontal/Sin Precamara/2015/Autoclaves Mayaguez/JPA23LH/Mto 21-05-2021/Pruebas/Pruebas autoclave/prueba_caucho.txt

Time - Temeperatura (°C)	Temperatura (°C) & Presión (kPa) - Temeperatura (°C)	Time - Presión (kPa)	Temperatura (°C) & Presión (kPa) - Presión (kPa)
0	66,3	0	1
1	63,5	1	0
2	63,5	2	0
3	63,5	3	0
4	63,5	4	0
5	63,5	5	0
6	63,5	6	0
7	63,4	7	0
8	63,4	8	0
9	63,4	9	0
10	63,4	10	0
11	63,4	11	0
12	63,4	12	0
13	63,4	13	0
14	63,4	14	0
15	63,4	15	0
16	63,4	16	0
17	63,4	17	0
18	63,4	18	0
19	63,2	19	0
20	63,2	20	0
21	63,2	21	0
22	63,2	22	0
23	63,2	23	0
24	63,2	24	0
25	63,2	25	0
26	63,2	26	0
27	63,2	27	0
28	63,2	28	0
29	63,2	29	0
30	63,2	30	0
31	63,2	31	0
32	63,2	32	0
33	63,2	33	0
34	63,2	34	0
35	63,2	35	0
36	63,2	36	0
37	63	37	0
38	63	38	0
39	63	39	0
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
