judapies/Autoclave/Autoclave Horizontal/Sin Precamara/2015/Autoclaves Mayaguez/JPA23LH/Mto 21-05-2021/Pruebas/Pruebas autoclave/prueba_instrumentos.txt

Time - Temeperatura (°C)	Temperatura (°C) & Presión (kPa) - Temeperatura (°C)	Time - Presión (kPa)	Temperatura (°C) & Presión (kPa) - Presión (kPa)
0	59,4	0	0
1	57,5	1	0
2	57,5	2	0
3	57,5	3	0
4	57,5	4	0
5	57,5	5	0
6	57,5	6	0
7	57,5	7	0
8	57,5	8	0
9	57,5	9	0
10	57,5	10	0
11	57,5	11	0
12	57,5	12	0
13	57,5	13	0
14	57,5	14	0
15	57,5	15	0
16	57,5	16	0
17	57,5	17	0
18	57,5	18	0
19	57,5	19	0
20	57,5	20	0
21	57,5	21	0
22	57,5	22	0
23	57,5	23	0
24	57,5	24	0
25	57,5	25	0
26	57,5	26	0
27	57,5	27	0
28	57,5	28	0
29	57,5	29	0
30	57,5	30	0
31	57,5	31	0
32	57,5	32	0
33	57,5	33	0
34	57,5	34	0
35	57,5	35	0
36	57,5	36	0
37	57,5	37	0
38	57,5	38	0
39	57,5	39	0
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
