judapies/Autoclave/Autoclave Horizontal/Sin Precamara/2015/Autoclaves Mayaguez/JPA23LH/Mto 21-05-2021/Pruebas/Pruebas autoclave/prueba_liquidoA_lleno.txt

Time - Temeperatura (°C)	Temperatura (°C) & Presión (kPa) - Temeperatura (°C)	Time - Presión (kPa)	Temperatura (°C) & Presión (kPa) - Presión (kPa)
0	0	0	0
1	0	1	0
2	0	2	0
3	0	3	0
4	0	4	0
5	0	5	0
6	0	6	0
7	0	7	0
8	0	8	0
9	0	9	0
10	0	10	0
11	0	11	0
12	67	12	0
13	67	13	0
14	67	14	0
15	67	15	0
16	67	16	0
17	67	17	0
18	67	18	0
19	66,9	19	0
20	66,9	20	0
21	66,9	21	0
22	66,9	22	0
23	66,9	23	0
24	66,9	24	0
25	66,9	25	0
26	66,9	26	0
27	66,9	27	0
28	66,9	28	0
29	67	29	0
30	67	30	0
31	67	31	0
32	67	32	0
33	67	33	0
34	67	34	0
35	67	35	0
36	67,1	36	0
37	67,1	37	0
38	67,3	38	0
39	67,3	39	0
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
