judapies/Autoclave/Autoclave Horizontal/Sin Precamara/2015/Autoclaves Mayaguez/JPA23LH/Mto 21-05-2021/Pruebas/Pruebas autoclave/prueba_liquidoB_lleno.txt

Time - Temeperatura (°C)	Temperatura (°C) & Presión (kPa) - Temeperatura (°C)	Time - Presión (kPa)	Temperatura (°C) & Presión (kPa) - Presión (kPa)
110	17,7	110	0
111	17,7	111	0
112	17,7	112	0
113	17,7	113	0
114	17,7	114	0
115	17,7	115	0
116	17,7	116	0
117	17,7	117	0
118	17,7	118	0
119	17,7	119	0
120	17,7	120	0
121	17,7	121	0
122	17,7	122	0
123	17,7	123	0
124	17,7	124	0
125	17,7	125	0
126	17,7	126	0
127	17,7	127	0
128	17,7	128	0
129	17,7	129	0
130	17,7	130	0
131	17,7	131	0
132	17,7	132	0
133	17,7	133	0
134	17,7	134	0
135	17,7	135	0
136	17,7	136	0
137	17,7	137	0
138	17,7	138	0
139	17,7	139	0
140	17,7	140	0
141	17,7	141	0
142	17,7	142	0
143	17,7	143	0
144	17,7	144	0
145	17,7	145	0
146	17,7	146	0
147	17,7	147	0
148	17,7	148	0
149	17,7	149	0
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
