judapies/Autoclave/Autoclave Horizontal/Sin Precamara/2015/Autoclaves Mayaguez/JPA23LH/Mto 21-05-2021/Pruebas/Pruebas autoclave/prueba_liquidosA.txt

Time - Temeperatura (°C)	Temperatura (°C) & Presión (kPa) - Temeperatura (°C)	Time - Presión (kPa)	Temperatura (°C) & Presión (kPa) - Presión (kPa)
2003	73,9	2003	0
2004	73,9	2004	0
2005	74	2005	0
2006	74	2006	0
2007	74	2007	0
2008	74	2008	0
2009	74,1	2009	0
2010	74,1	2010	0
2011	74,3	2011	0
2012	74,3	2012	0
2013	74,4	2013	0
2014	74,4	2014	0
2015	74,5	2015	0
2016	74,5	2016	0
2017	74,5	2017	0
2018	74,5	2018	0
2019	74,6	2019	0
2020	74,6	2020	0
2021	74,8	2021	0
2022	74,8	2022	0
2023	74,9	2023	0
2024	74,9	2024	0
2025	75	2025	0
2026	75	2026	0
2027	75	2027	0
2028	75	2028	0
2029	75,1	2029	0
2030	75,1	2030	0
2031	75,1	2031	0
2032	75,1	2032	0
2033	75,3	2033	0
2034	75,3	2034	0
2035	75,4	2035	0
2036	75,4	2036	0
2037	75,5	2037	0
2038	75,5	2038	0
2039	75,5	2039	0
2040	75,5	2040	0
2041	75,5	2041	0
2042	75,5	2042	0
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
