judapies/Autoclave/Autoclave Horizontal/Sin Precamara/2015/Autoclaves Mayaguez/JPA23LH/Mto 21-05-2021/Pruebas/Pruebas autoclave/Prueba_liquidosB.txt

Time - Temeperatura (°C)	Temperatura (°C) & Presión (kPa) - Temeperatura (°C)	Time - Presión (kPa)	Temperatura (°C) & Presión (kPa) - Presión (kPa)
0	73,8	0	0
1	73,9	1	0
2	73,9	2	0
3	73,9	3	0
4	73,9	4	0
5	73,9	5	0
6	73,9	6	0
7	73,9	7	0
8	73,9	8	0
9	73,9	9	0
10	73,9	10	0
11	73,9	11	0
12	73,9	12	0
13	73,9	13	0
14	73,9	14	0
15	73,9	15	0
16	73,9	16	0
17	73,9	17	0
18	73,9	18	0
19	73,9	19	0
20	73,9	20	0
21	73,9	21	0
22	73,9	22	0
23	73,9	23	0
24	73,9	24	0
25	73,9	25	0
26	73,9	26	0
27	74	27	0
28	74	28	0
29	74	29	0
30	74,1	30	0
31	74,3	31	0
32	74,4	32	0
33	74,5	33	0
34	74,5	34	0
35	74,6	35	0
36	74,8	36	0
37	75	37	0
38	75	38	0
39	75,1	39	0
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
