judapies/Autoclave/Autoclave Horizontal/Sin Precamara/2015/Autoclaves Mayaguez/JPA23LH/Mto 21-05-2021/Pruebas/Pruebas autoclave/prueba_personalizada(fail).txt

Time - Temeperatura (°C)	Temperatura (°C) & Presión (kPa) - Temeperatura (°C)	Time - Presión (kPa)	Temperatura (°C) & Presión (kPa) - Presión (kPa)
0	43,7	0	0
1	41,7	1	0
2	41,7	2	0
3	41,7	3	0
4	41,7	4	0
5	41,7	5	0
6	41,7	6	0
7	41,7	7	0
8	41,7	8	0
9	41,7	9	0
10	41,7	10	0
11	41,7	11	0
12	41,7	12	0
13	41,7	13	0
14	41,7	14	0
15	41,7	15	0
16	41,7	16	0
17	41,7	17	0
18	41,7	18	0
19	41,7	19	0
20	41,7	20	0
21	41,7	21	0
22	41,7	22	0
23	41,7	23	0
24	41,7	24	0
25	41,7	25	0
26	41,7	26	0
27	41,7	27	0
28	41,5	28	0
29	41,5	29	0
30	41,5	30	0
31	41,5	31	0
32	41,5	32	0
33	41,5	33	0
34	41,5	34	0
35	41,5	35	0
36	41,5	36	0
37	41,5	37	0
38	41,5	38	0
39	41,5	39	0
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
