judapies/Autoclave/Autoclave Horizontal/Sin Precamara/2015/Autoclaves Mayaguez/JPA23LH/Mto 21-05-2021/Pruebas/Pruebas autoclave/prueba_personalizada.txt

Time - Temeperatura (°C)	Temperatura (°C) & Presión (kPa) - Temeperatura (°C)	Time - Presión (kPa)	Temperatura (°C) & Presión (kPa) - Presión (kPa)
0	68,9	0	0
1	66,5	1	0
2	66,5	2	0
3	66,5	3	0
4	66,5	4	0
5	66,6	5	0
6	66,6	6	0
7	66,8	7	0
8	66,8	8	0
9	66,8	9	0
10	66,9	10	0
11	66,9	11	0
12	66,9	12	0
13	67	13	0
14	67	14	0
15	67	15	0
16	67	16	0
17	67,1	17	0
18	67,1	18	0
19	67,1	19	0
20	67,3	20	0
21	67,3	21	0
22	67,4	22	0
23	67,4	23	0
24	67,4	24	0
25	67,5	25	0
26	67,5	26	0
27	67,5	27	0
28	67,5	28	0
29	67,5	29	0
30	67,5	30	0
31	67,6	31	0
32	67,6	32	0
33	67,6	33	0
34	67,8	34	0
35	67,8	35	0
36	67,8	36	0
37	67,9	37	0
38	67,9	38	0
39	67,9	39	0
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
