judapies/Autoclave/Autoclaves Vertical/Sin Precamara/2014/Autoclave 40L/NULAB/pruebavacio2.docx

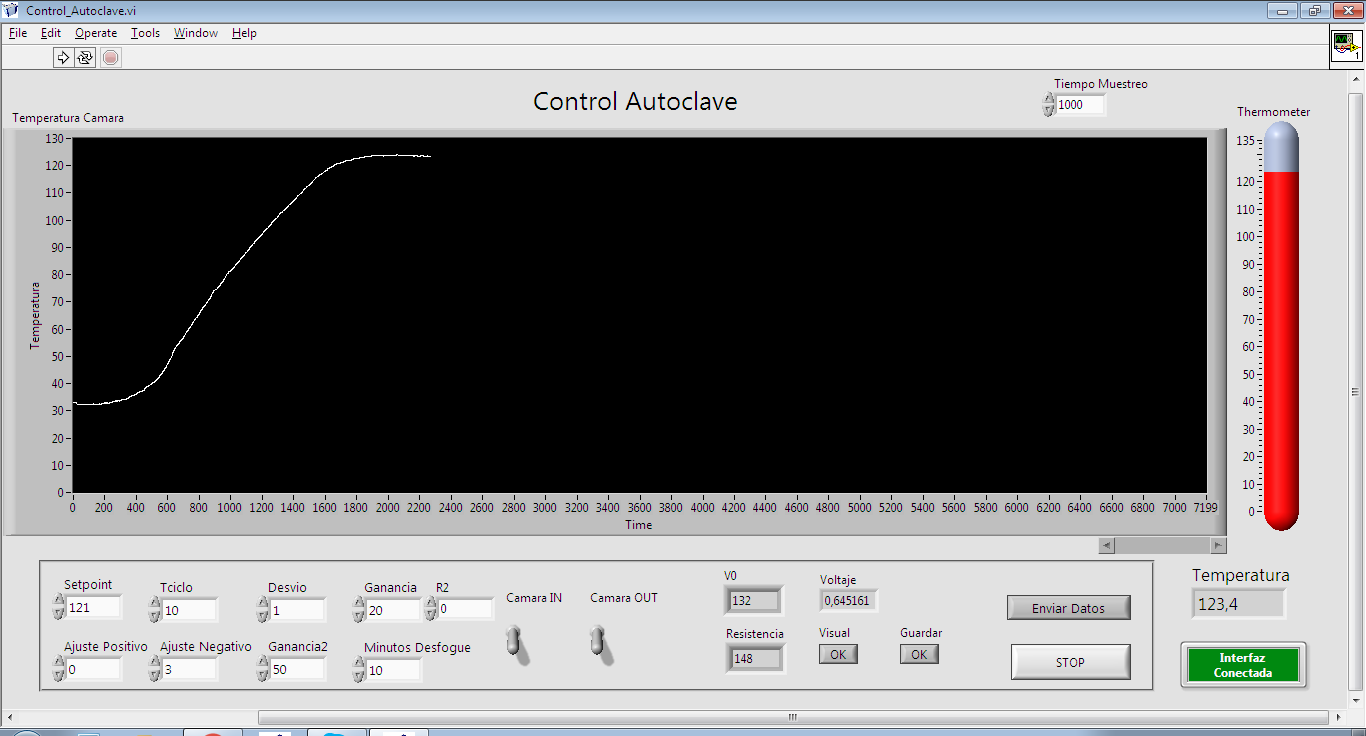
[picture p123: figure]
