judapies/Autoclave/Autoclaves Vertical/Sin Precamara/2015/Autoclave 27L/Autoclaves Universidad de Nariño/imagen pruebas autoclaves.docx

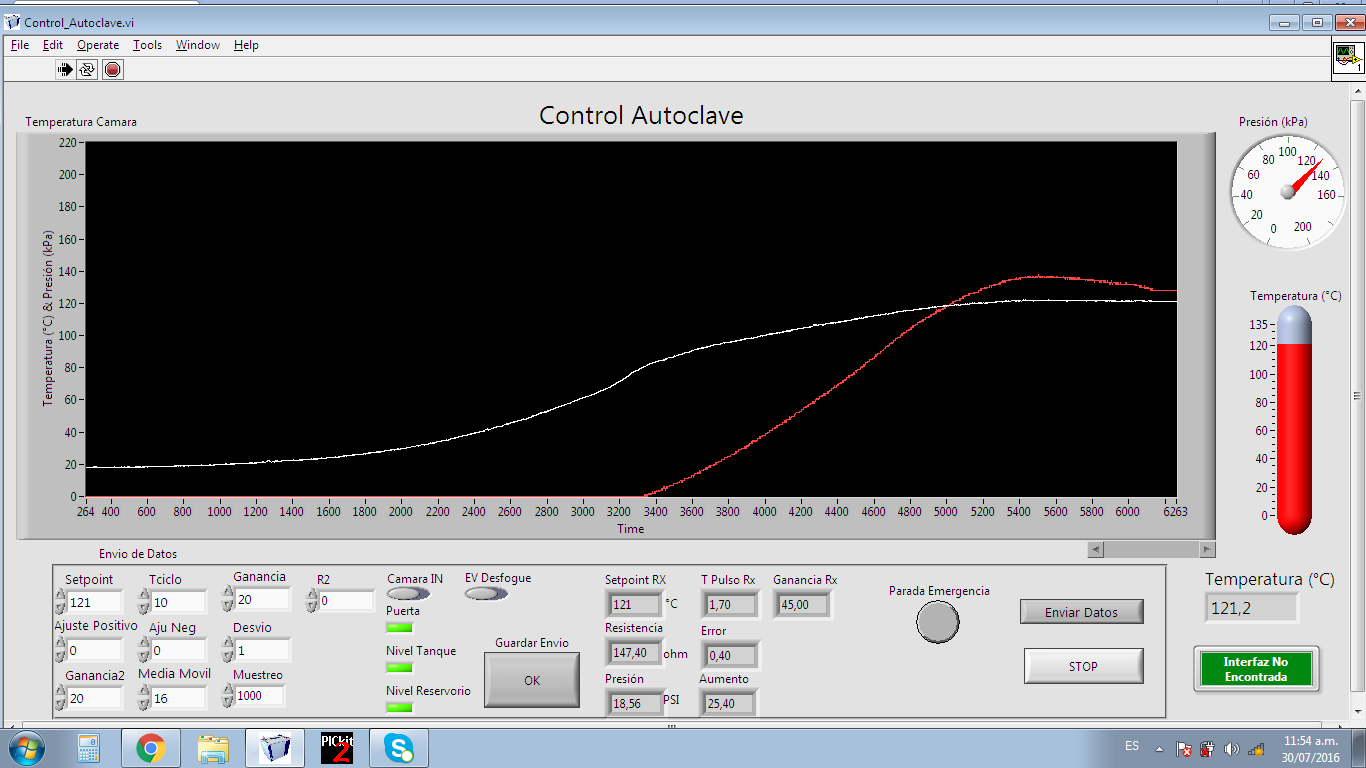
[picture p124: figure]
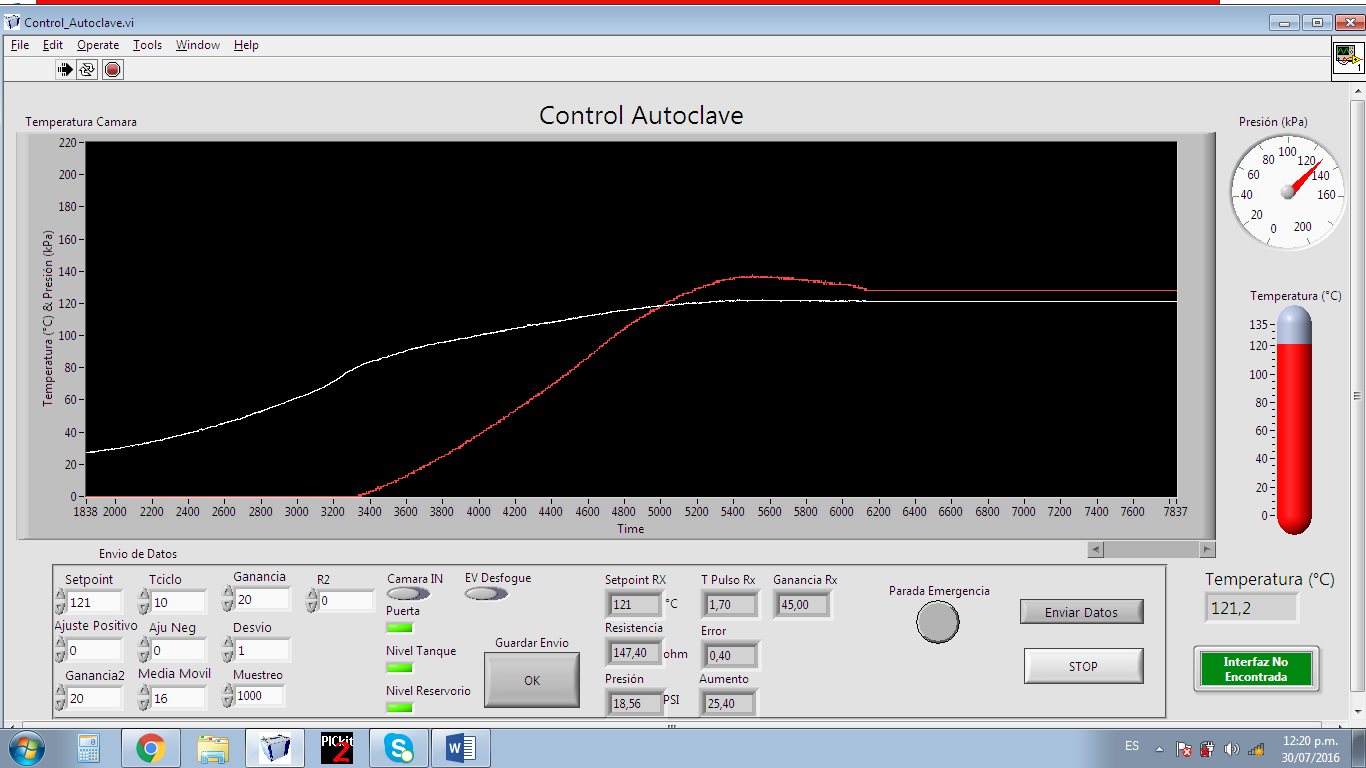
[picture p125: figure]
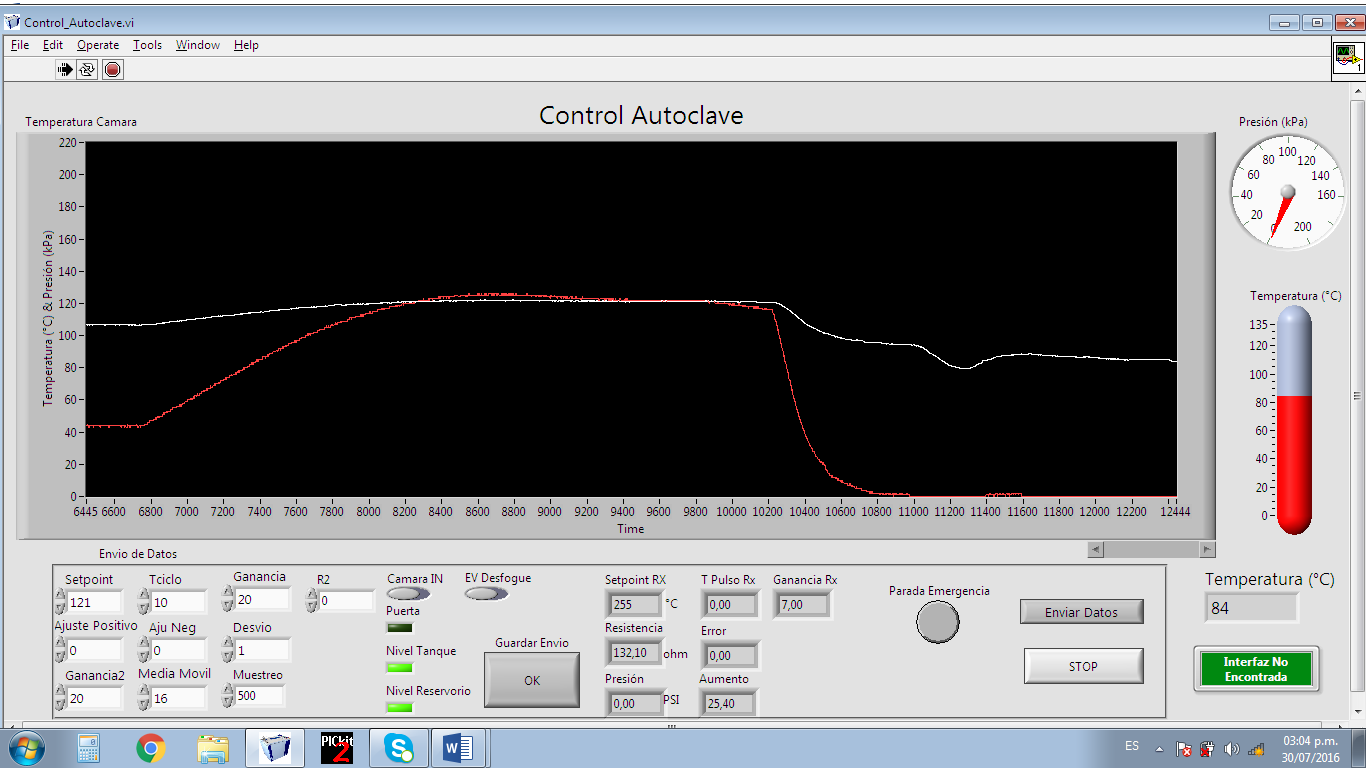
[picture p126: figure]
