judapies/Autoclave/Autoclave Horizontal/Con Precamara/2016/Autoclave 110L/Autoclave ArtiLab/Datos/prueba autoclave 104 II.bmp

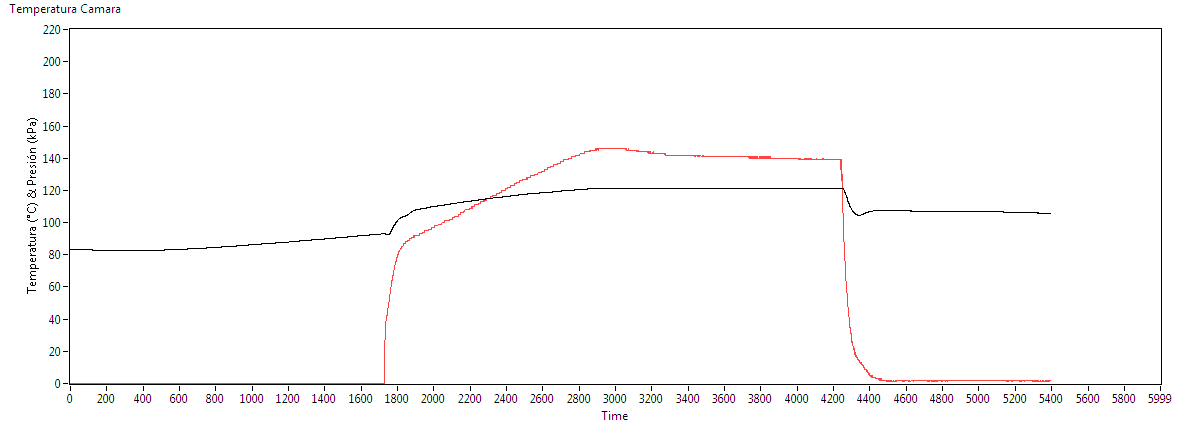
Autoclave Horizontal/Con Precamara/2016/Autoclave 110L/Autoclave ArtiLab/Datos/prueba autoclave 104 II.bmp
