judapies/Autoclave/Autoclave Horizontal/Con Precamara/2016/Autoclave 110L/Autoclave Santa Marta/Datos/Pruebas Autoclave Santa Marta/Au110L_01.bmp

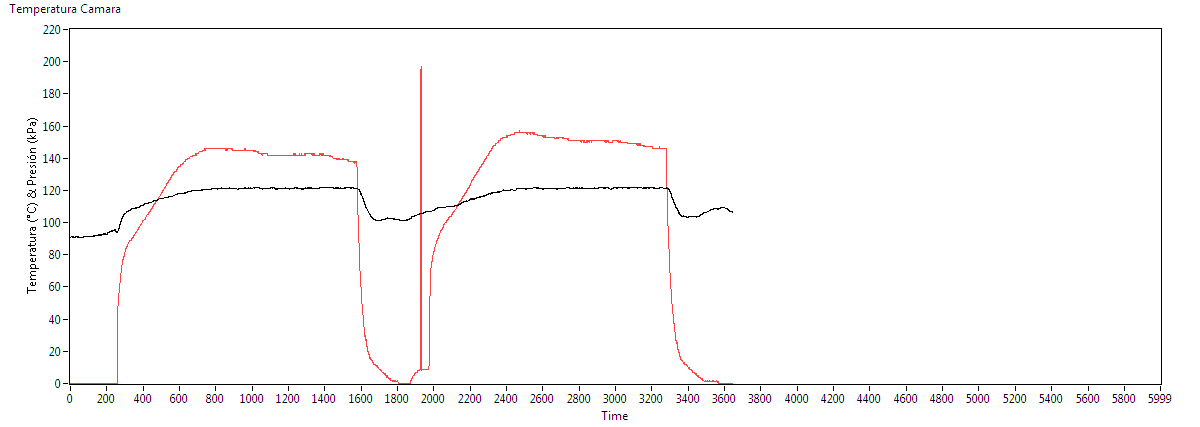
Autoclave Horizontal/Con Precamara/2016/Autoclave 110L/Autoclave Santa Marta/Datos/Pruebas Autoclave Santa Marta/Au110L_01.bmp
