judapies/Autoclave/Autoclave Horizontal/Con Precamara/2016/Autoclave 120L/Autoclave TecniLab/Documentos/Pruebas Autoclave 120L/Auto120'L_03.bmp

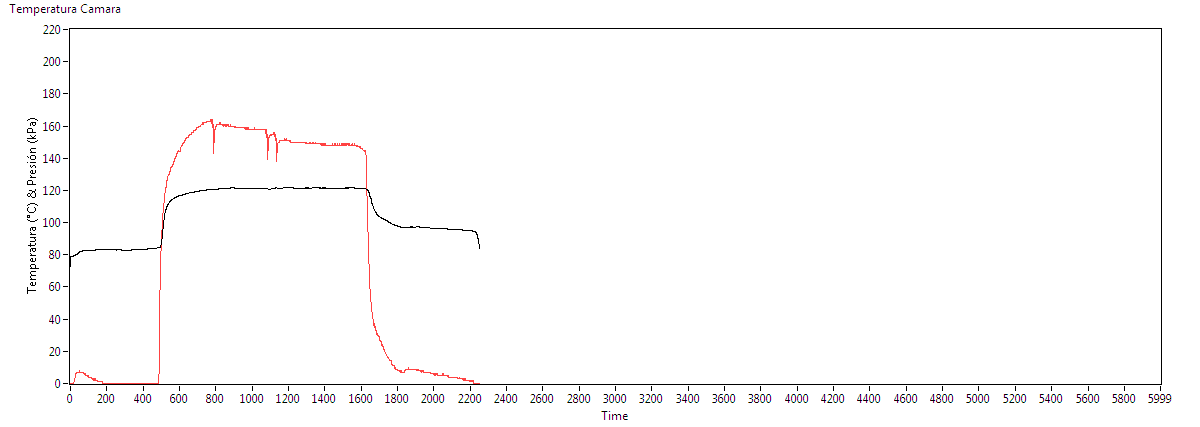
Autoclave Horizontal/Con Precamara/2016/Autoclave 120L/Autoclave TecniLab/Documentos/Pruebas Autoclave 120L/Auto120'L_03.bmp
