judapies/Autoclave/Autoclave Horizontal/Con Precamara/2018/Autoclave 85L con vacio  #004587822/Datos/AUT85LH/Test_Bowie_dick.bmp

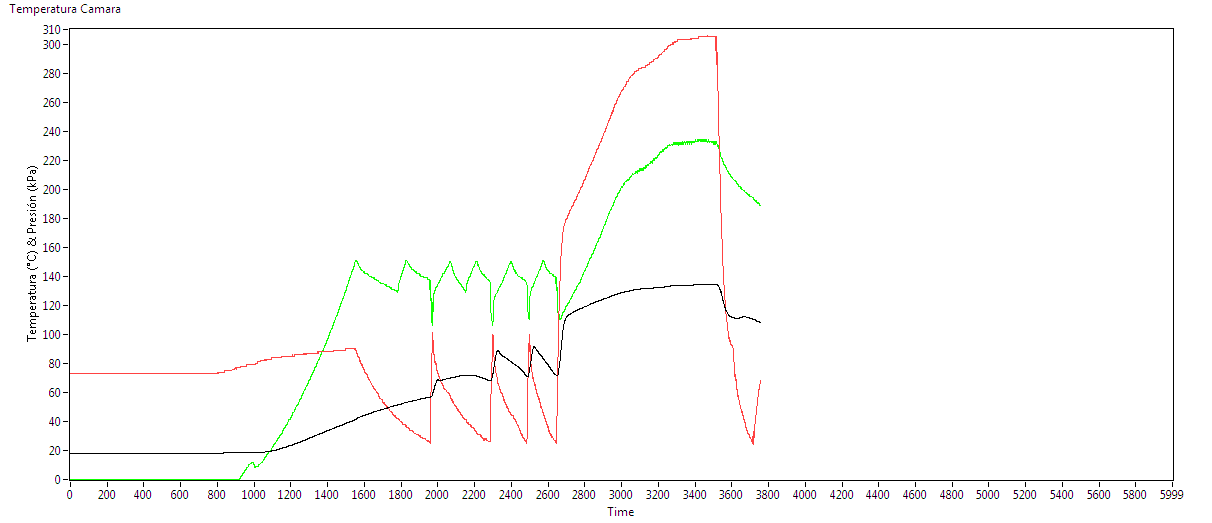
Autoclave Horizontal/Con Precamara/2018/Autoclave 85L con vacio #004587822/Datos/AUT85LH/Test_Bowie_dick.bmp
