judapies/Autoclave/Autoclave Horizontal/Con Precamara/2021/Autoclave 62L Dempharma SAS OP2021108 #004588634/Pruebas/AJUSTE +2 134.bmp

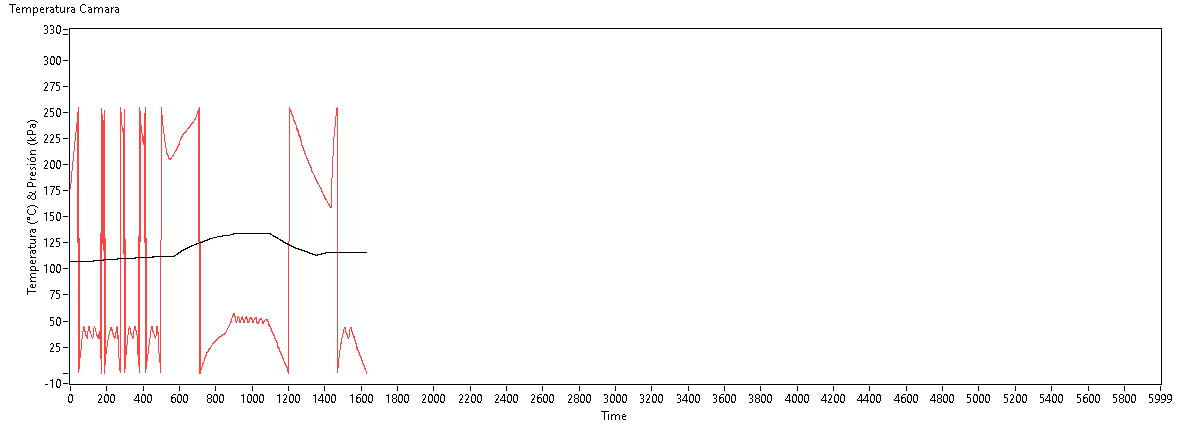
Autoclave Horizontal/Con Precamara/2021/Autoclave 62L Dempharma SAS OP2021108 #004588634/Pruebas/AJUSTE +2 134.bmp
