judapies/Autoclave/Autoclave Horizontal/Con Precamara/2021/Autoclave 110L Biocacol OP2021110 #004588639/Pruebas/Autoclave 110 litros/BOWIE AND DICK.bmp

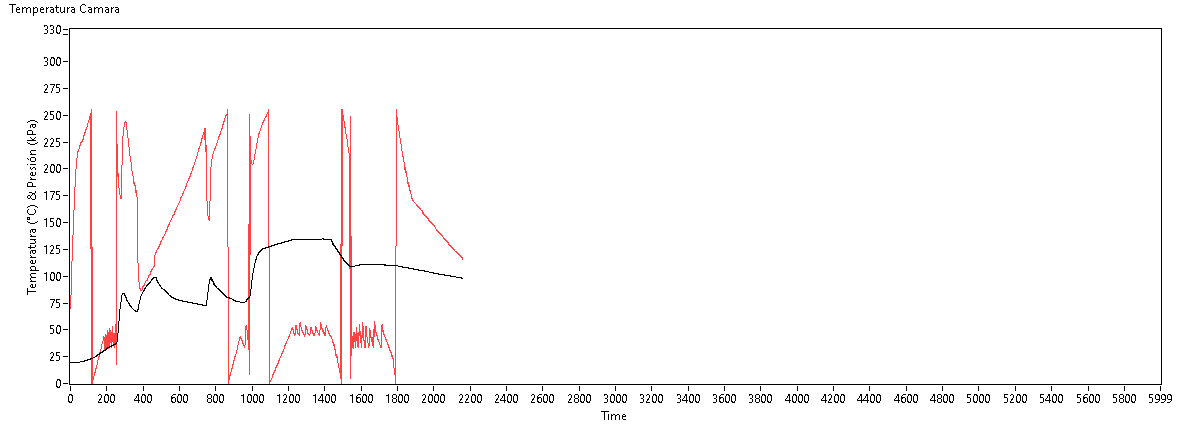
Autoclave Horizontal/Con Precamara/2021/Autoclave 110L Biocacol OP2021110 #004588639/Pruebas/Autoclave 110 litros/BOWIE AND DICK.bmp
