judapies/Autoclave/Autoclave Horizontal/Con Precamara/2021/Autoclave 110L Biocacol OP2021110 #004588639/Pruebas/Autoclave 110 litros/Fotos/WhatsApp Image 2021-07-08 at 4.02.09 PM.jpeg

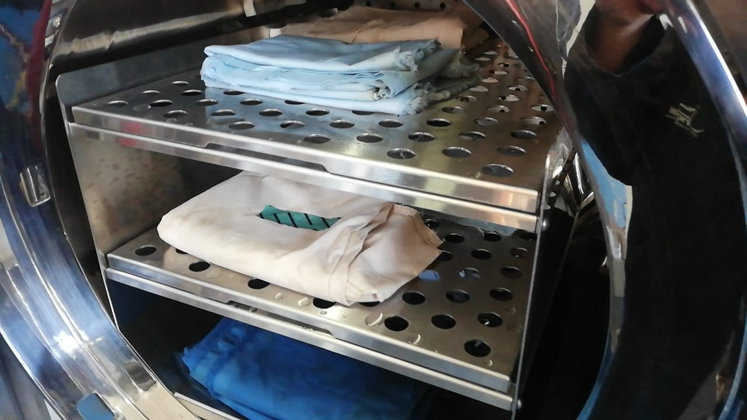
Autoclave Horizontal/Con Precamara/2021/Autoclave 110L Biocacol OP2021110 #004588639/Pruebas/Autoclave 110 litros/Fotos/WhatsApp Image 2021-07-08 at 4.02.09 PM.jpeg
