judapies/Autoclave/Autoclave Horizontal/Sin Precamara/2015/Autoclaves Mayaguez/Ajustes Autoclaves Mayaguez/Cambio Tarjetas/JPA23LH/Datos/Prueba_Caucho.bmp

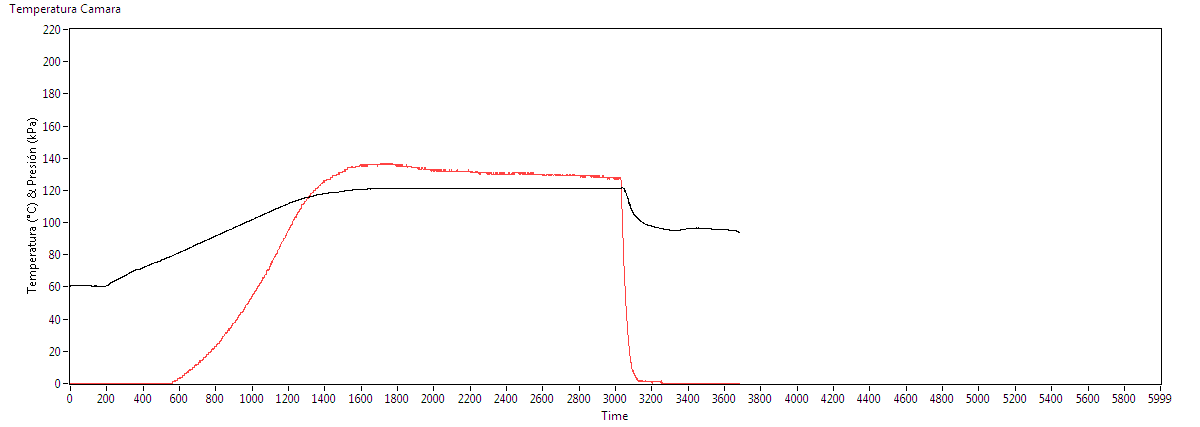
Autoclave Horizontal/Sin Precamara/2015/Autoclaves Mayaguez/Ajustes Autoclaves Mayaguez/Cambio Tarjetas/JPA23LH/Datos/Prueba_Caucho.bmp
