judapies/Autoclave/Autoclave Horizontal/Sin Precamara/2016/Autoclave 23L Microlab/Documentos/Pruebas Autoclave Microlab/Prueba_01.bmp

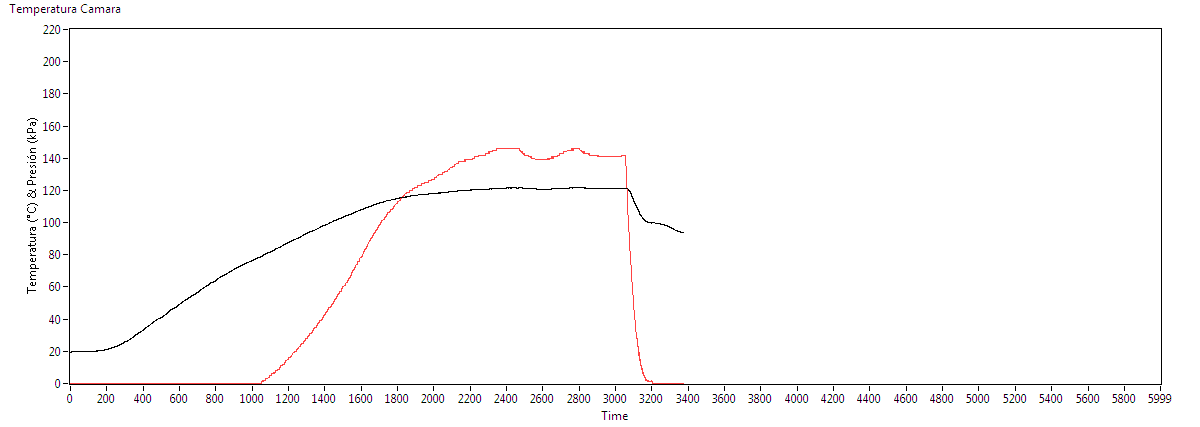
Autoclave Horizontal/Sin Precamara/2016/Autoclave 23L Microlab/Documentos/Pruebas Autoclave Microlab/Prueba_01.bmp
