judapies/Autoclave/Autoclave Horizontal/Sin Precamara/2018/Autoclave 34L-V3.1 ArtiLab  #004587829/Datos/PRUEBA _CARGA_OVEROL.bmp

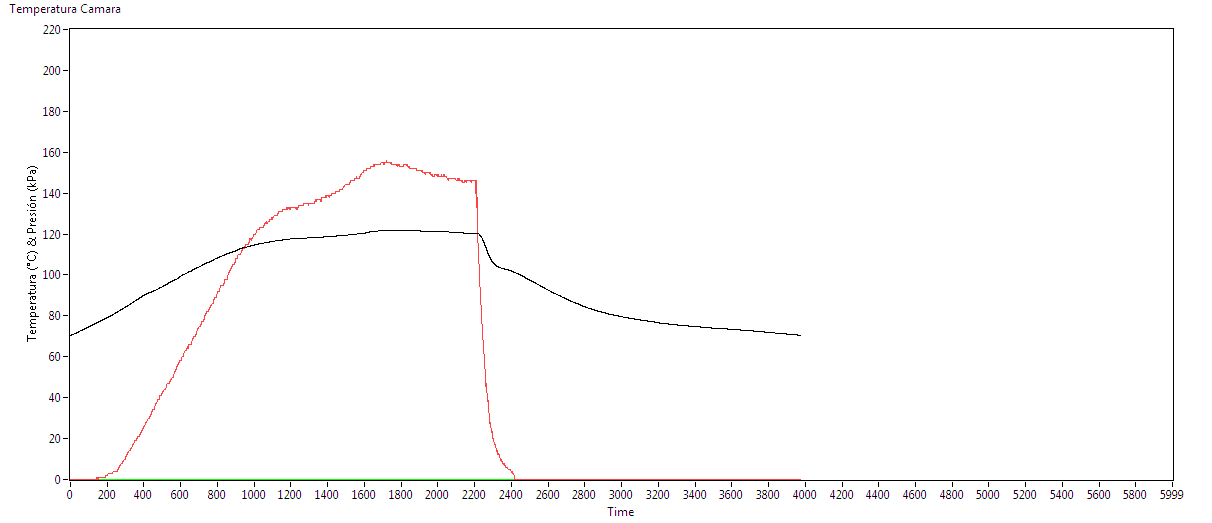
Autoclave Horizontal/Sin Precamara/2018/Autoclave 34L-V3.1 ArtiLab #004587829/Datos/PRUEBA _CARGA_OVEROL.bmp
