judapies/Autoclave/Autoclave Horizontal/Sin Precamara/2018/Autoclave 34L-V3.1 ArtiLab  #004587829/Datos/PRUEBA CON CARGA.bmp

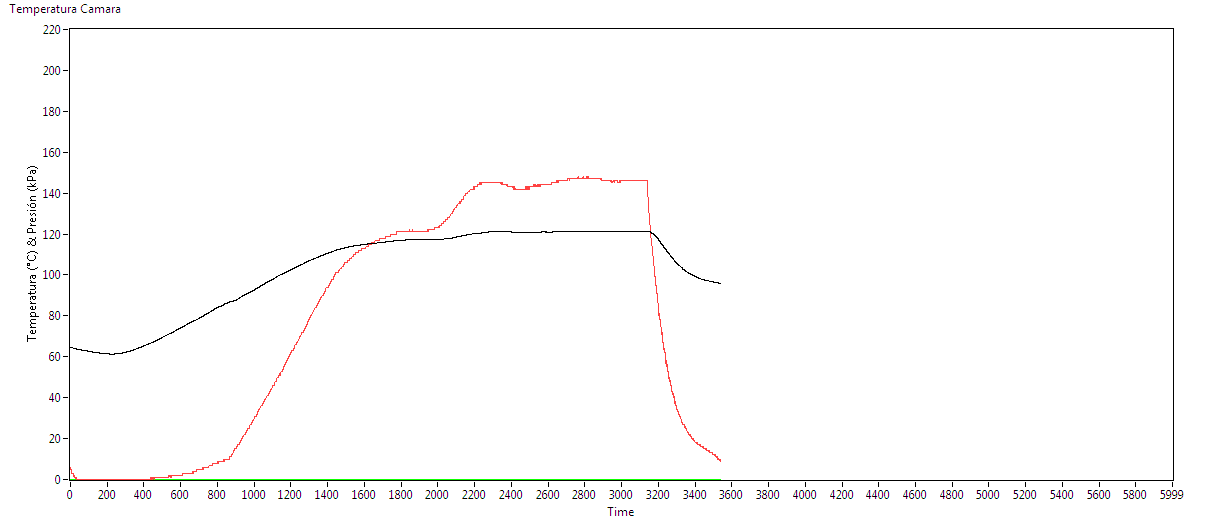
Autoclave Horizontal/Sin Precamara/2018/Autoclave 34L-V3.1 ArtiLab #004587829/Datos/PRUEBA CON CARGA.bmp
