judapies/Autoclave/Autoclaves Vertical/Con Precamara/2016/Autoclave 85L/Autoclave Nutrizeta/Datos/Pruebas Autoclave 85L/Aut85L_01.bmp

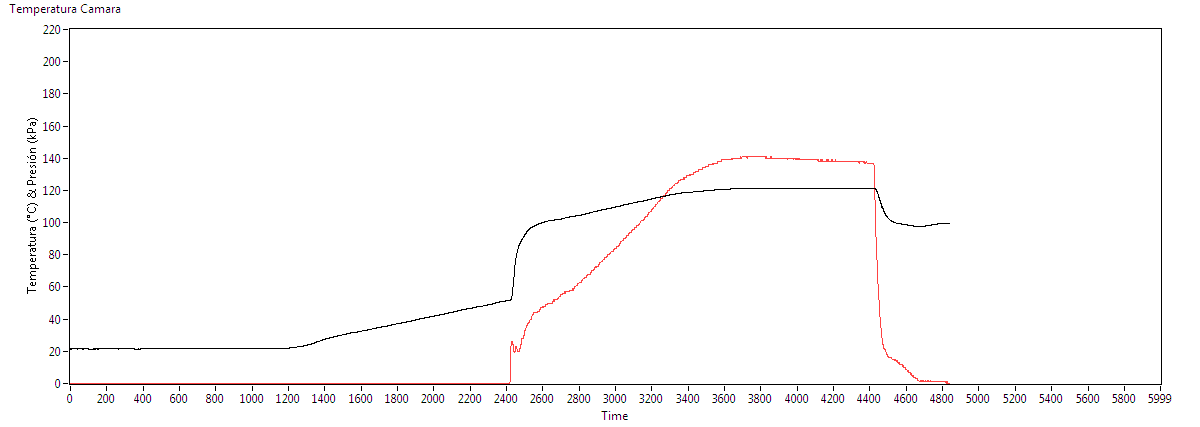
Autoclaves Vertical/Con Precamara/2016/Autoclave 85L/Autoclave Nutrizeta/Datos/Pruebas Autoclave 85L/Aut85L_01.bmp
