judapies/Autoclave/Autoclaves Vertical/Con Precamara/2016/Autoclave 85L/Autoclave Nutrizeta/Datos/Pruebas Autoclave 85L/hjg.bmp

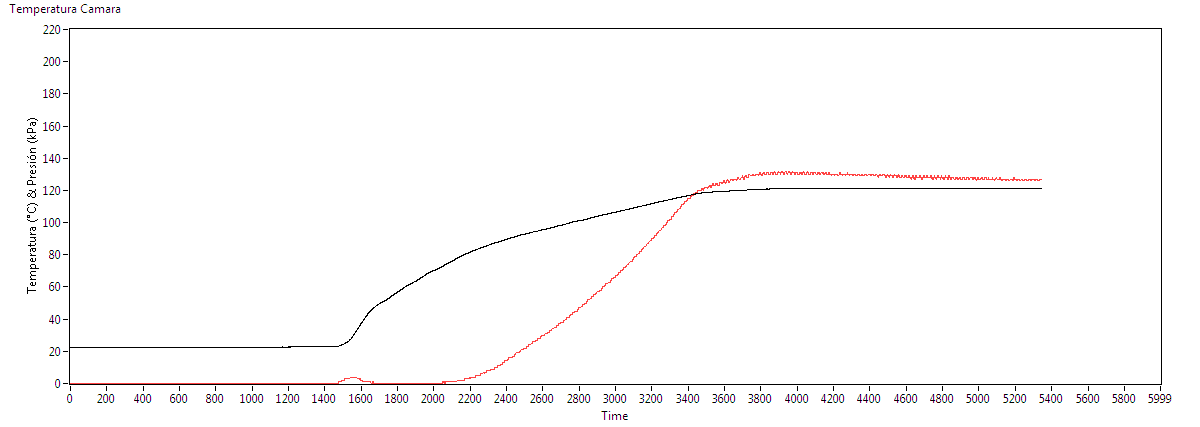
Autoclaves Vertical/Con Precamara/2016/Autoclave 85L/Autoclave Nutrizeta/Datos/Pruebas Autoclave 85L/hjg.bmp
