judapies/Autoclave/Autoclaves Vertical/Con Precamara/2016/Autoclave 85L/Autoclave UPTC/Documentos/Pruebas Autoclave 85L/Auto85L_03.bmp

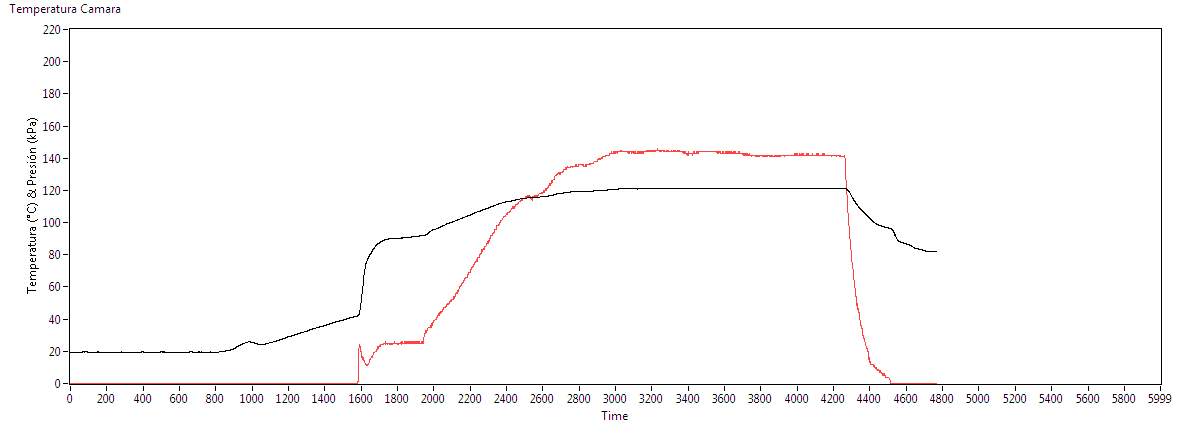
Autoclaves Vertical/Con Precamara/2016/Autoclave 85L/Autoclave UPTC/Documentos/Pruebas Autoclave 85L/Auto85L_03.bmp
