judapies/Autoclave/Autoclaves Vertical/Con Precamara/2016/Autoclave 150L/Autoclave SENA/Prueba Tintas Penetrantes/IMG_6096.JPG

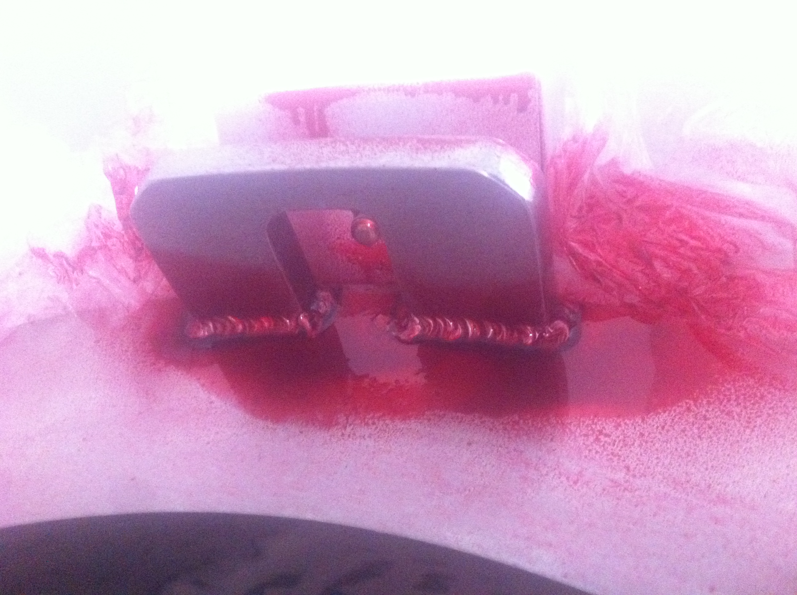
Autoclaves Vertical/Con Precamara/2016/Autoclave 150L/Autoclave SENA/Prueba Tintas Penetrantes/IMG_6096.JPG
