judapies/Autoclave/Autoclaves Vertical/Con Precamara/2016/Autoclave 150L/Autoclave SENA/Pruebas/160L03.bmp

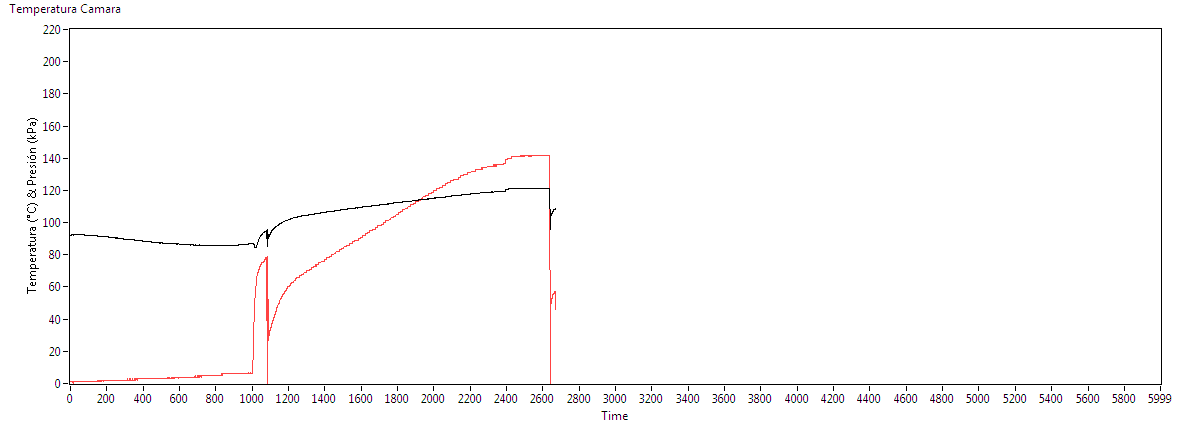
Autoclaves Vertical/Con Precamara/2016/Autoclave 150L/Autoclave SENA/Pruebas/160L03.bmp
