judapies/Autoclave/Autoclaves Vertical/Con Precamara/2017/Autoclave 85L/Autoclave Luker #004587664/Documentos/Pruebas Autoclave 85L/Auto85L_05.bmp

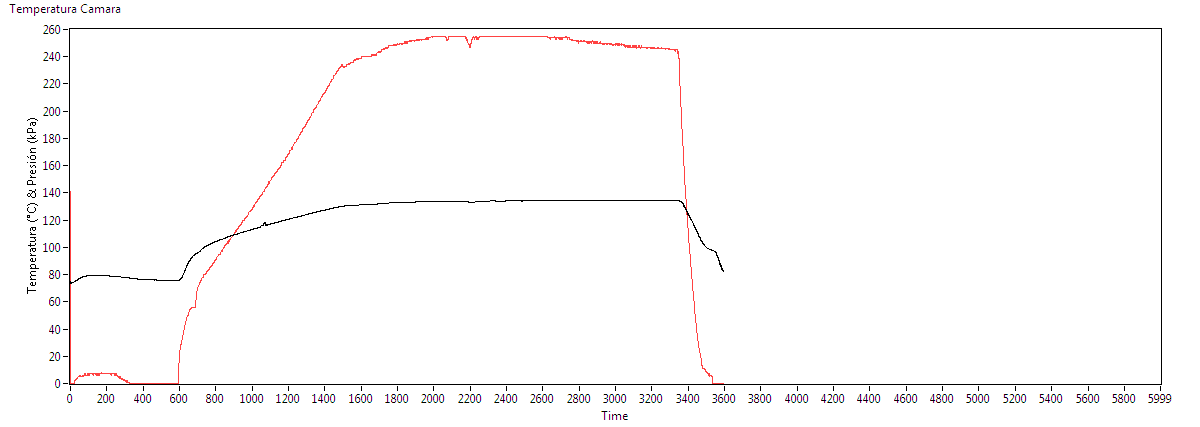
Autoclaves Vertical/Con Precamara/2017/Autoclave 85L/Autoclave Luker #004587664/Documentos/Pruebas Autoclave 85L/Auto85L_05.bmp
