judapies/Autoclave/Autoclaves Vertical/Sin Precamara/2014/Autoclave 40L/NULAB/Autoclave Nulab/Pruebaconcarga.bmp

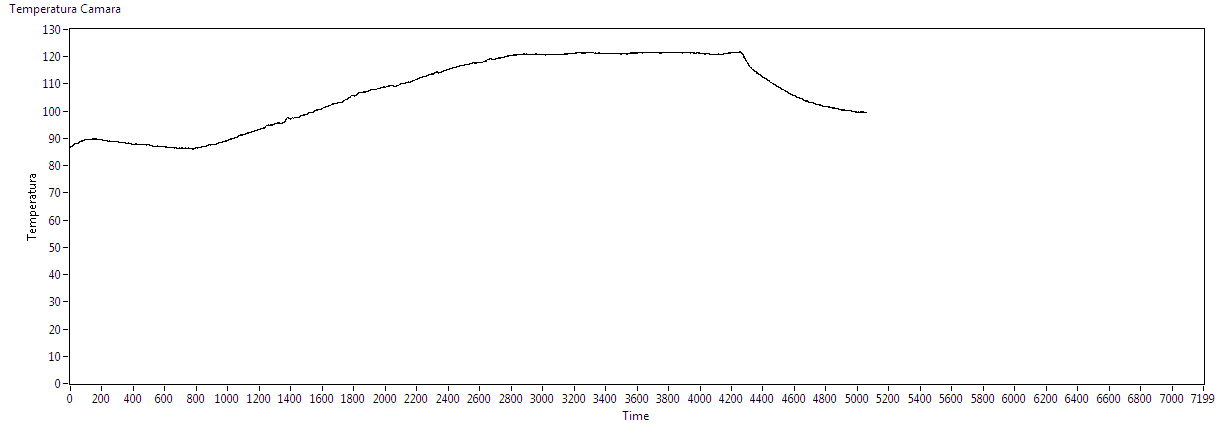
Autoclaves Vertical/Sin Precamara/2014/Autoclave 40L/NULAB/Autoclave Nulab/Pruebaconcarga.bmp
