judapies/Autoclave/Autoclaves Vertical/Sin Precamara/2014/Autoclave 40L/NULAB/Autoclave Nulab/pruebavacio2803.bmp

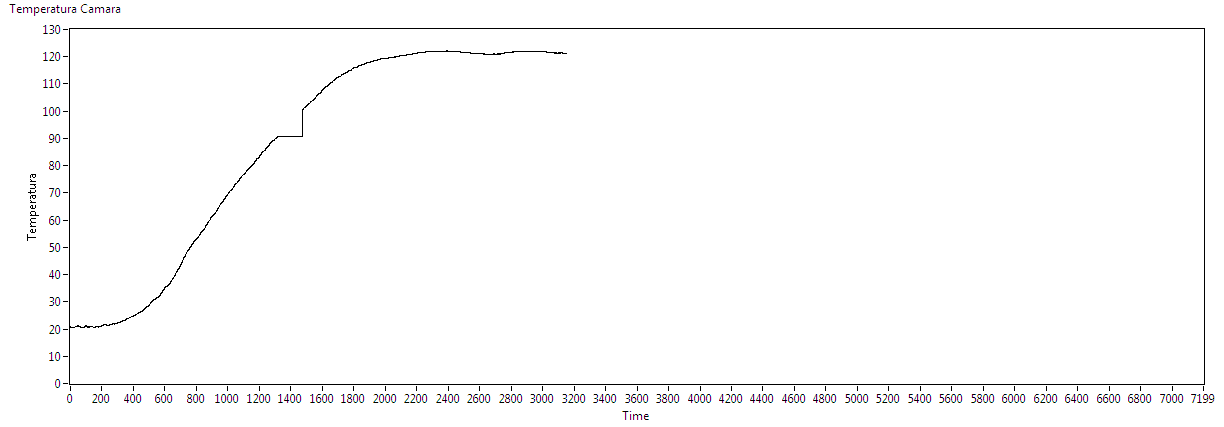
Autoclaves Vertical/Sin Precamara/2014/Autoclave 40L/NULAB/Autoclave Nulab/pruebavacio2803.bmp
