judapies/Autoclave/Autoclaves Vertical/Sin Precamara/2014/Autoclave 40L/NULAB/pruebavacio2.bmp

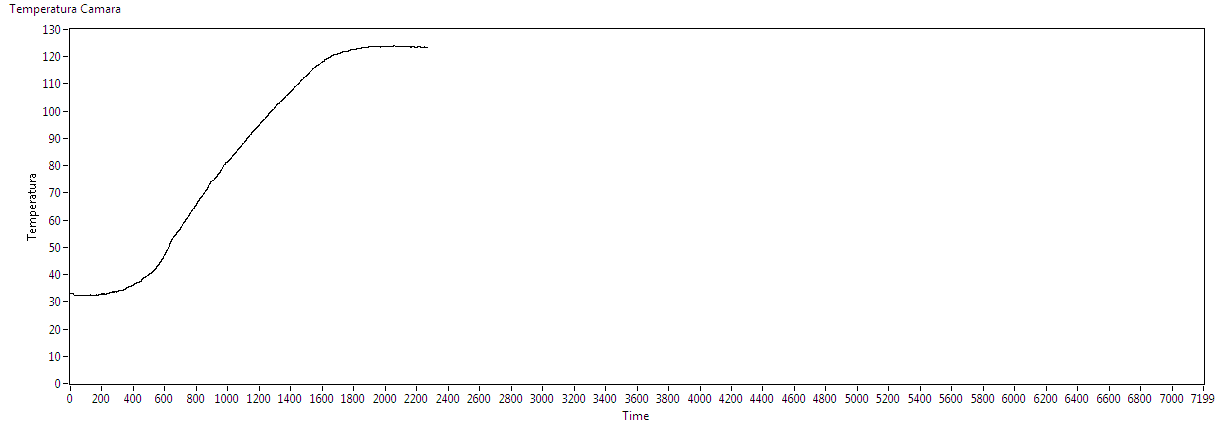
Autoclaves Vertical/Sin Precamara/2014/Autoclave 40L/NULAB/pruebavacio2.bmp
