judapies/Autoclave/Autoclaves Vertical/Sin Precamara/2015/Autoclave 27L/Autoclaves Universidad de Nariño/Prueba_Autoclave1_Pasto_01.bmp

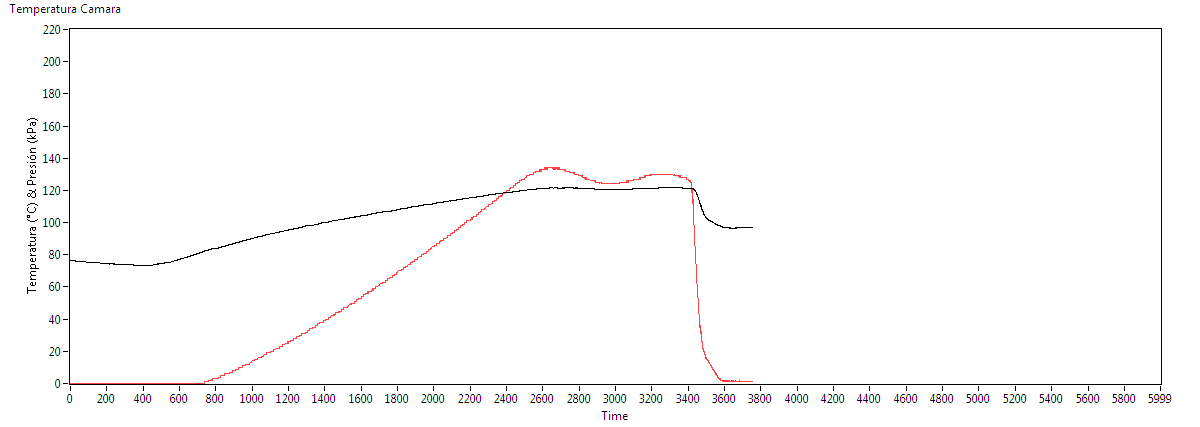
Autoclaves Vertical/Sin Precamara/2015/Autoclave 27L/Autoclaves Universidad de Nariño/Prueba_Autoclave1_Pasto_01.bmp
