judapies/Autoclave/Autoclaves Vertical/Sin Precamara/2015/Autoclave 27L/Autoclaves Universidad de Nariño/Pruebas Autoclaves Pasto/IMG_5637.JPG

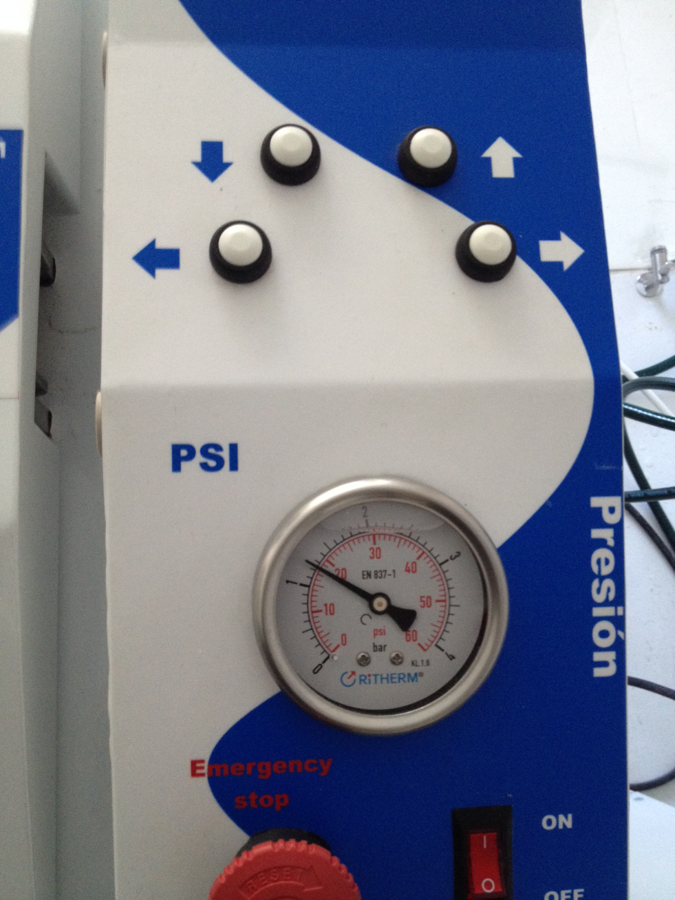
Autoclaves Vertical/Sin Precamara/2015/Autoclave 27L/Autoclaves Universidad de Nariño/Pruebas Autoclaves Pasto/IMG_5637.JPG
