judapies/Autoclave/Autoclaves Vertical/Sin Precamara/2016/Autoclave 62L/Autoclave 62L Instruelectronic/Documentos/Pruebas Autoclave 62L/Prueba02.bmp

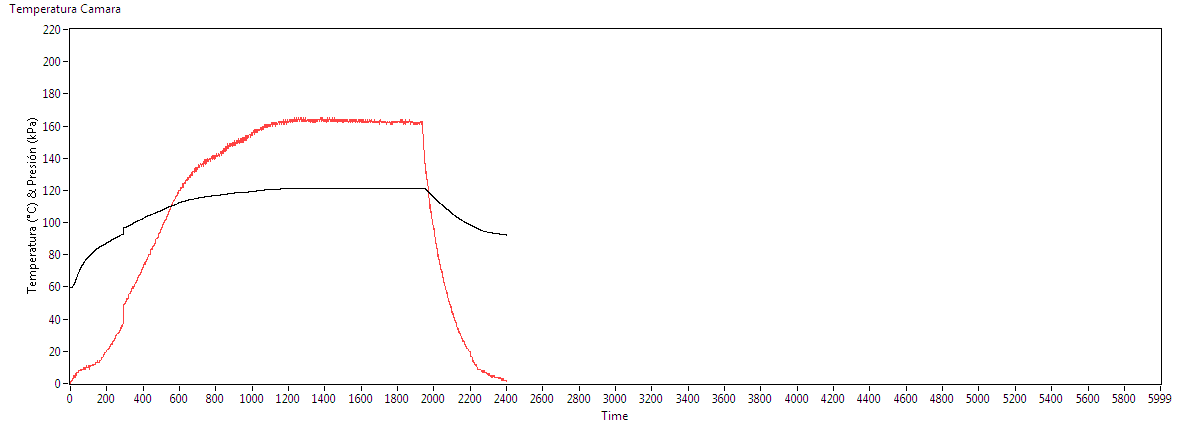
Autoclaves Vertical/Sin Precamara/2016/Autoclave 62L/Autoclave 62L Instruelectronic/Documentos/Pruebas Autoclave 62L/Prueba02.bmp
