judapies/Autoclave/Autoclaves Vertical/Sin Precamara/2017/Autoclave 62L/Autoclave 62L Labservice #004587645/Documentos/Pruebas Autoclave 62L/Prueba01.png

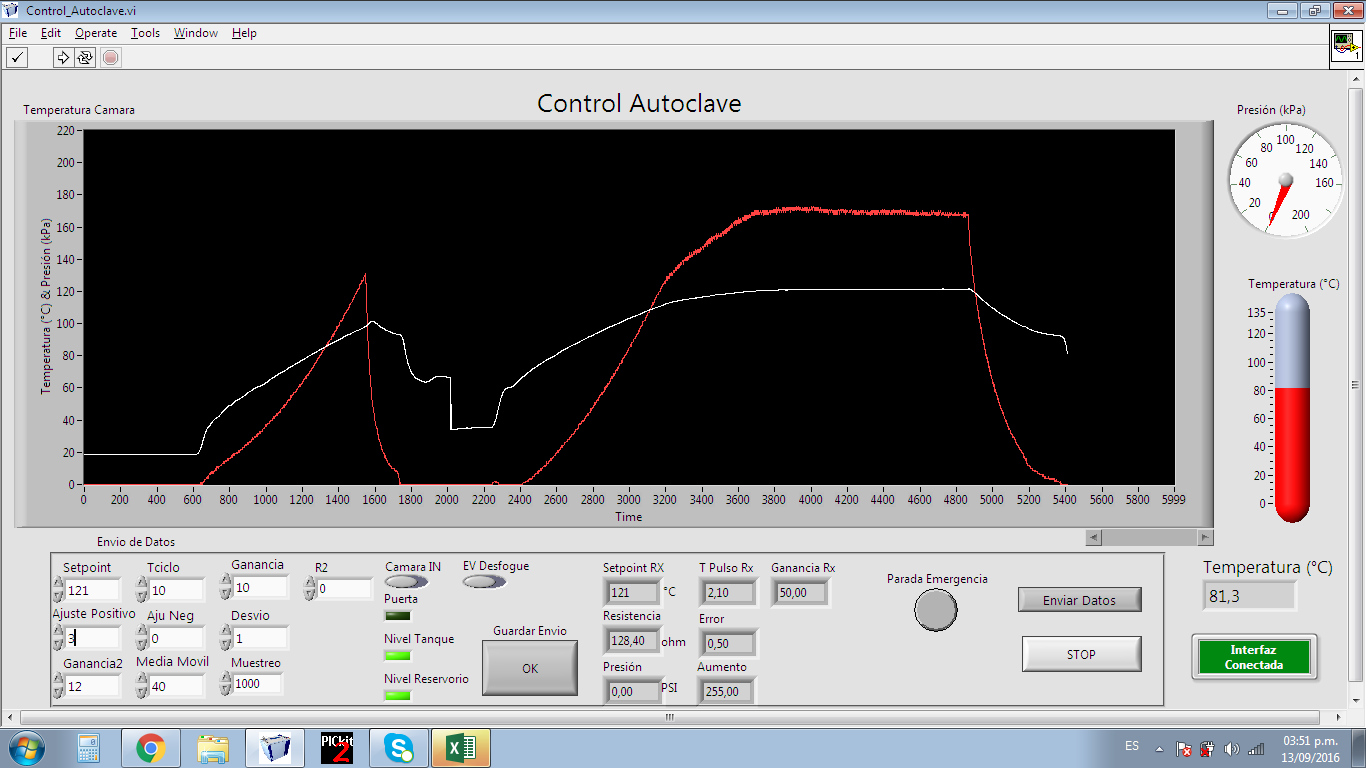
Autoclaves Vertical/Sin Precamara/2017/Autoclave 62L/Autoclave 62L Labservice #004587645/Documentos/Pruebas Autoclave 62L/Prueba01.png
