judapies/Autoclave/Autoclaves Vertical/Sin Precamara/2021/Autoclave 160L Artilab  OP202197 #004588628/Pruebas/110.PNG

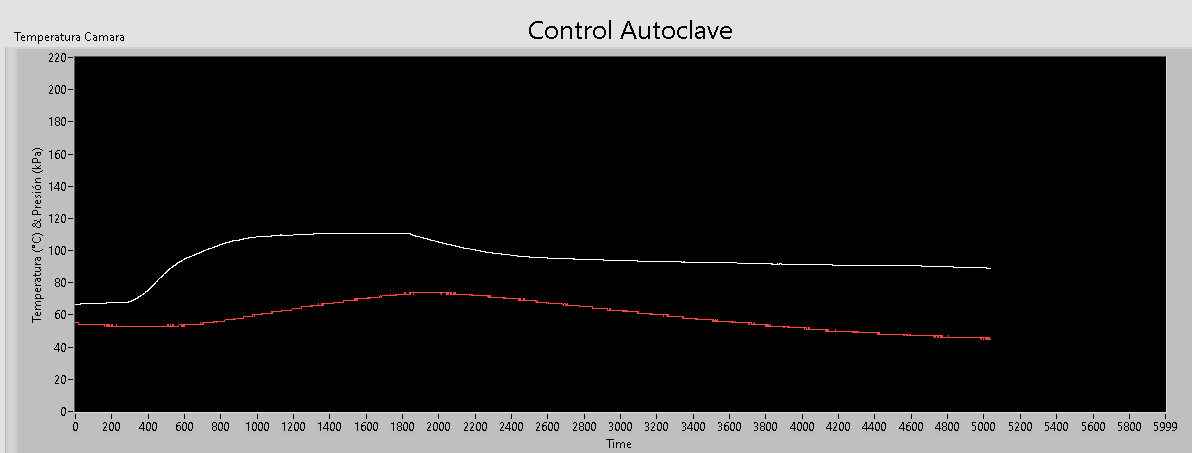
Autoclaves Vertical/Sin Precamara/2021/Autoclave 85L Artilab OP202135-136 #0045886XX-XX/Pruebas/110.PNG
