judapies/Autoclave/Autoclave Horizontal/Sin Precamara/2018/Autoclave 24L-V3.1 Reservorio Avantika #004587859/ENSAMBLE GENERAL ACH-23L-2018.PDF

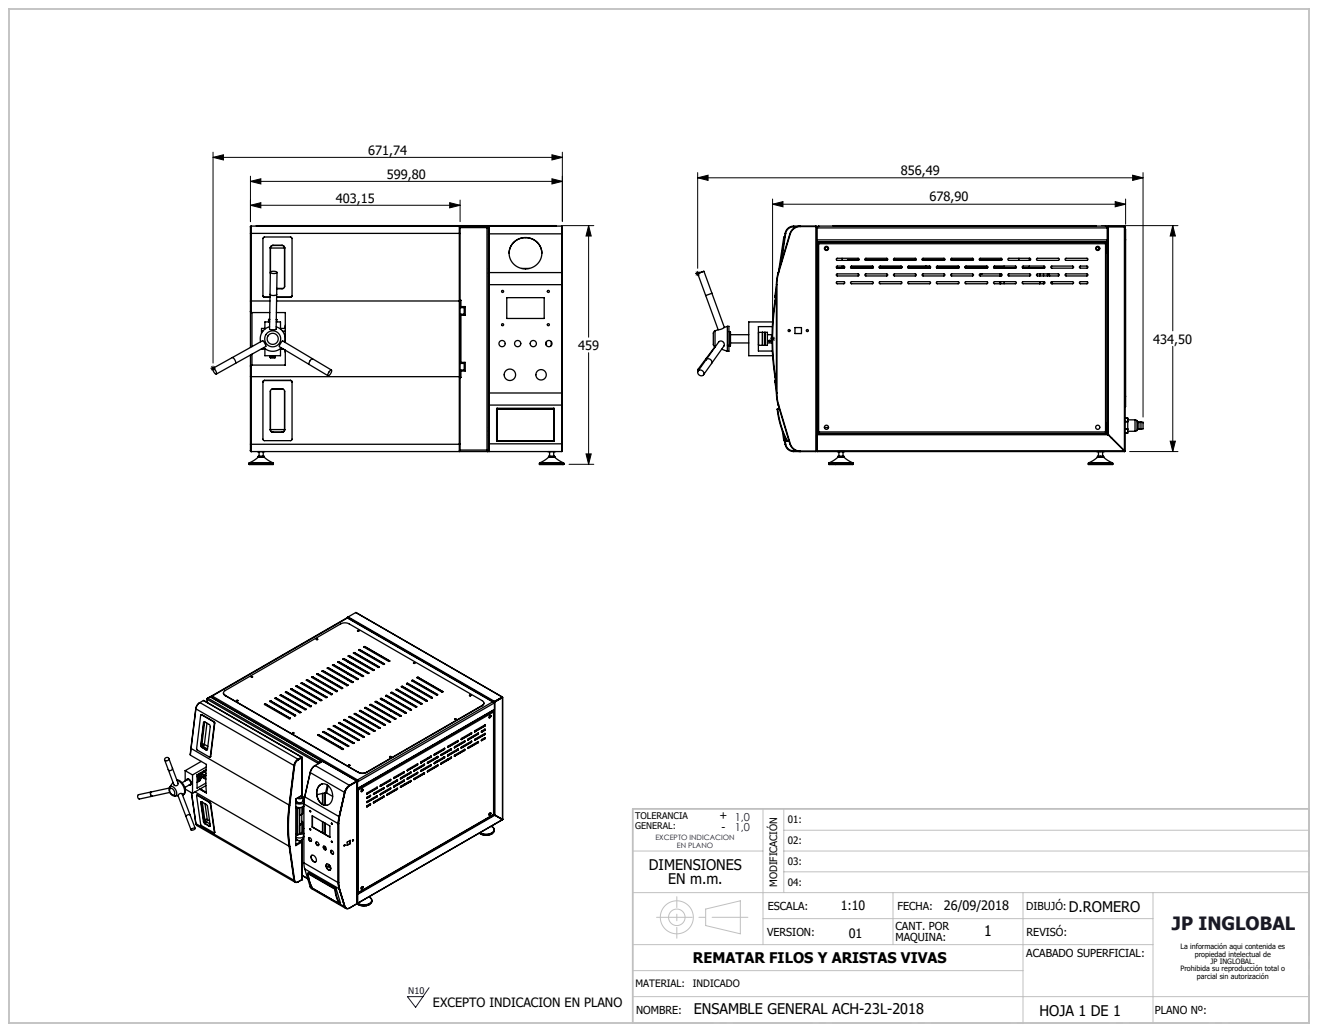
[picture p238: page 1]
JP INGLOBAL; EXCEPTO INDICACION EN PLANO; ACABADO SUPERFICIAL:; TOLERANCIA; + GENERAL:; HOJA 1 DE 1; PLANO Nº:; CANT. POR

REMATAR FILOS Y ARISTAS VIVAS

La información aqui contenida es
propiedad intelectual de
JP INGLOBAL.
Prohibida su reproducción total o
parcial sin autorización

MATERIAL:
ENSAMBLE GENERAL ACH-23L-2018

EXCEPTO INDICACION EN PLANO
