judapies/Autoclave/Autoclave Horizontal/Con Precamara/2018/Autoclave 110L-V3.1 TIM #004587910/Conexiones electricas Autoclave 110L/Conexiones electricas y electronicas A110L.pdf

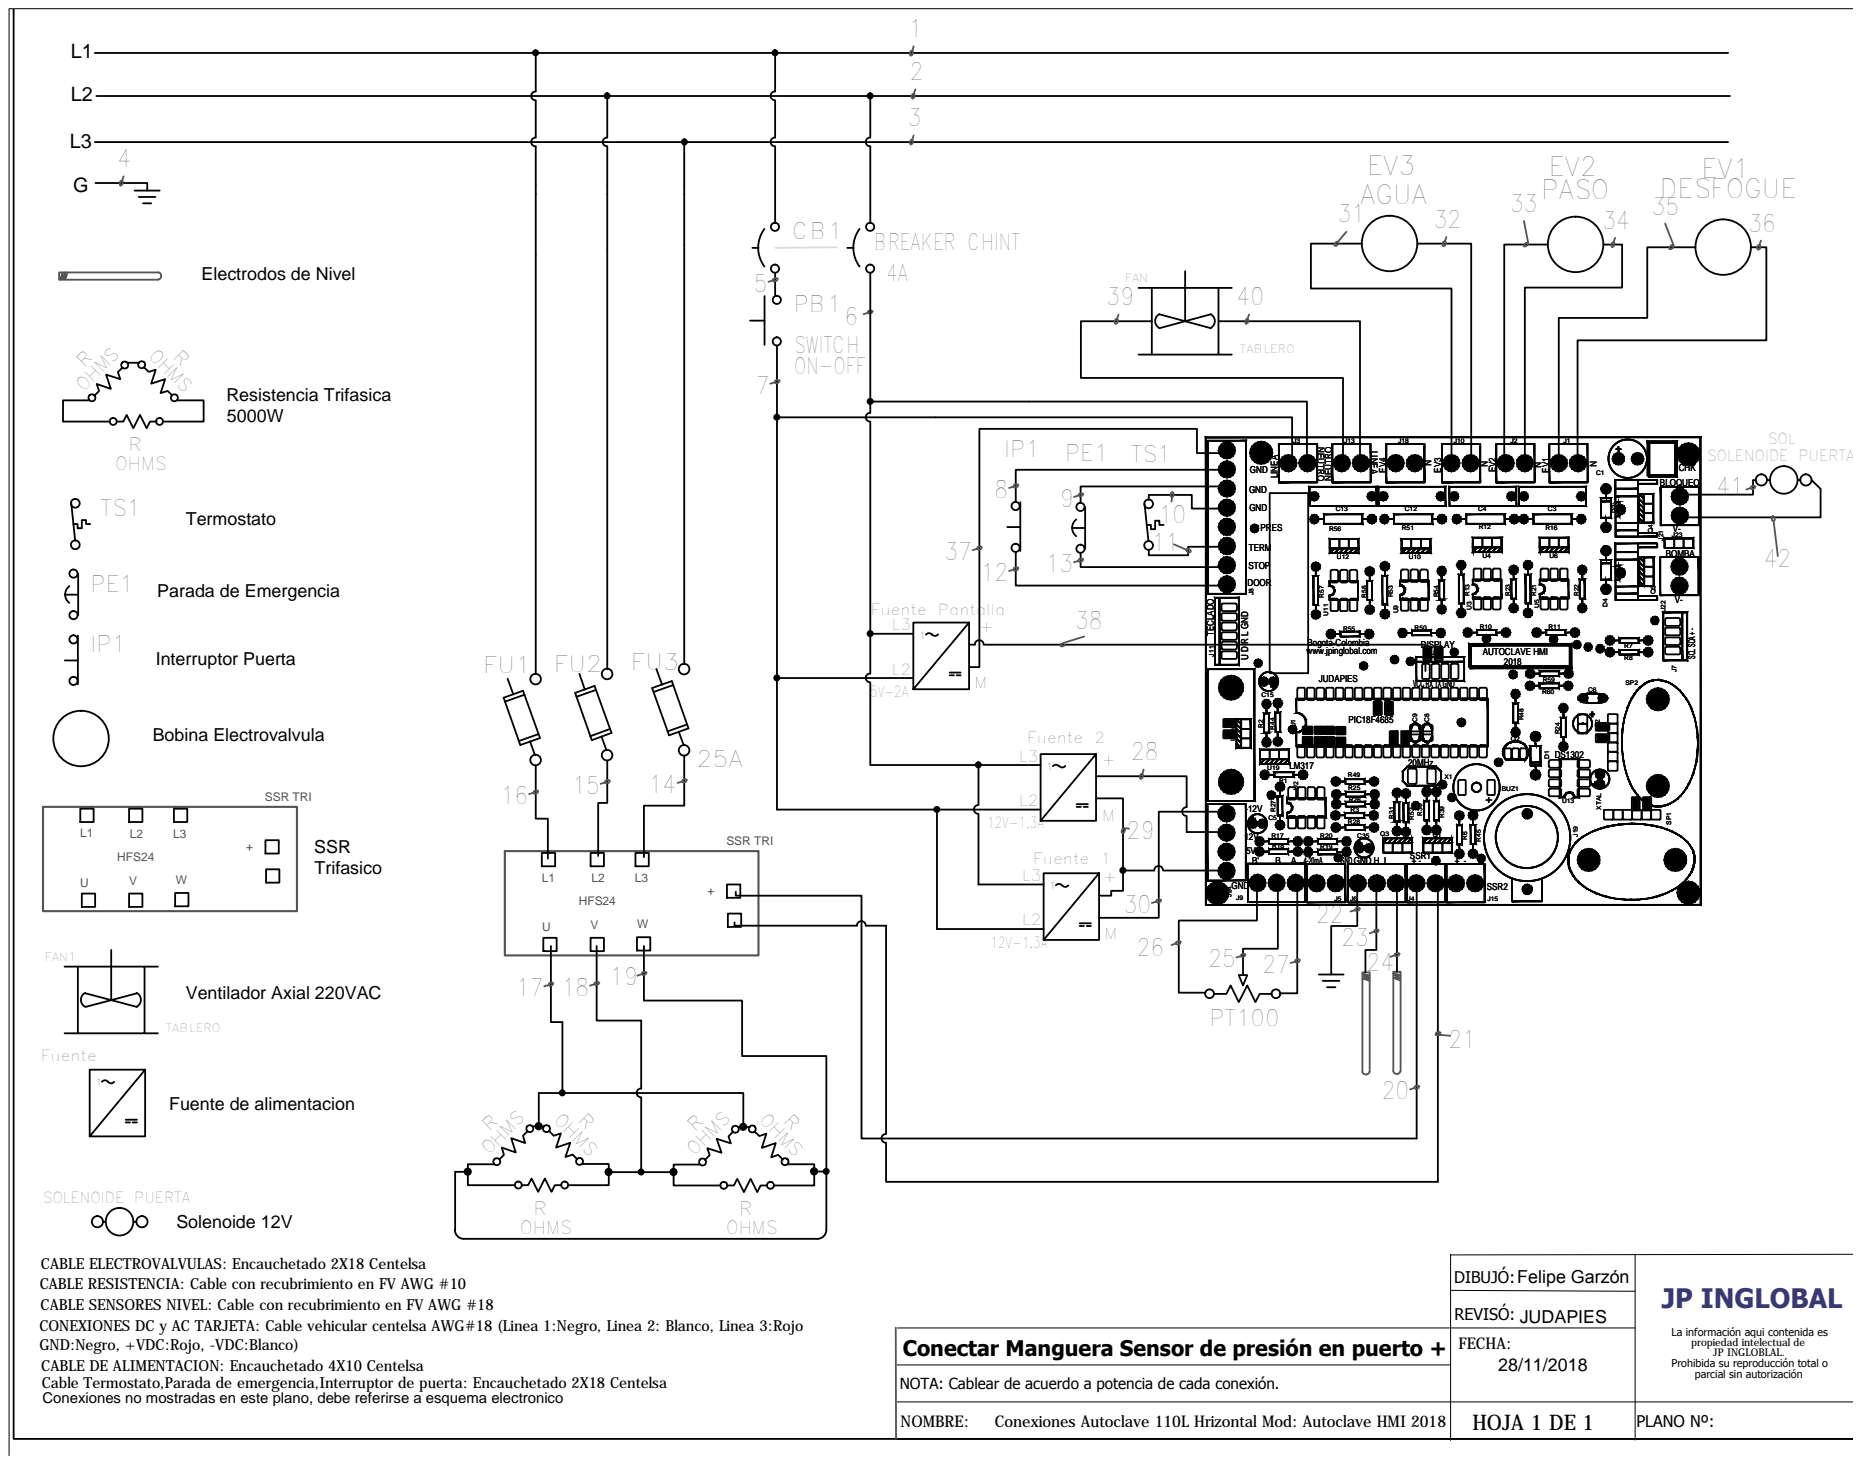
[picture p239: page 1]

EV1 DS1302 20MHz Bogota-Colombia www.jpinglobal.com JUDAPIESPIC18F4685 LM317 C1 AUTOCLAVE HMI 2018 CHK 1 Fuente 123 4 5 6 7 8 9 10 11 12 13 15 14 1617 18 19 20 21 2223 25 24 26 27 39 40 Fuente de alimentacion 31 32 33 34 35 36 )HOLSH*DU]yQ JUDAPIES CABLE DE ALIMENTACION: Encauchetado 4X10 Centelsa 28/11/2018 SOLENOIDE PUERTA SOL 41 42 SOLENOIDE PUERTASolenoide 12V 4A BREAKER CHINT CB1 1 L3L2 +M Fuente 1 12V-1.3A1 L3L2 +M Fuente 2 12V-1.3A 1 L3L2 +M Fuente Pantalla 5V-2A 28 2930 37 38 Cable Termostato,Parada de emergencia,Interruptor de puerta: Encauchetado 2X18 Centelsa

EV1 DS1302 20MHz Bogota-Colombia www.jpinglobal.com JUDAPIESPIC18F4685 LM317 C1 AUTOCLAVE HMI 2018 CHK

J11 DOOR STOP TERMPRES GND GND GND

SCL SDA + - V- BOMBA V- BLOQUEO DISPLAY VCC RX TX GND

TECLADO 5V12V -12V GND B' B A 4-20mA GND GND H L SSR1 + - + - SSR2

&RQHFWDU0DQJXHUD6HQVRUGHSUHVLyQHQSXHUWR
