judapies/Autoclave/Autoclave Horizontal/Sin Precamara/2016/Autoclave 23L Microlab/Plano Electrico Autoclave Horizontal/ConexionesElectricasYElectronicas.pdf

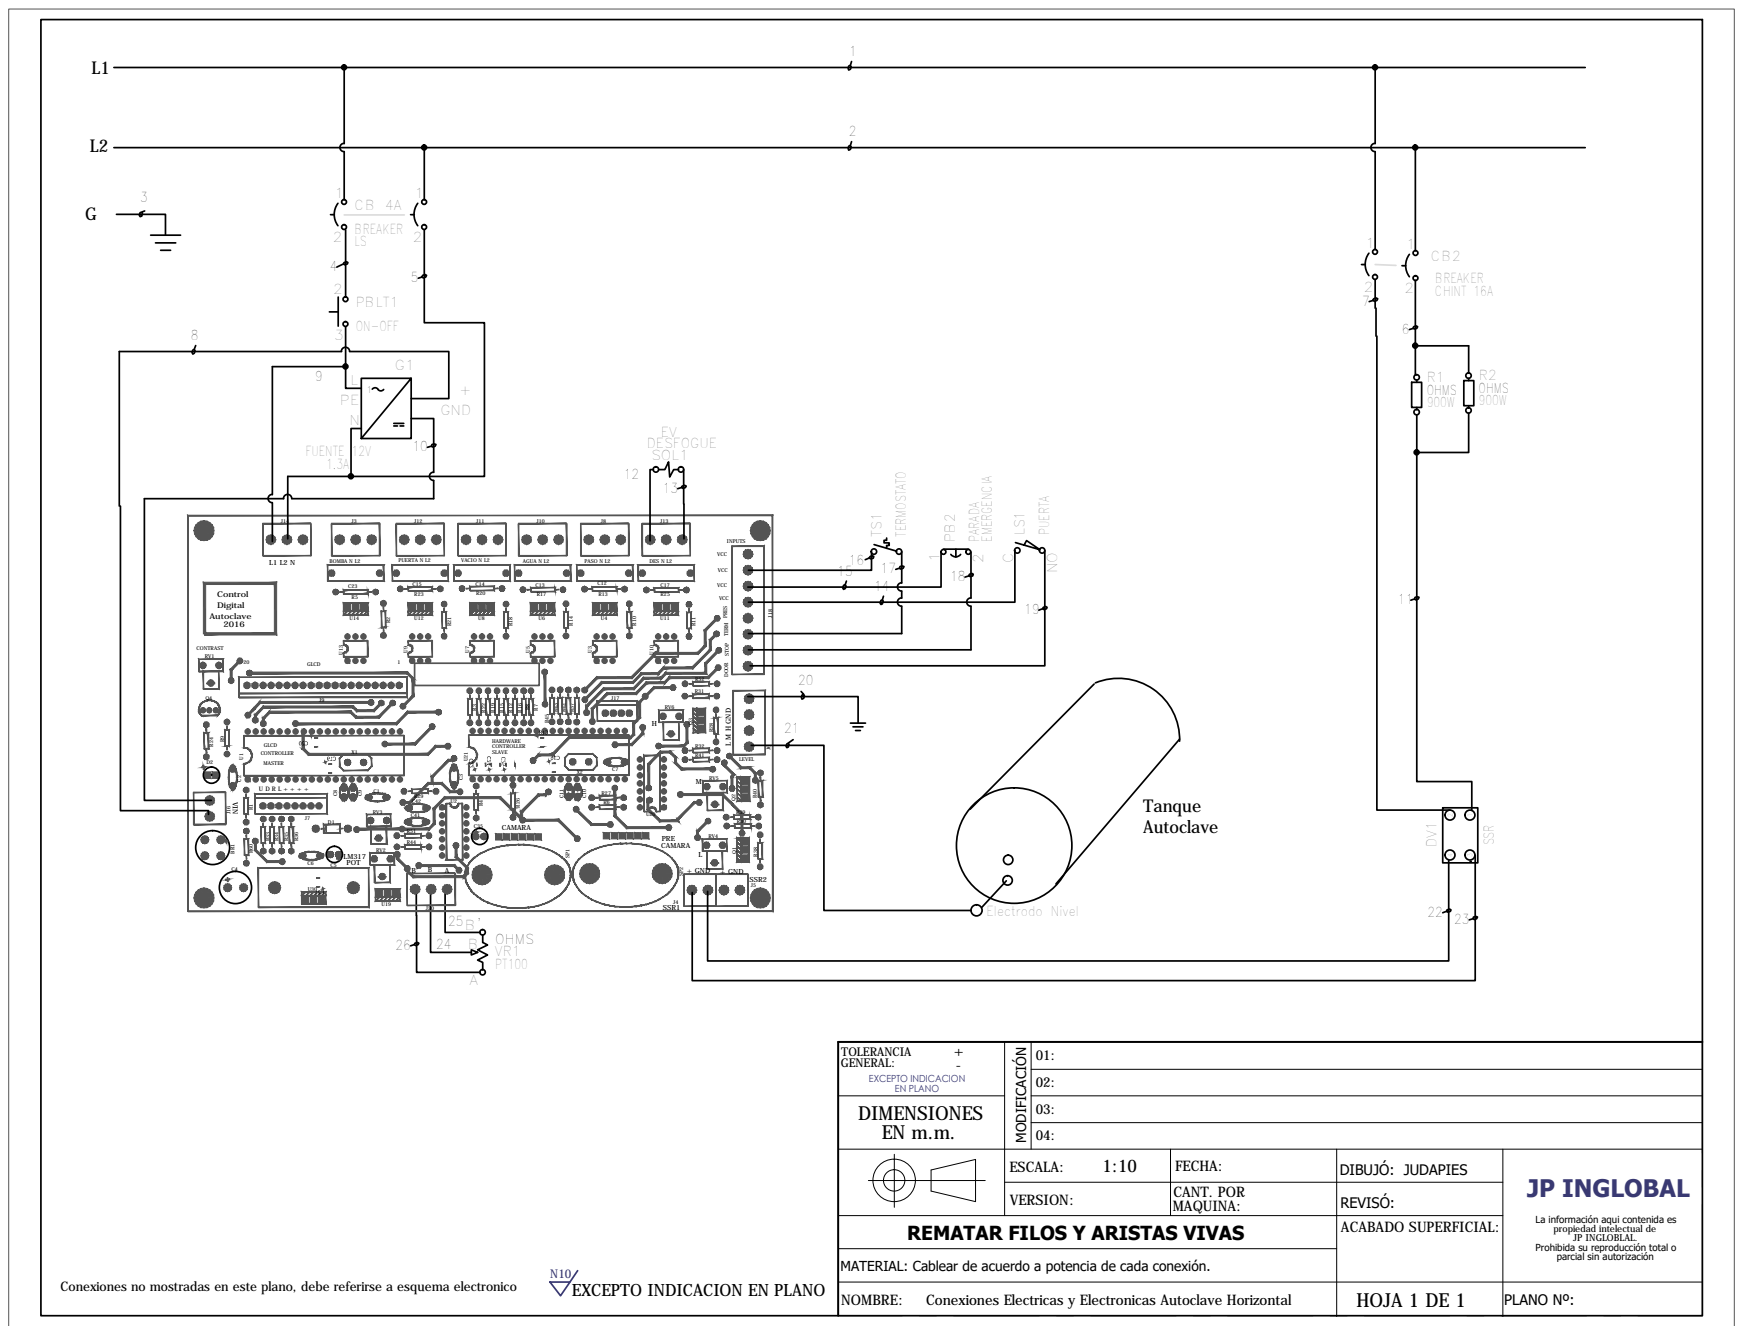
[picture p240: page 1]

TERMOSTATO L1L2 Conexiones no mostradas en este plano, debe referirse a esquema electronico 12

R45 1 L PEN + GND G1 1.3A FUENTE 12V 5 6 7 8 9 10 11 13 12 14 15 17 18 19 22 25 23 26 24 Tanque Autoclave Electrodo Nivel OHMS 900W R2 G 3 4 16 20 21 CHINT 16A BREAKER CB2 21 21

02',),&$&,Ï1 NOMBRE: Conexiones Electricas y Electronicas Autoclave Horizontal CANT. POR MAQUINA: 01: LSBREAKER CB 4A 21 21 32 ON-OFF PBLT1 SOL1 DESFOGUE EV 3 SSR 21 4 DV1 OHMS 900W R1 B PT100 OHMS AB' VR1 12 PB2 PARADA EMERGENCIA

DOOR STOP TERM PRES VCC VCC VCC VCC U D R L + + + + CONTRAST L1 L2 N BOMBA N L2 PUERTA N L2 VACIO N L2 AGUA N L2 PASO N L2 DES N L2 20 GLCD 1 HARDWARE GLCD CONTROLLER MASTER CONTROLLER SLAVE LEVEL INPUTS

VIN B' B A LM317 POT CAMARA PRE CAMARA+ GND + GND LM H SSR1 SSR2
