judapies/Autoclave/Autoclave Horizontal/Sin Precamara/2016/Autoclave 40L SENA/Plano Electrico Autoclave Horizontal/ConexionesElectricasYElectronicas.pdf

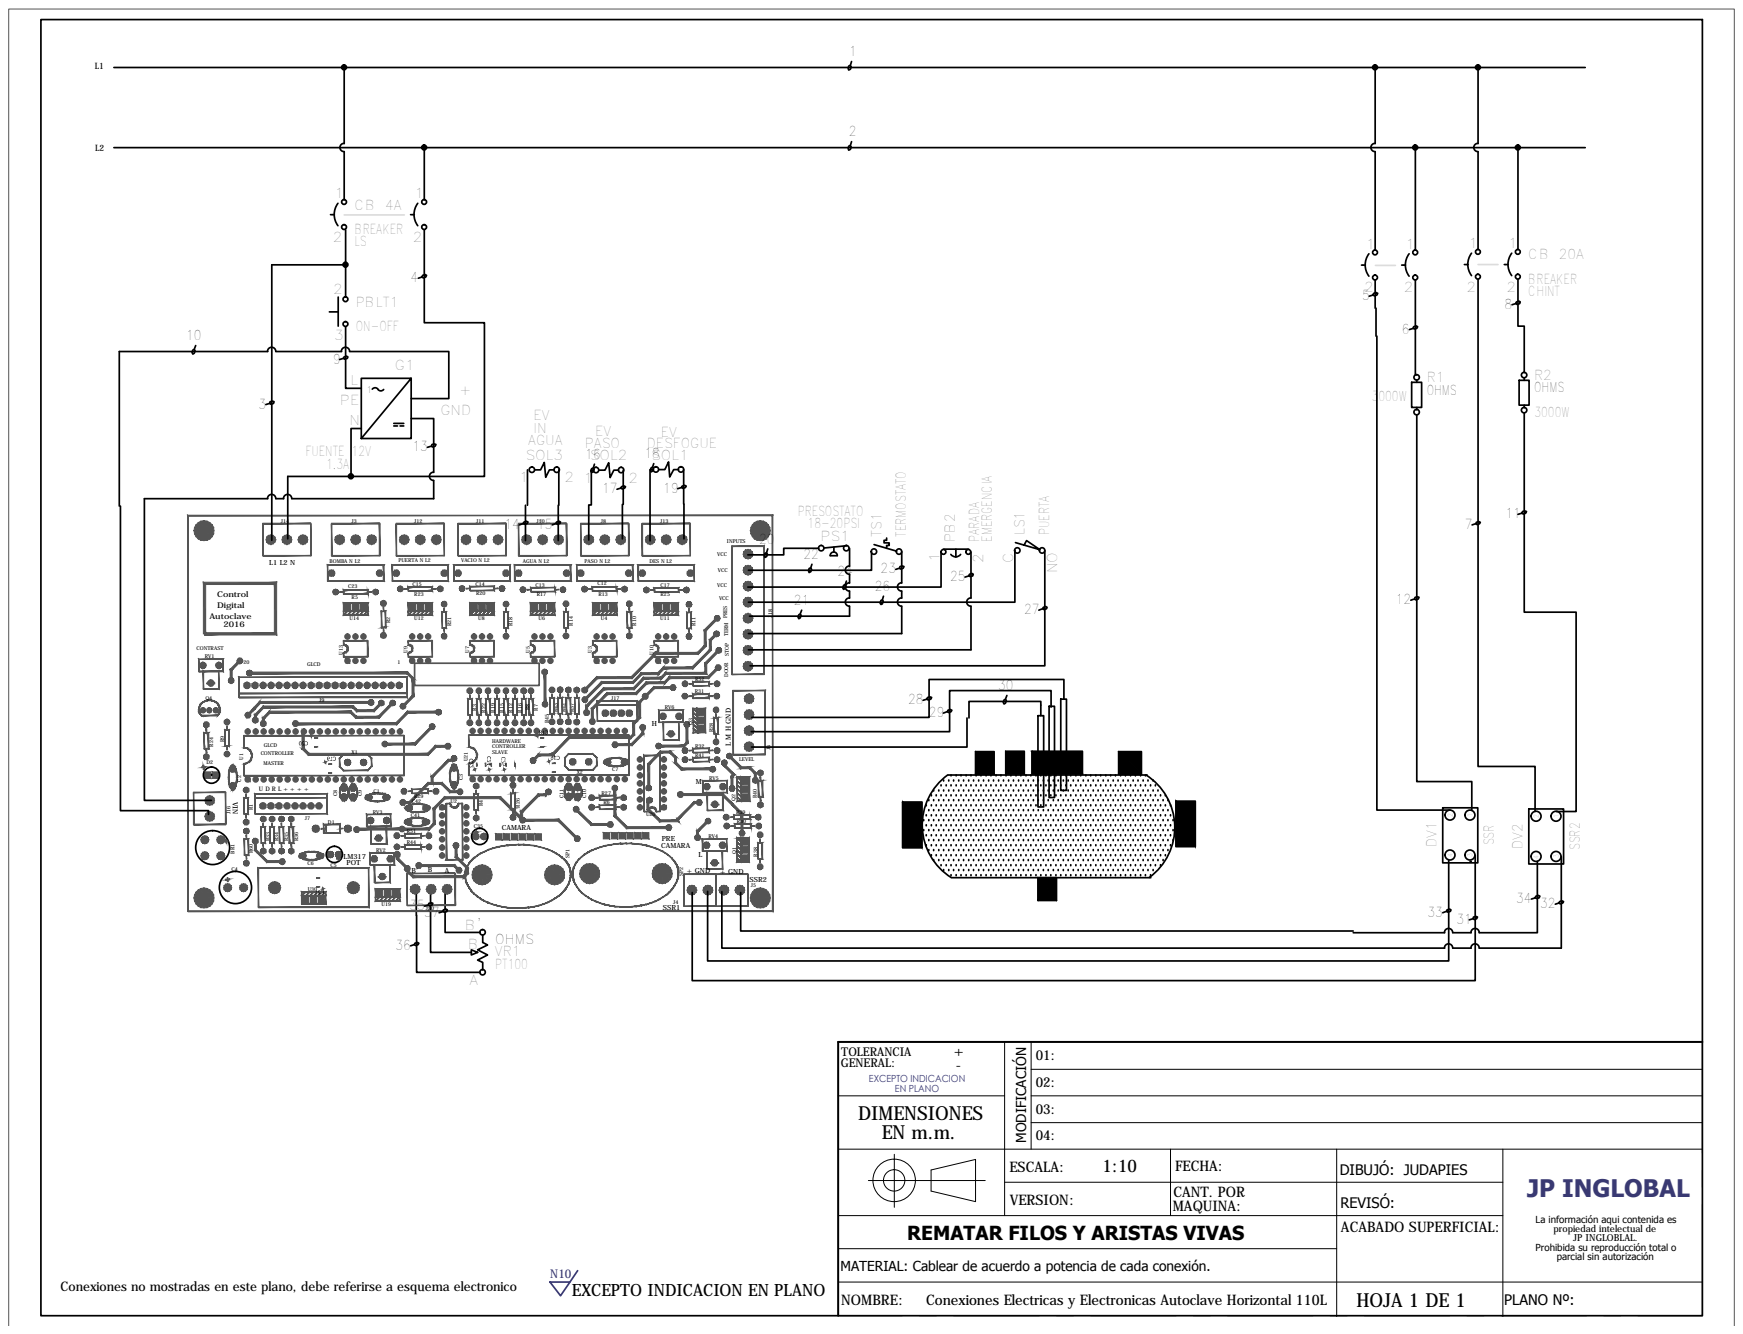
[picture p241: page 1]

TERMOSTATO L1L2 Conexiones no mostradas en este plano, debe referirse a esquema electronico 12

02',),&$&,Ï1 NOMBRE: Conexiones Electricas y Electronicas Autoclave Horizontal 110L CANT. POR MAQUINA: 01: LSBREAKER CB 4A 21 21 32 ON-OFF PBLT1 SOL1 DESFOGUE EV 1 2 SOL2 PASO EV AGUA 1 2 SOL3 INEV 3 SSR 21 4 DV1 CHINT BREAKER CB 20A 21 21 OHMS 3000W R1 OHMS 3000W R2 B PT100 OHMS AB' VR1 12 PB2 PARADA EMERGENCIA

R45 1 L PEN + GND G1 1.3A FUENTE 12V 18-20PSI PRESOSTATO PS1 3 SSR2 21 4 DV2 21 21 3 4 6 5 7 8 10 9 13 12 11 14 15 1617 19 18 22 26 20 24 21 23 25 27 29 28 30 33 31 32 34 37 35 36

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

VIN B' B A LM317 POT CAMARA PRE CAMARA+ GND + GND LM H SSR1 SSR2
