judapies/Autoclave/Autoclave Horizontal/Con Precamara/2021/Autoclave 250L Avantika  OP2020414 #004588570/ENSAMBLE GENERAL ACH-250L-2021.PDF

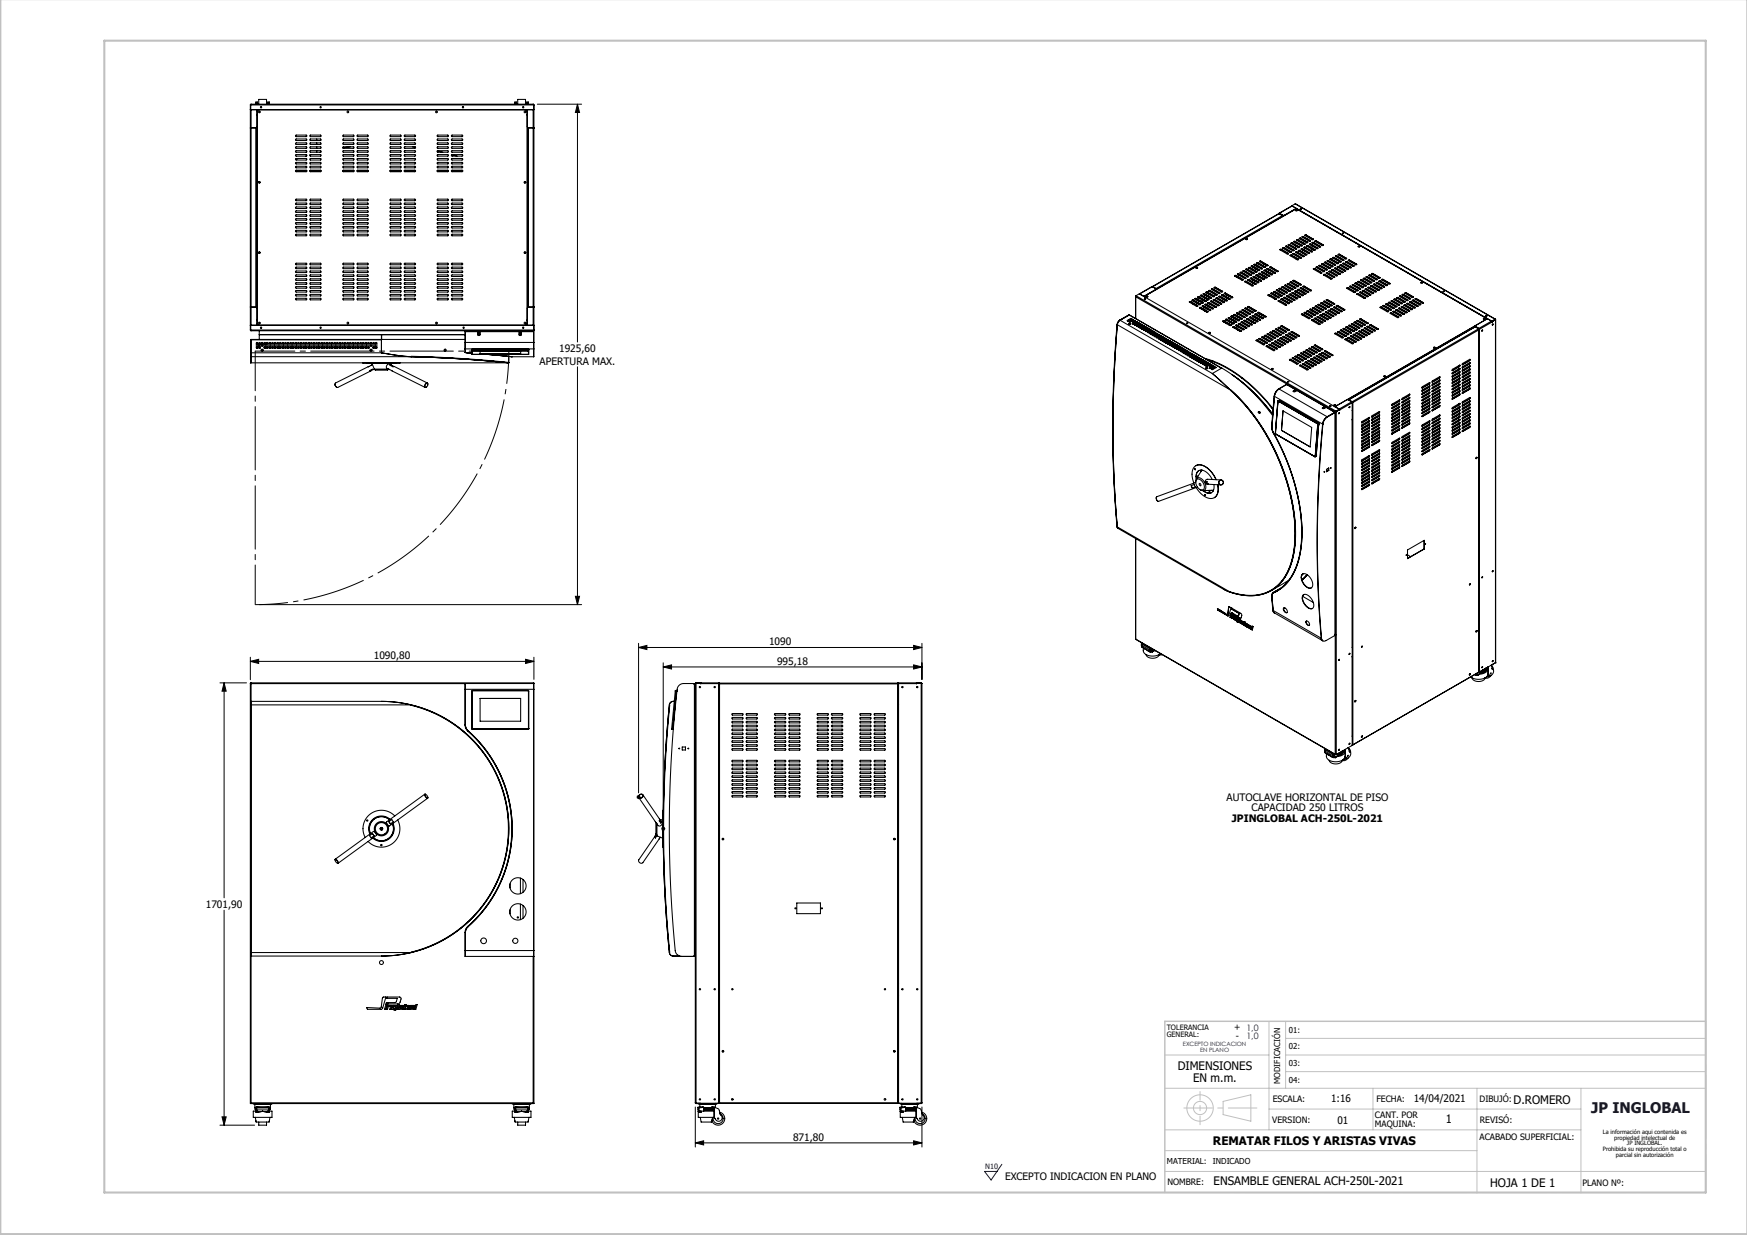
[picture p242: page 1]
APERTURA MAX.; JP INGLOBAL; EXCEPTO INDICACION EN PLANO; ACABADO SUPERFICIAL:; TOLERANCIA; + GENERAL:; HOJA 1 DE 1; PLANO Nº:; CANT. POR

AUTOCLAVE HORIZONTAL DE PISO
CAPACIDAD 250 LITROS
JPINGLOBAL ACH-250L-2021

REMATAR FILOS Y ARISTAS VIVAS

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

INDICADO
ENSAMBLE GENERAL ACH-250L-2021

EXCEPTO INDICACION EN PLANO
