judapies/Autoclave/Autoclave Horizontal/Con Precamara/2021/Autoclave 85L Avantika  OP2020415 #004588571/ENSAMBLE GENERAL ACH-85L-2020-P JP2020-415.PDF

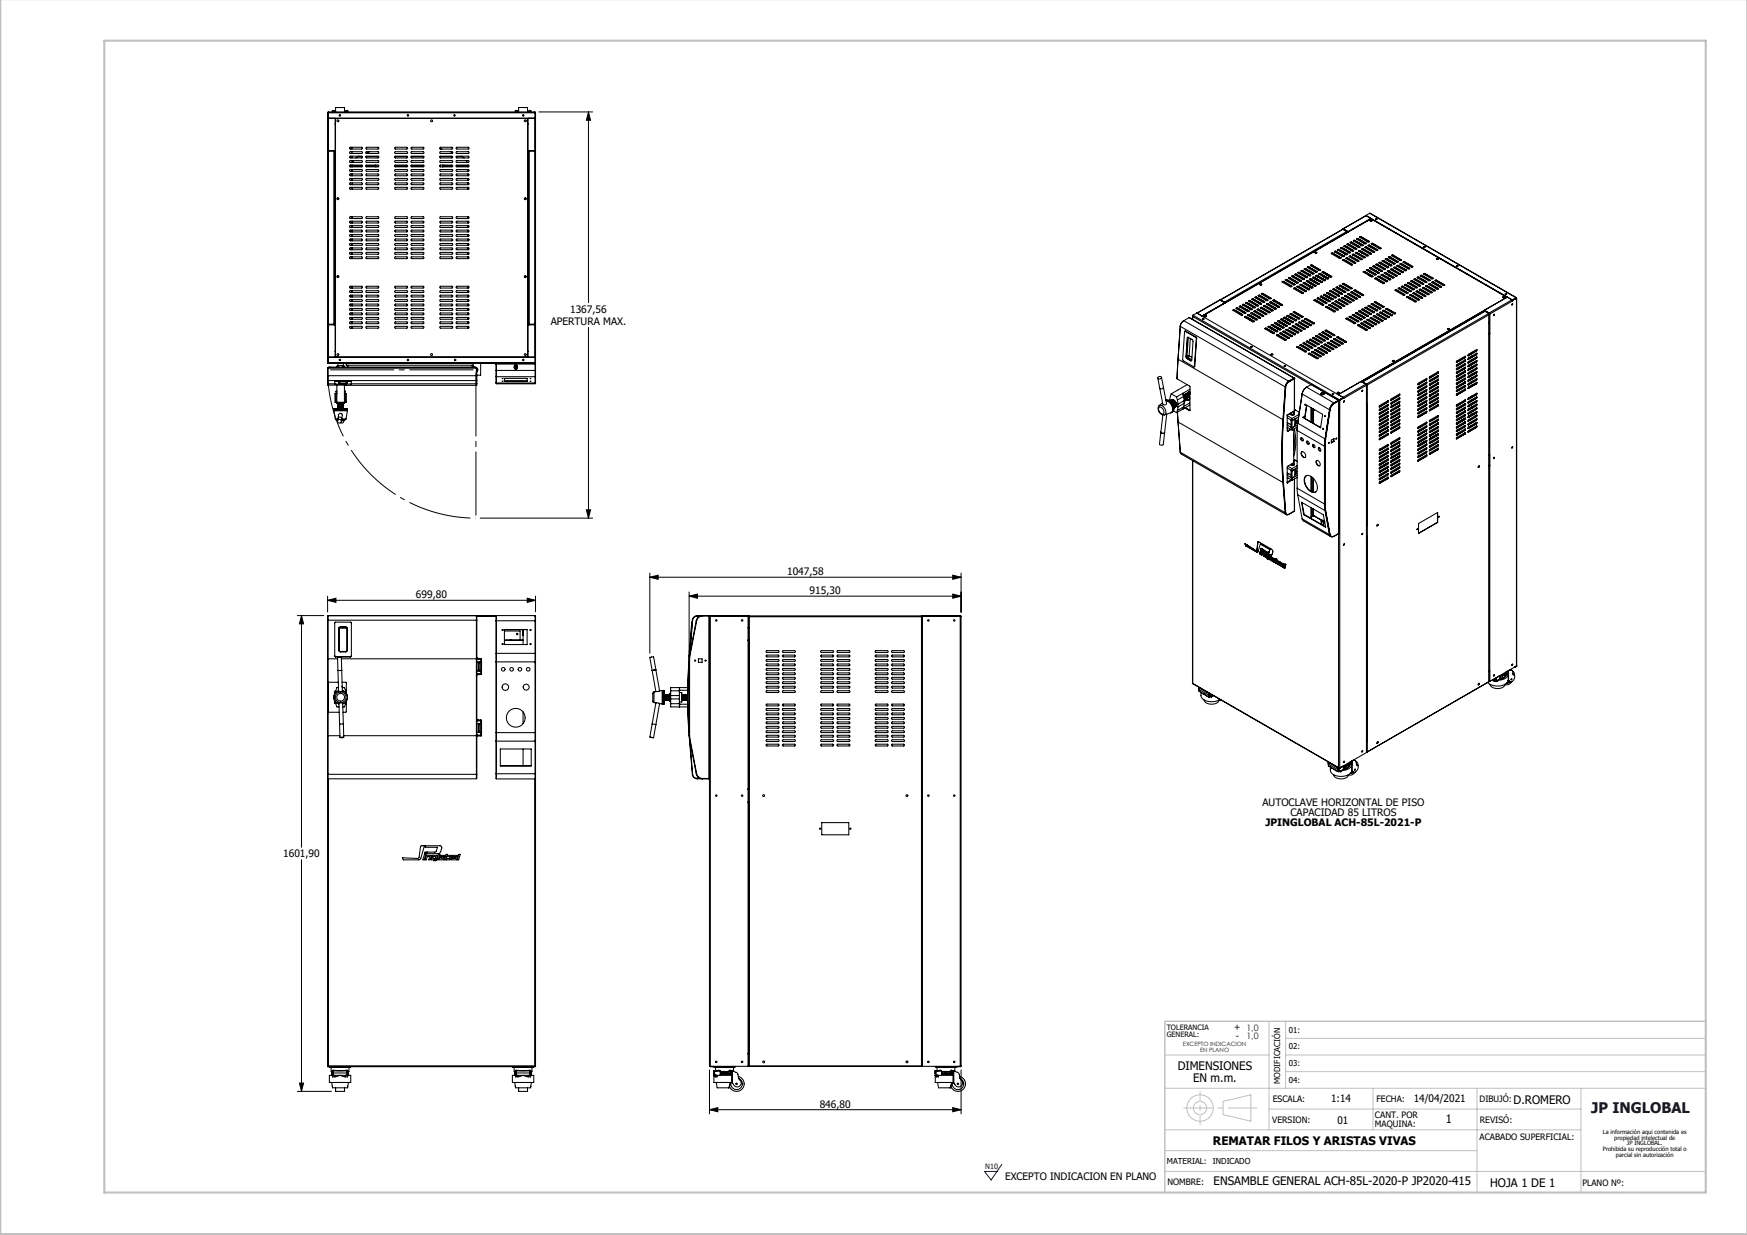
[picture p243: page 1]
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

AUTOCLAVE HORIZONTAL DE PISO
CAPACIDAD 85 LITROS
JPINGLOBAL ACH-85L-2021-P

REMATAR FILOS Y ARISTAS VIVAS

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

INDICADO
ENSAMBLE GENERAL ACH-85L-2020-P JP2020-415

EXCEPTO INDICACION EN PLANO
