judapies/Autoclave/Autoclave Horizontal/Con Precamara/2018/Autoclave 110L-V3.1 TIM #004587910/Schematic/AutoclaveV5.0.PDF

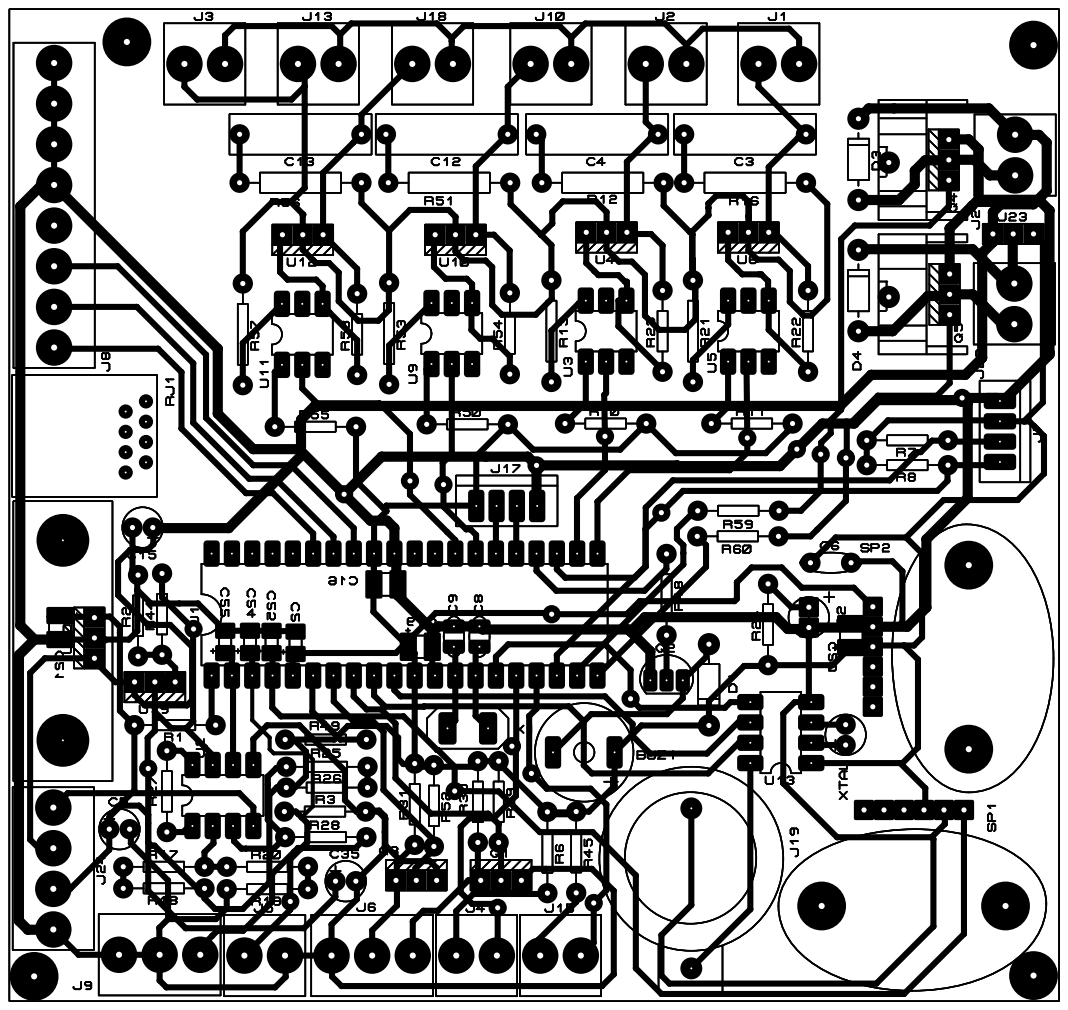
[picture p244: page 1]
