judapies/Autoclave/Autoclave Horizontal/Con Precamara/2019/Autoclave 250L Doble Puerta UCC#004588085/Documentos/ENSAMBLE ESQUEMA ACH-250L-PD-2019V2.PDF

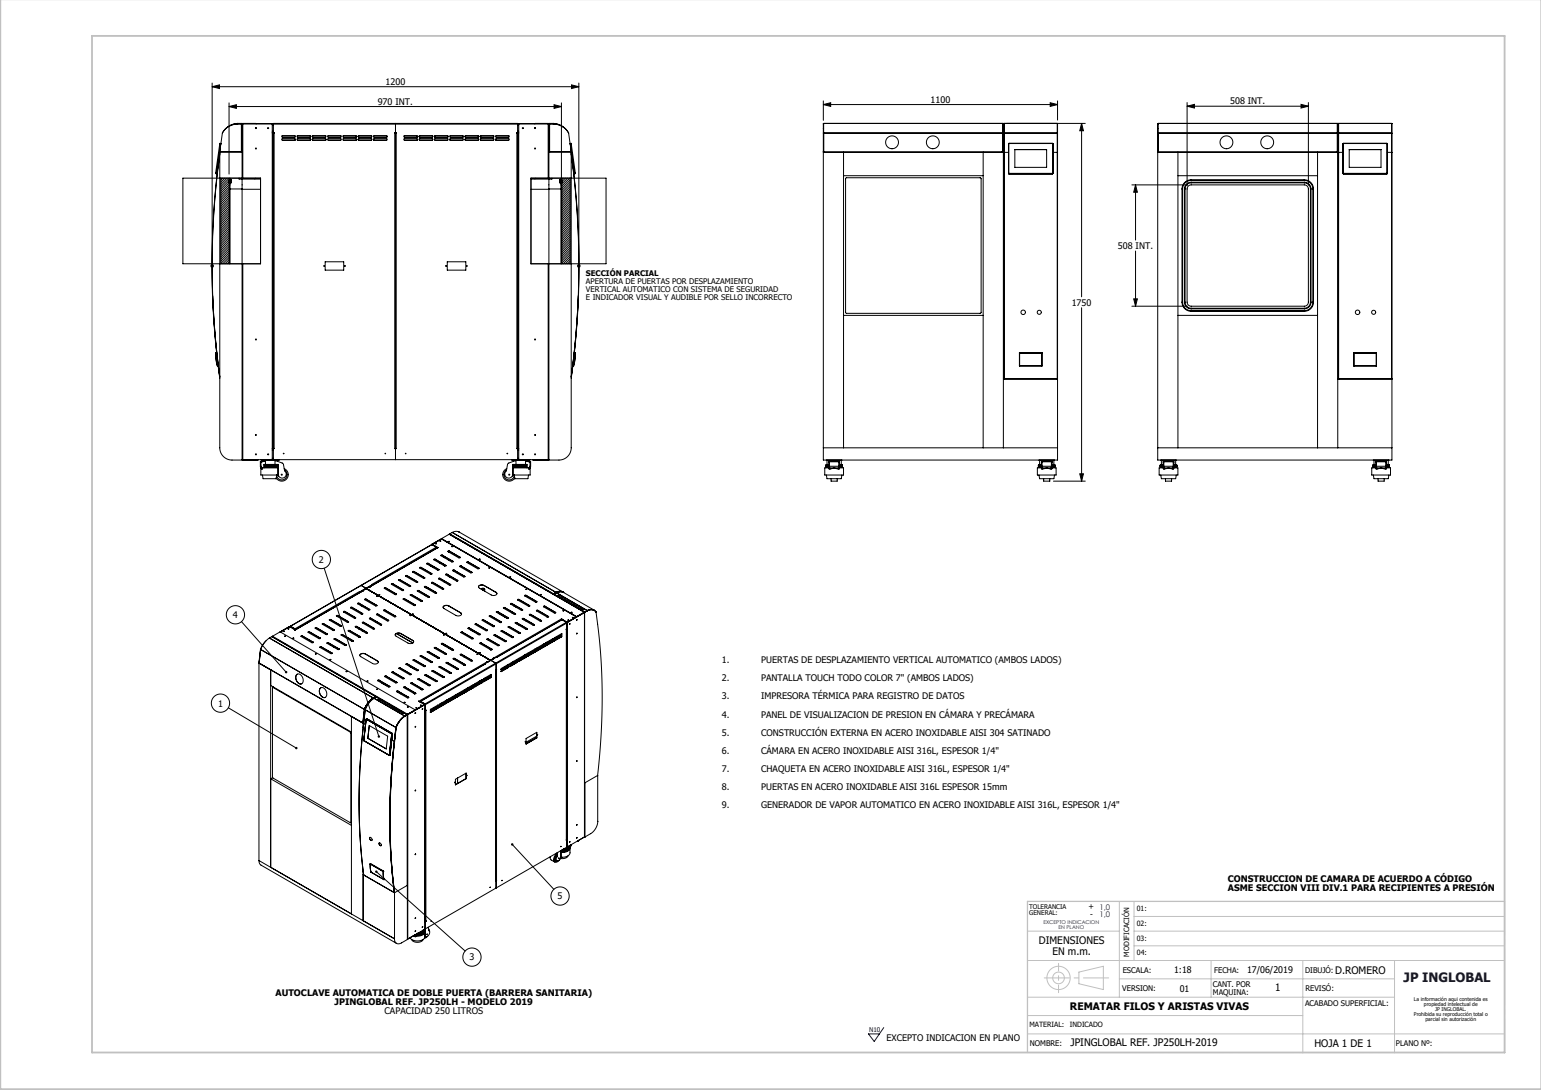
[picture p245: page 1]
970 INT.; CAPACIDAD 250 LITROS; 508 INT.; JP INGLOBAL; EXCEPTO INDICACION EN PLANO; ACABADO SUPERFICIAL:; TOLERANCIA; + GENERAL:; JPINGLOBAL REF. JP250LH-2019; HOJA 1 DE 1; PLANO Nº:; CANT. POR

SECCIÓN PARCIAL
APERTURA DE PUERTAS POR DESPLAZAMIENTO
VERTICAL AUTOMATICO CON SISTEMA DE SEGURIDAD
E INDICADOR VISUAL Y AUDIBLE POR SELLO INCORRECTO

1. PUERTAS DE DESPLAZAMIENTO VERTICAL AUTOMATICO (AMBOS LADOS)
2. PANTALLA TOUCH TODO COLOR 7" (AMBOS LADOS)
3. IMPRESORA TÉRMICA PARA REGISTRO DE DATOS
4. PANEL DE VISUALIZACION DE PRESION EN CÁMARA Y PRECÁMARA
5. CONSTRUCCIÓN EXTERNA EN ACERO INOXIDABLE AISI 304 SATINADO
6. CÁMARA EN ACERO INOXIDABLE AISI 316L, ESPESOR 1/4"
7. CHAQUETA EN ACERO INOXIDABLE AISI 316L, ESPESOR 1/4"
8. PUERTAS EN ACERO INOXIDABLE AISI 316L ESPESOR 15mm
9. GENERADOR DE VAPOR AUTOMATICO EN ACERO INOXIDABLE AISI 316L, ESPESOR 1/4"

CONSTRUCCION DE CAMARA DE ACUERDO A CÓDIGO ASME SECCION VIII DIV.1 PARA RECIPIENTES A PRESIÓN

AUTOCLAVE AUTOMATICA DE DOBLE PUERTA (BARRERA SANITARIA)

JPINGLOBAL REF. JP250LH - MODELO 2019

REMATAR FILOS Y ARISTAS VIVAS

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

EXCEPTO INDICACION EN PLANO
