judapies/Autoclave/Autoclave Horizontal/Con Precamara/2019/Autoclave 680L-V3.1 VM #004587960/Documentos/ENSAMBLE GENERAL ACH- 600L-2019.PDF

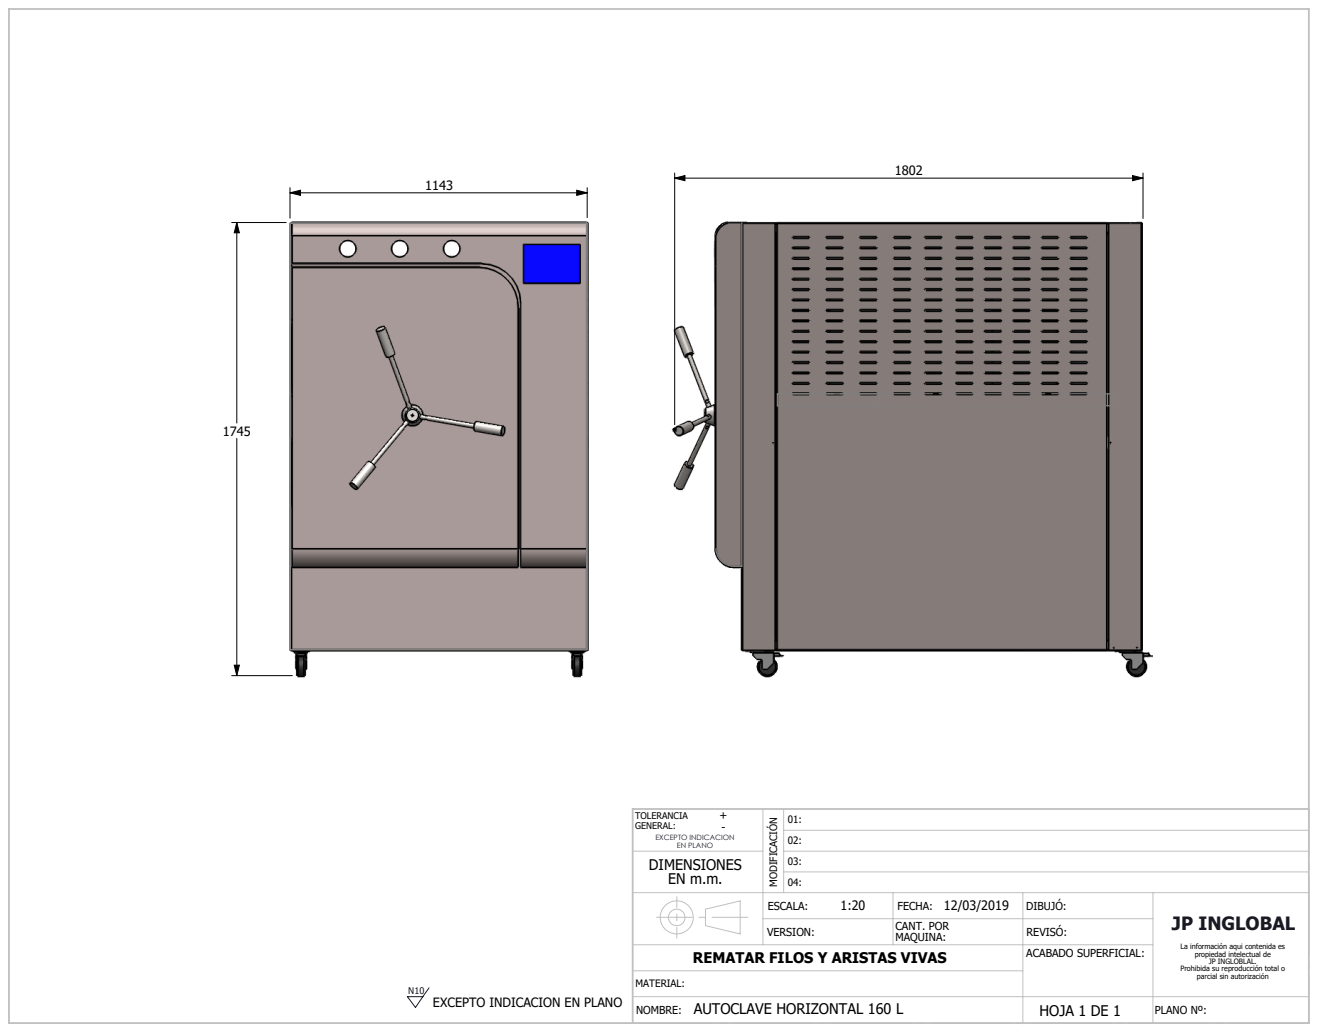
[picture p246: page 1]
JP INGLOBAL; EXCEPTO INDICACION EN PLANO; ACABADO SUPERFICIAL:; TOLERANCIA; + GENERAL:; AUTOCLAVE HORIZONTAL 160 L; HOJA 1 DE 1; PLANO Nº:; CANT. POR

REMATAR FILOS Y ARISTAS VIVAS

La información aqui contenida es
propiedad intelectual de
JP INGLOBLAL.
Prohibida su reproducción total o
parcial sin autorización

EXCEPTO INDICACION EN PLANO
