judapies/Autoclave/(list of files, drawings)

Other design files:
Autoclave Horizontal/Con Precamara/2016/Autoclave 110L/Autoclave ArtiLab/Schematic/Autoclave_27L.DSN
Autoclave Horizontal/Con Precamara/2016/Autoclave 110L/Autoclave ArtiLab/Schematic/Autoclave_27L.LYT
Autoclave Horizontal/Con Precamara/2016/Autoclave 110L/Autoclave ArtiLab/Schematic/Autoclave_80L.LYT
Autoclave Horizontal/Con Precamara/2016/Autoclave 110L/Autoclave ArtiLab/Schematic/MedicionNivelPresion.DSN
Autoclave Horizontal/Con Precamara/2016/Autoclave 110L/Autoclave ArtiLab/Schematic/USB_485 arreglado chasis.LYT
Autoclave Horizontal/Con Precamara/2016/Autoclave 110L/Autoclave Santa Marta/Schematic/AutoclaveCard.DSN
Autoclave Horizontal/Con Precamara/2016/Autoclave 110L/Autoclave Santa Marta/Schematic/AutoclaveCard.LYT
Autoclave Horizontal/Con Precamara/2016/Autoclave 110L/Autoclave Santa Marta/Schematic/USB_485 arreglado chasis.LYT
Autoclave Horizontal/Con Precamara/2016/Autoclave 120L/Autoclave TecniLab/Schematic/AutoclaveCard.DSN
Autoclave Horizontal/Con Precamara/2016/Autoclave 120L/Autoclave TecniLab/Schematic/AutoclaveCard.LYT
Autoclave Horizontal/Con Precamara/2016/Autoclave 120L/Autoclave TecniLab/Schematic/USB_485 arreglado chasis.LYT
Autoclave Horizontal/Con Precamara/2017/Autoclave 110L/Autoclave Avantika #004587601/Schematic/AutoclaveCard.DSN
Autoclave Horizontal/Con Precamara/2017/Autoclave 110L/Autoclave Avantika #004587601/Schematic/AutoclaveCard.LYT
Autoclave Horizontal/Con Precamara/2017/Autoclave 110L/Autoclave Avantika #004587601/Schematic/USB_485 arreglado chasis.LYT
Autoclave Horizontal/Con Precamara/2018/Autoclave 85L con vacio #004587822/Schematic/Control GLCD/AutoclaveCard.pdsprj
Autoclave Horizontal/Con Precamara/2018/Autoclave 85L con vacio #004587822/Schematic/Hardware Com/HardwareI2C.pdsprj
Autoclave Horizontal/Con Precamara/2018/Autoclave 85L con vacio #004587822/Schematic/USB Com/USB_I2C.pdsprj
Autoclave Horizontal/Con Precamara/2018/Autoclave 110L-V3.1 TIM #004587910/Schematic/AutoclaveV5.0.pdsprj
Autoclave Horizontal/Con Precamara/2018/Autoclave 110L-V3.1 TIM #004587910/Schematic/AutoclaveV5.0_MT2.pdsprj
Autoclave Horizontal/Con Precamara/2018/Autoclave 110L-V3.1 TIM #004587910/Schematic/Control GLCD/AutoclaveCard.pdsprj
Autoclave Horizontal/Con Precamara/2018/Autoclave 110L-V3.1 TIM #004587910/Schematic/Control GLCD/PuenteW.pdsprj
Autoclave Horizontal/Con Precamara/2018/Autoclave 110L-V3.1 TIM #004587910/Schematic/USB Com/USB_I2C.pdsprj
Autoclave Horizontal/Con Precamara/2018/Autoclave 110L-V3.1 TIM #004587910/Schematic/USB_GP.LYT
Autoclave Horizontal/Con Precamara/2018/Autoclave 110L-V3.1 TIM #004587911/Schematic/AutoclaveV5.0.pdsprj
Autoclave Horizontal/Con Precamara/2018/Autoclave 110L-V3.1 TIM #004587911/Schematic/AutoclaveV5.0_MT2.pdsprj
Autoclave Horizontal/Con Precamara/2018/Autoclave 110L-V3.1 TIM #004587911/Schematic/Control GLCD/AutoclaveCard.pdsprj
Autoclave Horizontal/Con Precamara/2018/Autoclave 110L-V3.1 TIM #004587911/Schematic/Control GLCD/PuenteW.pdsprj
Autoclave Horizontal/Con Precamara/2018/Autoclave 110L-V3.1 TIM #004587911/Schematic/USB Com/USB_I2C.pdsprj
Autoclave Horizontal/Con Precamara/2018/Autoclave 110L-V3.1 TIM #004587911/Schematic/USB_GP.LYT
Autoclave Horizontal/Con Precamara/2018/Autoclave 120L-V3.1 Doble Puerta UIS #004587929/Schematic/AutoclaveV5.0.pdsprj
Autoclave Horizontal/Con Precamara/2018/Autoclave 120L-V3.1 Doble Puerta UIS #004587929/Schematic/AutoclaveV5.0_MT2.pdsprj
Autoclave Horizontal/Con Precamara/2018/Autoclave 120L-V3.1 Doble Puerta UIS #004587929/Schematic/Control GLCD/AutoclaveCard.pdsprj
Autoclave Horizontal/Con Precamara/2018/Autoclave 120L-V3.1 Doble Puerta UIS #004587929/Schematic/Control GLCD/PuenteW.pdsprj
Autoclave Horizontal/Con Precamara/2018/Autoclave 120L-V3.1 Doble Puerta UIS #004587929/Schematic/USB Com/USB_I2C.pdsprj
Autoclave Horizontal/Con Precamara/2018/Autoclave 120L-V3.1 Doble Puerta UIS #004587929/Schematic/USB_GP.LYT
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
